MSherbinii/Binder-Jet-3D-Printer/Oasis make package 20181230/Electronics/HP45 standalone controller V3/Driver board V3.02/Driver mistake.PNG

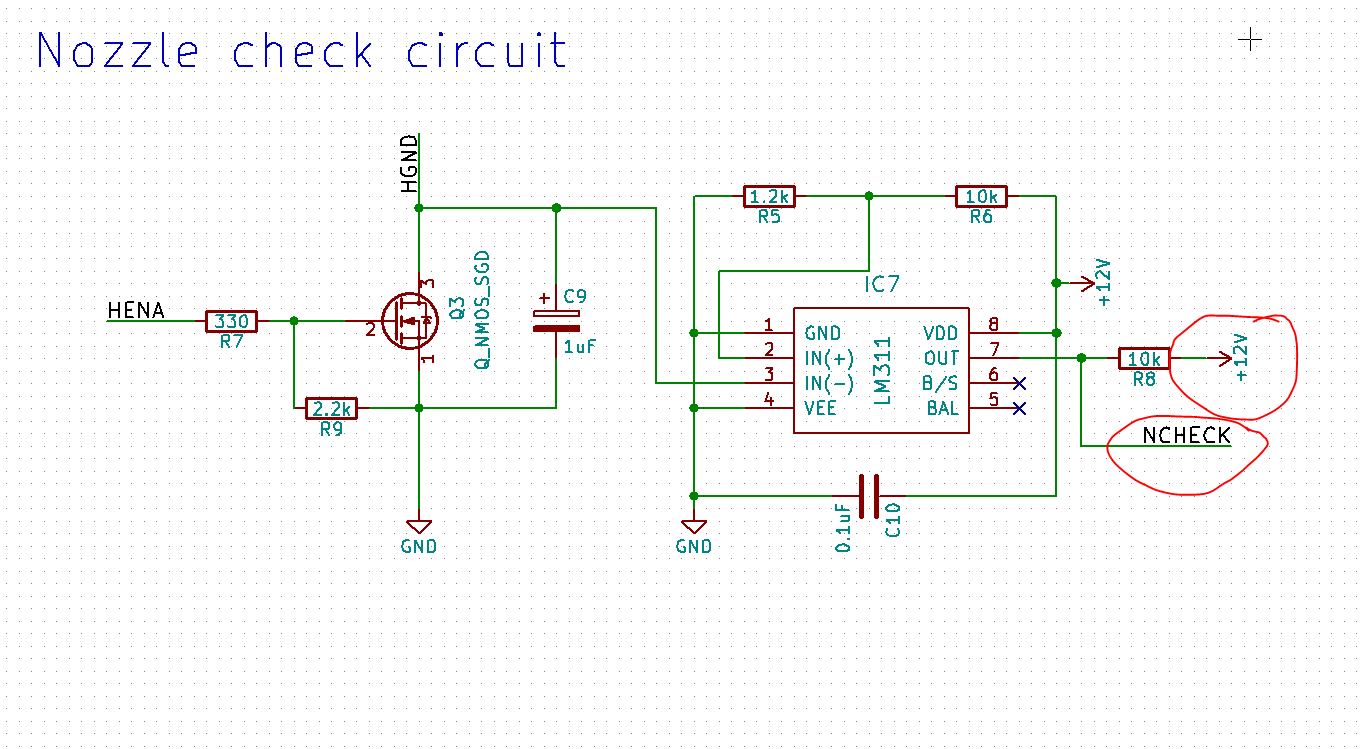
Oasis make package 20181230/Electronics/HP45 standalone controller V3/Driver board V3.02/Driver mistake.PNG
