MSherbinii/Binder-Jet-3D-Printer/Oasis Total BOM 20181018.xlsx

Sheet: Mechanical
ITEM NO. | PART NUMBER | DESCRIPTION | QTY. | suggested supplier | Notes | Suggested Link
1 | 5mm to M8 coupling | Shaft coupler | 2 | Reprapworld.com |  | https://reprapworld.com/products/motors_fans/couplers/z_axis_motor_coupling_m8/
2 | 15mm 150LPI Encoder Strip L=395 | Encoder strip | 1 | Ebay.com |  | https://www.ebay.com/itm/150-LPI-Encoder-Strip-Film-Raster-Film-2-7M-15mm-Format-Inkjet-Printer-2pcs-/271797731785
3 | 230V Input (brandless) | Power supply connector | 1
4 | 608 bearing | Miniature roller bearing | 1 | Misumi / reprapworld.com |  | https://reprapworld.nl/products/mechanisch/kogellagers/afgeschermde_kogellager_608zz/
5 | 624 bearing | Miniature roller bearing | 9 | Misumi / reprapworld.com |  | https://reprapworld.nl/products/mechanisch/kogellagers/afgeschermde_kogellager_624zz/
6 | 625 bearing | Miniature roller bearing | 2 | Misumi / reprapworld.com |  | https://reprapworld.nl/products/mechanisch/kogellagers/afgeschermde_kogellager_625zz/
7 | 685 bearing | Miniature roller bearing | 2 | Misumi / Ebay.com
8 | DIN 0125-1A M3 | Washer | 23
9 | DIN 0125-1A M4 | Washer | 96
10 | DIN 0125-1A M8 | Washer | 4
11 | DIN 0912 M3x6 | Hex socket head cap screw | 2
12 | DIN 0912 M3x10 | Hex socket head cap screw | 50
13 | DIN 0912 M3x20 | Hex socket head cap screw | 6
14 | DIN 0912 M4x12 | Hex socket head cap screw | 74
15 | DIN 0912 M4x20 | Hex socket head cap screw | 28
16 | DIN 0912 M4x30 | Hex socket head cap screw | 13
17 | DIN 0912 M6x12 | Hex socket head cap screw | 60
18 | DIN 0912 M6x16 | Hex socket head cap screw | 3
19 | DIN 0912 M8x30 | Hex socket head cap screw | 5
20 | DIN 0934 M3 | Hex nut | 4
21 | DIN 0934 M8 | Hex nut | 3
22 | DIN 0963 M3x10 | Slotted countersunk head screw | 6
23 | DIN 0963 M3x16 | Slotted countersunk head screw | 14
24 | DIN 0963 M4x12 | Slotted countersunk head screw | 33
25 | DIN 0985 M3 | Prevailing torque hex nut | 20
26 | DIN 0985 M4 | Prevailing torque hex nut | 53
27 | DIN 0985 M6 | Prevailing torque hex nut | 1
28 | DIN 7991 M6x12 | Hex socket countersunk head screw | 8
29 | DIN 9021- M5 | Fender washer | 1
30 | FJSN8-60 | Foot | 4 | Misumi | Any M8 adjustable foot will do
31 | GT2 pulley 20T 6mm | Timing pulley | 6 | Reprapworld.com |  | https://reprapworld.nl/products/mechanisch/riemschijf/gt2_riemschijf_20_tanden_6_mm_riem_5_mm_id/
32 | GT2 x 6mm Timing belt L120 Closed | Timing belt | 1 | Misumi
33 | GT2 x 6mm Timing belt L188 Closed | Timing belt | 1 | Reprapworld.com |  | https://reprapworld.nl/products/mechanisch/timing_belts/gt2x6mm_aandrijfriem_188mm_gesloten/
34 | GT2 x 6mm Timing belt L1000 | Timing belt | 1 | Reprapworld.com |  | https://reprapworld.nl/products/mechanisch/tandriemen/gt2x6mm_tandriem_per_meter/
35 | GT2 x 6mm Timing belt L1300 | Timing belt | 1 | Reprapworld.com |  | https://reprapworld.nl/products/mechanisch/tandriemen/gt2x6mm_tandriem_per_meter/
36 | GT2 x 6mm Timing belt L1500 | Timing belt | 1 | Reprapworld.com |  | https://reprapworld.nl/products/mechanisch/tandriemen/gt2x6mm_tandriem_per_meter/
37 | HBLFSN6 | 30mm single angle | 22 |  | 30x30mm 90 dergee angle
38 | HBLFSSW6 | 30mm double angle | 4 |  | 60x60mm 90 degree angle (double 30)
39 | HEDS-H9720 P | Encoder | 1 | Ebay.com |  | https://www.ebay.com/itm/AVAGO-HEDS-9740-150-Encoder-Optical-Sensor-360-DPI-for-Format-Inkjet-Printer-1-/282562554422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
40 | HFCL6-3030-S | Profile end cap | 10 | misumi | 30x30mm cap
41 | HFS6-3030-228 | 30x30 profile | 2 | misumi | Any 30x30mm, 8mm groove, M8 hole profile will do
42 | HFS6-3030-300 | 30x30 profile | 2 | misumi | Any 30x30mm, 8mm groove, M8 hole profile will do (Tap M8 on one side)
43 | HFS6-3030-315 | 30x30 profile | 3 | misumi | Any 30x30mm, 8mm groove, M8 hole profile will do
44 | HFS6-3030-402 | 30x30 profile | 2 | misumi | Any 30x30mm, 8mm groove, M8 hole profile will do
45 | HFS6-3030-410 | 30x30 profile | 2 | misumi | Any 30x30mm, 8mm groove, M8 hole profile will do
46 | HFS6-3030-480 | 30x30 profile | 2 | misumi | Any 30x30mm, 8mm groove, M8 hole profile will do (Tap M8 on one side)
47 | HFS6-3030-660 | 30x30 profile | 3 | misumi | Any 30x30mm, 8mm groove, M8 hole profile will do
48 | HFS6-3030-719 | 30x30 profile | 2 | misumi | Any 30x30mm, 8mm groove, M8 hole profile will do
49 | HFS6-3060-410 | 30x60 profile | 2 | misumi | Any 30x60mm, 8mm groove, M8 hole profile will do
50 | HFS6-3060-425 | 30x60 profile | 1 | misumi | Any 30x60mm, 8mm groove, M8 hole profile will do (Tap M8 on both sides)
51 | HFS6-3060-630 | 30x60 profile | 2 | misumi | Any 30x60mm, 8mm groove, M8 hole profile will do
52 | HHPSN6 | Hinge | 2 | misumi | Heart of hole to heart of hinge >15mm
53 | HNTAP6-3 | Profile nut M3 | 19 | misumi | M3 nut compatible with profile
54 | HNTAP6-4 | Profile nut M4 | 91 | misumi | M4 nut compatible with profile
55 | HNTAP6-6 | Profile nut M6 | 68 | misumi | M6 nut compatible with profile
56 | HP45 | Inkjet printhead | 1
57 | HP45 Standalone V3.00 PCBs | Inkjet controller | 1 | Ytec3D.com / Tindie
58 | LM8UU | Lineair bearing | 4
59 | MGN12 - L400 | Linear guide rail | 1 | Reprapworld.com |  | https://reprapworld.nl/products/lineaire_geleiding/mgn12_vierkant_slider_40_cm/#productdetail_doc
60 | MGN12 - L600 | Linear guide rail | 1 | Reprapworld.com |  | https://reprapworld.nl/products/lineaire_geleiding/mgn12_vierkante_slider_60_cm/
61 | MGN12H | Linear guide carriage | 2 | Reprapworld.com | 2 should have come with rail, additional 2 optional
62 | OA-Y10-P01-00 | Cover plate | 1
63 | OA-Y10-P02-00 | Guide shaft | 1
64 | OA-Y10-P03-00 | Shaft Mount | 1
65 | OA-Y10-P04-00 | Base Front cover | 1
66 | OA-Y10-P05-00 | Riser block | 1
67 | OA-Y10-P06-00 | Idler block | 1
68 | OA-Y10-P07-00 | Idler block | 1
69 | OA-Y10-P08-00 | Drive shaft | 1
70 | OA-Y10-P09-00 | Motor Block | 1
71 | OA-Y10-P10-00 | Back plate | 1
72 | OA-Y10-P11-00 | Top lid panel | 1
73 | OA-Y10-P12-00 | Side lid panel | 2
74 | OA-Y10-P13-00 | Front lid panel | 1
75 | OA-Y10-P15-00 | Front plate mount | 5
76 | OA-Y10-P16-00 | Bin rail | 1
77 | OA-Y10-P17-00 | Cable feedthrough | 1
78 | OA-Y10-P18-01 | Endstop counter block | 1
79 | OA-Y10-P20-00 | Side panel | 1
80 | OA-Y10-P21-00 | Lid stopper | 2
81 | OA-Y10-P22-00 | Cover end | 2
82 | OA-Y10-P23-00 | Bin rail | 2
83 | OA-Y10-P24-00 | Spacer | 2
84 | OA-Y10-P25-00 | Power inlet | 1 |  | Optional, depends on 230V power input
85 | OA-Y10-P26-00 | Shaft Mount | 1
86 | OA-Y10-P27-00 | Idler block | 1
87 | OA-Y15-P01-00 | Bin bottom | 1
88 | OA-Y15-P02-00 | Bin Side | 1
89 | OA-Y15-P04-00 | Bin Back | 2
90 | OA-Y15-P05-00 | Bin Side | 1
91 | OA-Y20-P01-01 | Gantry Free block | 1
92 | OA-Y20-P03-01 | Gantry fixed block | 1
93 | OA-Y20-P04-00 | Spreader Mount | 1
94 | OA-Y20-P04-00-M | Spreader mount | 1
95 | OA-Y20-P05-00 | Encoder Ribon End Block | 2
96 | OA-Y20-P06-01 | Motor mount | 1
97 | OA-Y20-P07-00 | Spreader pulley | 1
98 | OA-Y20-P08-00 | Endstop mount | 1
99 | OA-Y20-P10-00 | Cable pickup | 1
100 | OA-Y20-P11-00 | Cable support | 5
101 | OA-Y20-P12-00 | Cable mount | 1
102 | OA-Y20-P13-00 | Rotary shaft | 1 |  | DIY version, can be bought at misumi: SSFRHQ20-200-F20-P5-T20-Q5
103 | OA-Y30-P01-02 | Carriage block | 1
104 | OA-Y30-P02-01 | Belt clamp T2.5 | 6
105 | OA-Y30-P03-03 | Head carrier | 1
106 | OA-Y30-P04-00 | Cable pickup | 1
107 | OA-Y30-P05-01 | Head mounting bracket | 2
108 | OA-Y30-P06-00 | Head arm | 2
109 | OA-Y30-P07-00 | Head arm | 1
110 | OA-Y30-P08-00 | Head clamp | 1
111 | OA-Y40-P06-00 | Baseplate | 1
112 | OA-Y40-P07-00 | Overshoot riser | 1
113 | OA-Y40-P08-00 | Overshoot guide | 1
114 | OA-Y40-P09-00 | Hopper cilinder | 2
115 | OA-Y40-P10-00 | Hopper cilinder mount | 8
116 | OA-Y40-P11-00 | Piston bottom | 2
117 | OA-Y40-P12-00 | Bin gasket | 1
118 | OA-Y50-P02-00 | Piston lead screw | 2
119 | OA-Y50-P03-00 | Piston guide rod | 4
120 | OA-Y50-P07-00 | Piston base | 2
121 | OA-Y50-P08-00 | Piston motor bracket | 4
122 | OA-Y50-P09-00 | Piston seal | 4
123 | Omron 5e4t85 | Microswitch | 2 | Reprapworld.com |  | https://reprapworld.nl/products/elektronica/endstops/miniatuur_microswitch/
124 | Stepper NEMA 17 42BYGHW208 | Stepper motor | 2 | Reprapworld.com | max size 42x42x34mm
125 | Stepper NEMA 17 42BYGHW609 | Nema 42 stepper motor | 1 | Reprapworld.com | Max size 42x42x40mm | https://reprapworld.nl/products/motoren_fans/stepper_motors/nema17_stappenmotor_1_8_stap_4_08_kg_cm/
126 | Stepper NEMA 17 42BYGHW811 | NEMA 42 stepper motor | 1 | Reprapworld.com | Can be: Stepper NEMA 17 42BYGHW609 ass well Max size 42x42x40
127 | Universal 25mm gear motor | 25mm motor | 1 | Ebay.com | 300rpm adviced | https://www.ebay.com/itm/300RPM-Steel-25mm-DC-12V-High-Torque-Gear-Box-Powerful-motor-Electric-Motor/122759717586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
128 | UPCDG117 | Handle | 2

Sheet: Electrical
Qty. | Part name | type | Driver pad name | Controller pad name | Value | Package | remark
6 | SMD filter capacitor | Capacitor | C1, C6, C7, C8, C10, C11 |  | 0.1uF | SMD: 0603 | Minimum voltage: 16V
2 | SMD filter capacitor | Capacitor | C2, C4 |  | 1uF | SMD: 0603 | Minimum voltage: 16V
1 | SMD Electrol. Capacitor | Electrolytic capacitor | C9 |  | 1uF | Ø4x5.8 | Minimum voltage: 16V, height can vary
4 | SMD Electrol. Capacitor | Electrolytic capacitor | C3, C5 | C1, C2 | 100uF | Ø8x10 | Minimum voltage: 16V, height can vary
3 | SMD resistor | Resistor | R7, R11, R12 |  | 330Ω | SMD: 0603 | 1% preferred, power unimportant (>0,1W)
1 | SMD resistor | Resistor | R5 |  | 1,2kΩ | SMD: 0603 | 1% preferred, power unimportant (>0,1W)
6 | SMD resistor | Resistor | R1, R2, R3, R4, R9, R10 |  | 2,2kΩ | SMD: 0603 | 1% preferred, power unimportant (>0,1W)
2 | SMD resistor | Resistor | R6, R8 |  | 10kΩ | SMD: 0603 | 1% preferred, power unimportant (>0,1W)
1 | HCF4081 | IC | IC5 |  |  | SOIC-14 3.9x8.7mm | 15V power minimum
3 | HEF4017 | IC | IC1, IC3, IC6 |  |  | SOIC-16 3.9x9.9mm | 15V power minimum
2 | TLC59213 | IC | IC2, IC4 |  |  | TSSOP-20 4.4x6.5mm
1 | LM311 | IC | IC7 |  |  | SOIC-8 3.9x4.9mm
4 | Random smd diode | Diode |  | D1, D2, D3, D4 |  | SMD: 0603 | Optional static protection for encoder
1 | 7805 | Power regulator | U1 |  |  | TO-263-2
2 | PMV20XNER | Mosfet | Q1, Q2 |  |  | SOT-23 | Gate voltage < 3V
1 | SIRA12DP-T1-GE3 | Mosfet | Q3 |  |  | SO-8 (PowerPAK) | Low on resistance, non-power pack allowed
1 | HP45 connector | Connector | Con1 |  |  | 52 pin SMD | https://www.tindie.com/products/Dragonator/hp45-printhead-connector/
2 | Female header 1x16 | Connector | J1, J2 |  |  | 2,54mm pitch
2 | Male header 1x16 | Connector |  | J4, J5 |  | 2,54mm pitch
1 | Female header 1x3 | Connector |  | J6 |  | 2,54mm pitch | Optional
1 | Female header 1x4 | Connector |  | J3 |  | 2,54mm pitch | Optional
1 | Female header 1x5 | Connector |  | J2 |  | 2,54mm pitch | Optional
1 | Female headers for Teensy | Connector |  | (not on PCB) |  | 2,54mm pitch | Optional. 1x14 (2x), 1x5, 1x3 and 2x7 (or 2x 1x7)
1 | Screw terminal 1x3 | Connector |  | J1 |  | 1x3 3,5mm
1 | Teensy 3,2 | Microcontroller |  | uC1 |  | Teensy 3.2 w. header | Teensy may require additional male headers: 1x14 (2x), 1x5, 1x3 and SMD 2x7 @2,54mm
Other electronics
Qty. | Description |  | Part number
1 | HP45 standalone driver board
1 | HP45 standalone controller board
1 | 12V Power supply, 20A
2 | Fuse holder
2 | Fuse 10A
1 | Arduino UNO
1 | Arduino UNO CNC shield V3
1 | USB B cable
1 | USB Micro cable
2 | Microswitch
1 | N channel mosfet (Gate voltage < 5V, current > 2A)
1 | Resistor R330
1 | Resistor R10k
1 | Resistor R1k
1 | LED
1 | Ribbon cable 10 wire
1 | Optical encoder sensor |  | AVAGO HEDS-9740#150
plenty | zip-ties

Sheet: KiCAD Raw
Information on this page is RAW KiCad output and is for reference only!
HP45 Standalone V3,00 Driver
ref | value5 | footprint | lib | part
C1 | 0.1uF | Capacitors_SMD:C_0603 | device | C
C11 | 0.1uF | Capacitors_SMD:C_0603 | device | C
C10 | 0.1uF | Capacitors_SMD:C_0603 | device | C
C6 | 0.1uF | Capacitors_SMD:C_0603 | device | C
C8 | 0.1uF | Capacitors_SMD:C_0603 | device | C
C7 | 0.1uF | Capacitors_SMD:C_0603 | device | C
R5 | 1.2k | Resistors_SMD:R_0603 | device | R
C3 | 100uF | Capacitors_SMD:CP_Elec_8x10 | device | CP
C5 | 100uF | Capacitors_SMD:CP_Elec_8x10 | device | CP
R6 | 10k | Resistors_SMD:R_0603 | device | R
R8 | 10k | Resistors_SMD:R_0603 | device | R
C4 | 1uF | Capacitors_SMD:C_0603 | device | C
C9 | 1uF | Capacitors_SMD:CP_Elec_4x5.8 | device | CP
C2 | 1uF | Capacitors_SMD:C_0603 | device | C
R1 | 2.2k | Resistors_SMD:R_0603 | device | R
R2 | 2.2k | Resistors_SMD:R_0603 | device | R
R3 | 2.2k | Resistors_SMD:R_0603 | device | R
R4 | 2.2k | Resistors_SMD:R_0603 | device | R
R10 | 2.2k | Resistors_SMD:R_0603 | device | R
R9 | 2.2k | Resistors_SMD:R_0603 | device | R
R7 | 330 | Resistors_SMD:R_0603 | device | R
R11 | 330 | Resistors_SMD:R_0603 | device | R
R12 | 330 | Resistors_SMD:R_0603 | device | R
J1 | CONN_01X16 | Socket_Strips:Socket_Strip_Straight_1x16_Pitch2.54mm | conn | CONN_01X16
J2 | CONN_01X16 | Socket_Strips:Socket_Strip_Straight_1x16_Pitch2.54mm | conn | CONN_01X16
IC5 | HCF4081 | Housings_SOIC:SOIC-14_3.9x8.7mm_Pitch1.27mm | HP45 controller parts | HCF4081
IC1 | HEF4017 | Housings_SOIC:SOIC-16_3.9x9.9mm_Pitch1.27mm | HP45 controller parts | HEF4017
IC3 | HEF4017 | Housings_SOIC:SOIC-16_3.9x9.9mm_Pitch1.27mm | HP45 controller parts | HEF4017
IC6 | HEF4017 | Housings_SOIC:SOIC-16_3.9x9.9mm_Pitch1.27mm | HP45 controller parts | HEF4017
Con1 | HP45_connector | Electronics:HP45_SMD_connector | HP45 controller parts | HP45_connector
IC7 | LM311 | Housings_SOIC:SOIC-8_3.9x4.9mm_Pitch1.27mm | HP45 controller parts | LM311
Q2 | Q_NMOS_GSD | TO_SOT_Packages_SMD:SOT-23 | device | Q_NMOS_GSD
Q1 | Q_NMOS_GSD | TO_SOT_Packages_SMD:SOT-23 | device | Q_NMOS_GSD
Q3 | Q_NMOS_SGD | Electronics:SO-8_PowerPAK | device | Q_NMOS_SGD
IC2 | TLC59213 | Housings_SSOP:TSSOP-20_4.4x6.5mm_Pitch0.65mm | HP45 controller parts | TLC59213
IC4 | TLC59213 | Housings_SSOP:TSSOP-20_4.4x6.5mm_Pitch0.65mm | HP45 controller parts | TLC59213
PCB | HP45 standalone driver board
HP45 Standalone V3,00 controller
ref | value5 | footprint | lib | part
C2 | 100uF | Capacitors_SMD:CP_Elec_8x10 | device | CP
C1 | 100uF | Capacitors_SMD:CP_Elec_8x10 | device | CP
U1 | 7805 | TO_SOT_Packages_SMD:TO-263-2 | HP45 Standalone V3.00 Controller-cache | 7805-RESCUE-OA-HP45C3_Controller
J6 | CONN_01X03 | Socket_Strips:Socket_Strip_Straight_1x03_Pitch2.54mm | conn | CONN_01X03
J3 | CONN_01X04 | Socket_Strips:Socket_Strip_Straight_1x04_Pitch2.54mm | conn | CONN_01X04
J2 | CONN_01X05 | Socket_Strips:Socket_Strip_Straight_1x05_Pitch2.54mm | conn | CONN_01X05
J4 | CONN_01X16 | Socket_Strips:Socket_Strip_Straight_1x16_Pitch2.54mm | conn | CONN_01X16
J5 | CONN_01X16 | Socket_Strips:Socket_Strip_Straight_1x16_Pitch2.54mm | conn | CONN_01X16
D2 | D | Diodes_SMD:D_0603 | device | D
D1 | D | Diodes_SMD:D_0603 | device | D
D3 | D | Diodes_SMD:D_0603 | device | D
D4 | D | Diodes_SMD:D_0603 | device | D
JP1 | Jumper | Connectors:GS2 | device | Jumper
J1 | Screw_Terminal_1x03 | Electronics:3.5mm_screw_terminal | conn | Screw_Terminal_1x03
uC1 | Teensy_3.2_custom | Electronics:Teensy_3.2_custom | HP45 controller parts | Teensy_3.2_custom
PCB | HP45 standalone driver board
