MSherbinii/Binder-Jet-3D-Printer/Oasis lifting spreader A21 20181208/OA-Y21-A01-00 PnG20181208/OA-Y21-A01-00.SLDASM

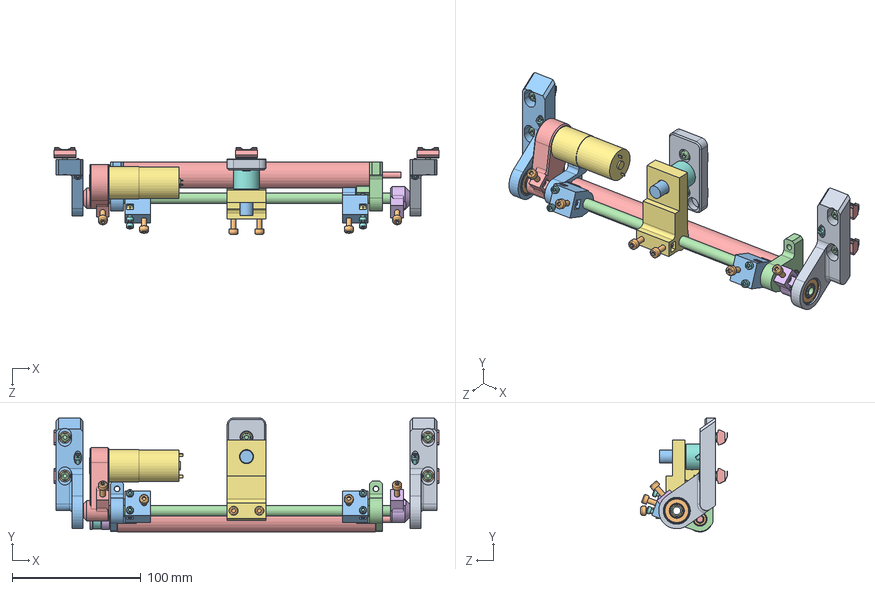
[picture p3: CAD file, 2022-12-10]
Oasis lifting spreader A21 20181208/OA-Y21-A01-00 PnG20181208/OA-Y21-A01-00.SLDASM
299.0 x 88.5 x 67.2 mm
OA-Y21-P01-00
608 bearing x 2
OA-Y21-P01-00-M
OA-Y21-P02-00
SSFRHQ20-200-F20-P5-T20-Q5
GT2 pulley 20T 6mm
Universal 25mm gear motor
GT2 x 6mm Timing belt L120 Closed
OA-Y20-P07-00
685 bearing x 2
OA-Y21-P03-00
OA-Y21-P03-00-M
OA-Y21-P04-00
OA-Y21-P05-00
OA-Y21-P06-00
Solenoid nmm
OA-Y21-P08-00
DIN 0125-1A M4 x 6
OA-Y21-P09-00 x 2
DIN 0912 M4x12 x 6
HNTAP6-4 x 6
DIN 0912 M3x6 x 3
DIN 0985 M3 x 6
DIN 0912 M3x20 x 6
DIN 0985 M4 x 8
DIN 0912 M4x20 x 6
DIN 7991 M10x20
