MSherbinii/Binder-Jet-3D-Printer/Oasis lifting spreader A21 20181208/OA-Y21-A01-00 PnG20181208/OA-Y21-P01-00-M.SLDPRT

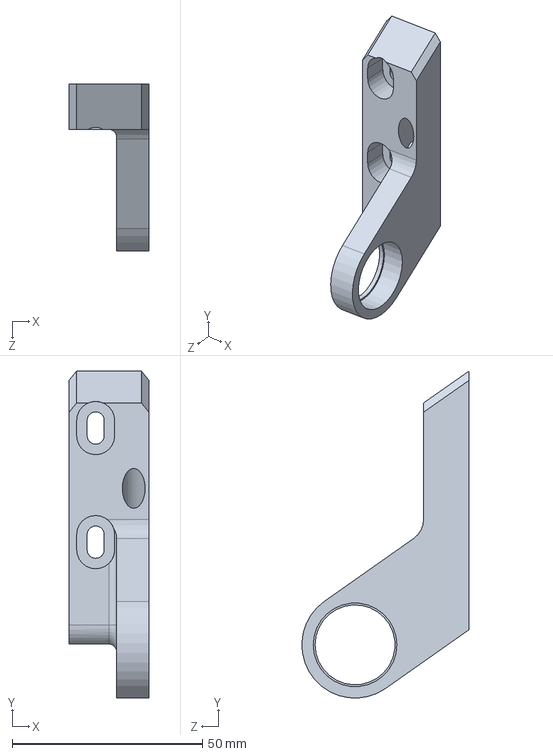
[picture p4: CAD file, 2022-12-10]
Oasis lifting spreader A21 20181208/OA-Y21-A01-00 PnG20181208/OA-Y21-P01-00-M.SLDPRT
21.0 x 86.0 x 44.0 mm
