MSherbinii/Binder-Jet-3D-Printer/Oasis lifting spreader A21 20181208/STL/OA-Y21-P03-00.STL

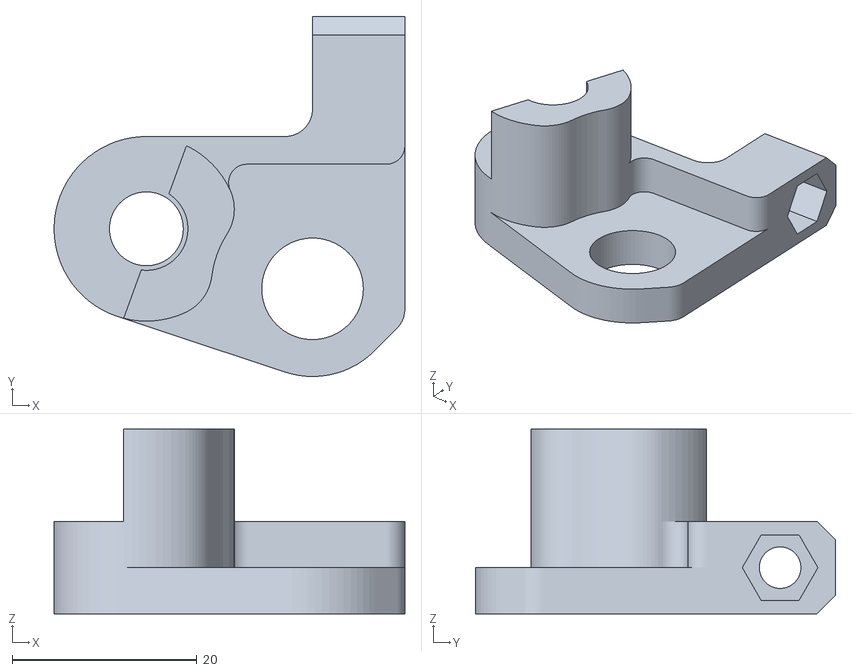
[picture p5: CAD file, 2022-12-10]
Oasis lifting spreader A21 20181208/STL/OA-Y21-P03-00.STL
38.0 x 39.0 x 20.0
