MSherbinii/Binder-Jet-3D-Printer/Oasis make package 20181230/Electronics/3D files/HP45 Standalone V3.00 PCBs.SLDPRT

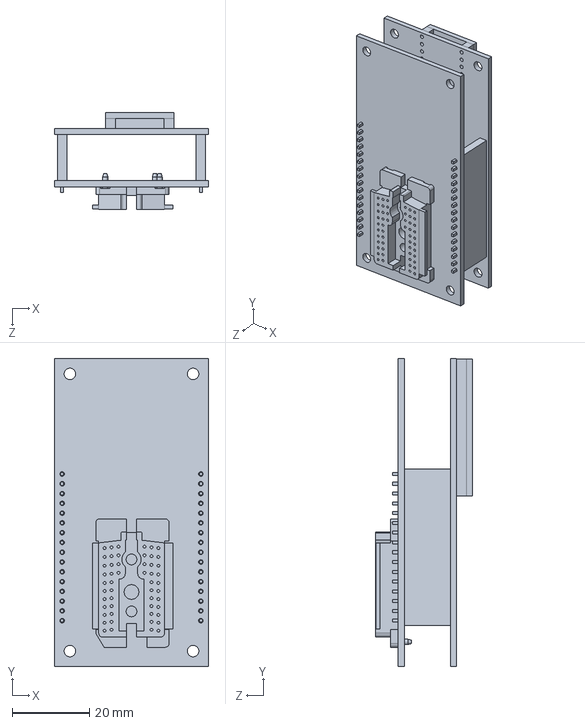
[picture p6: CAD file, 2022-12-10]
Oasis make package 20181230/Electronics/3D files/HP45 Standalone V3.00 PCBs.SLDPRT
40.0 x 80.0 x 25.2 mm
