MSherbinii/Binder-Jet-3D-Printer/Oasis make package 20181230/Mechanical/OA-Y10 Baseframe/OA-Y10-P23-00.STEP

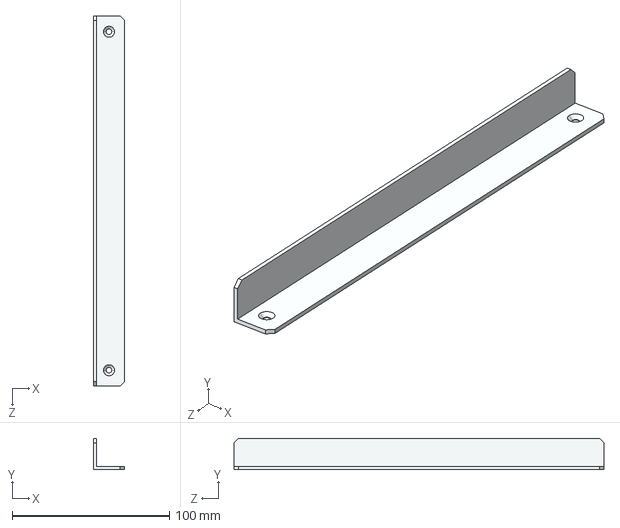
[picture p7: CAD file, 2022-12-10]
Oasis make package 20181230/Mechanical/OA-Y10 Baseframe/OA-Y10-P23-00.STEP
20.0 x 20.0 x 235.0 mm
