MSherbinii/Binder-Jet-3D-Printer/Oasis make package 20181230/Mechanical/OA-Y15 Overshoot bin/OA-Y15-P05-00.STEP

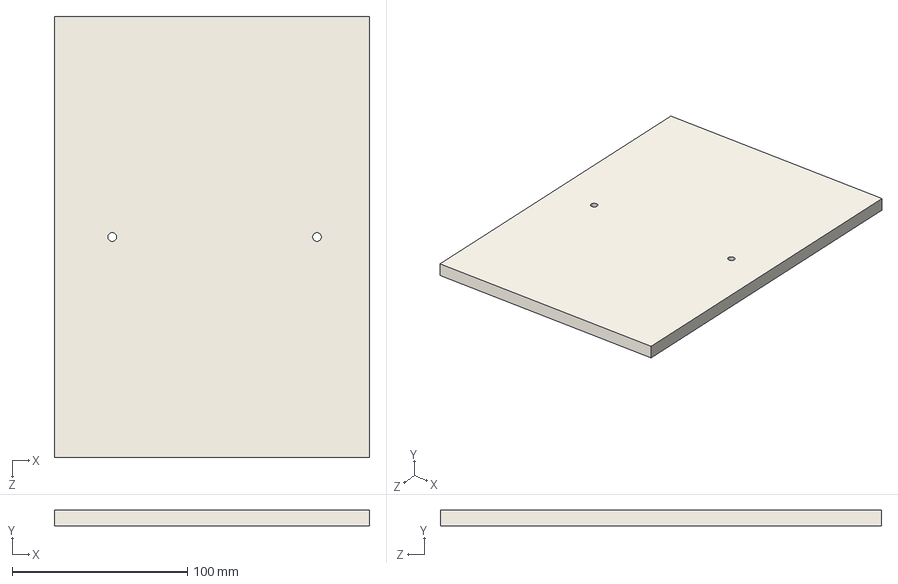
[picture p8: CAD file, 2022-12-10]
Oasis make package 20181230/Mechanical/OA-Y15 Overshoot bin/OA-Y15-P05-00.STEP
180.0 x 9.00 x 252.0 mm
