MSherbinii/Binder-Jet-3D-Printer/Oasis make package 20181230/Mechanical/OA-Y20 Gantry/OA-Y20-P03-01.STEP

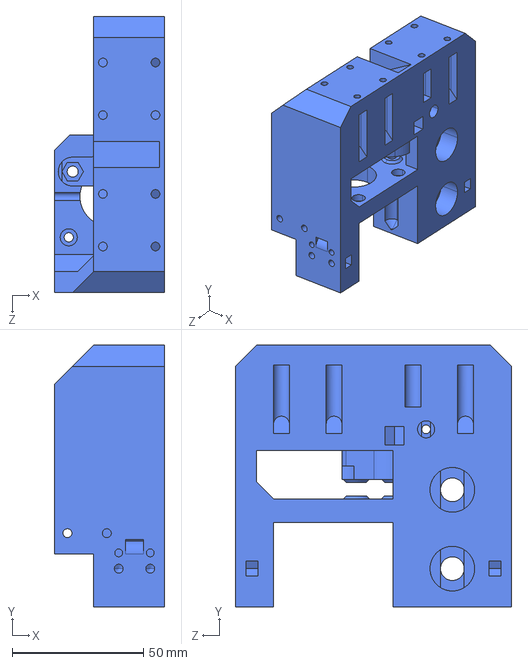
[picture p9: CAD file, 2022-12-10]
Oasis make package 20181230/Mechanical/OA-Y20 Gantry/OA-Y20-P03-01.STEP
42.0 x 99.5 x 105.0 mm
