MSherbinii/Binder-Jet-3D-Printer/Oasis make package 20181230/Mechanical/OA-Y30 Carriage/OA-Y30-P06-00.STEP

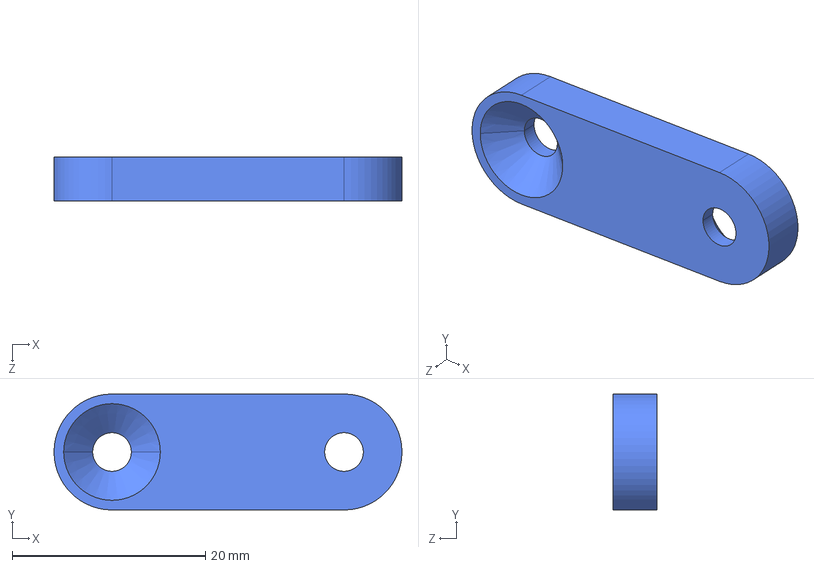
[picture p10: CAD file, 2022-12-10]
Oasis make package 20181230/Mechanical/OA-Y30 Carriage/OA-Y30-P06-00.STEP
36.0 x 12.0 x 4.50 mm
