MSherbinii/Binder-Jet-3D-Printer/Oasis make package 20181230/Mechanical/OA-Y40 Build surface/OA-Y40-P08-00.STEP

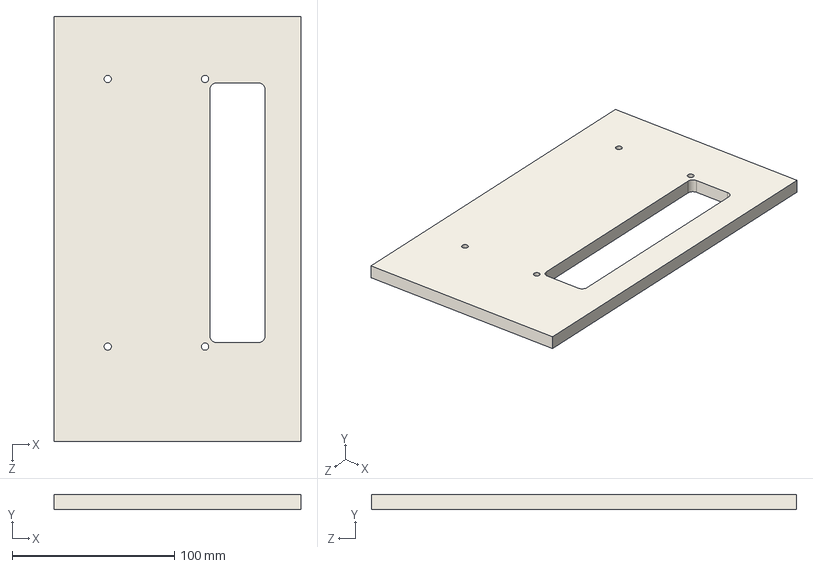
[picture p11: CAD file, 2022-12-10]
Oasis make package 20181230/Mechanical/OA-Y40 Build surface/OA-Y40-P08-00.STEP
152.0 x 9.00 x 262.0 mm
