MSherbinii/Binder-Jet-3D-Printer/Oasis make package 20181230/Mechanical/OA-Y60 Additional tools/OA-Y60-P01-00.STEP

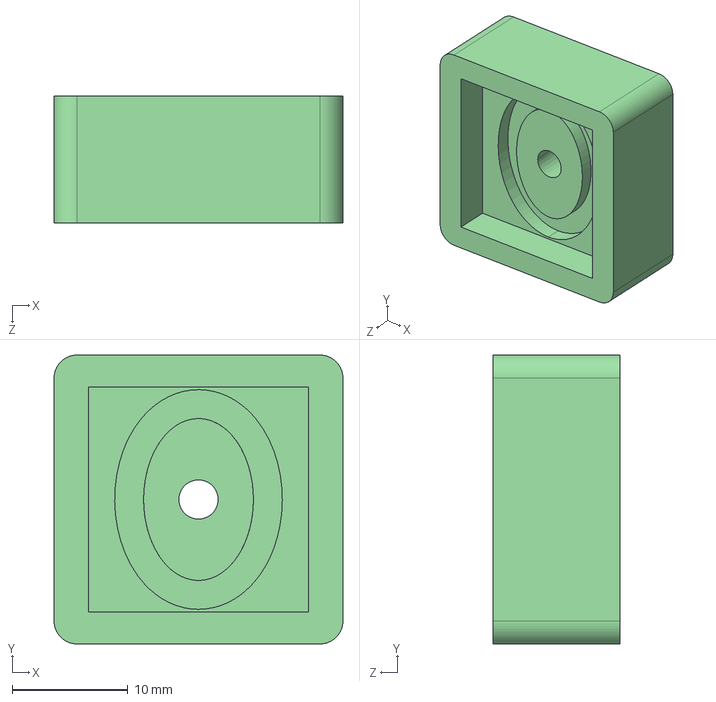
[picture p12: CAD file, 2022-12-10]
Oasis make package 20181230/Mechanical/OA-Y60 Additional tools/OA-Y60-P01-00.STEP
25.0 x 25.0 x 11.0 mm
