MSherbinii/Binder-Jet-3D-Printer/Oasis lifting spreader A21 20181208/OA-Y21-A01-00 PnG20181208/HNTAP6-4.SLDPRT

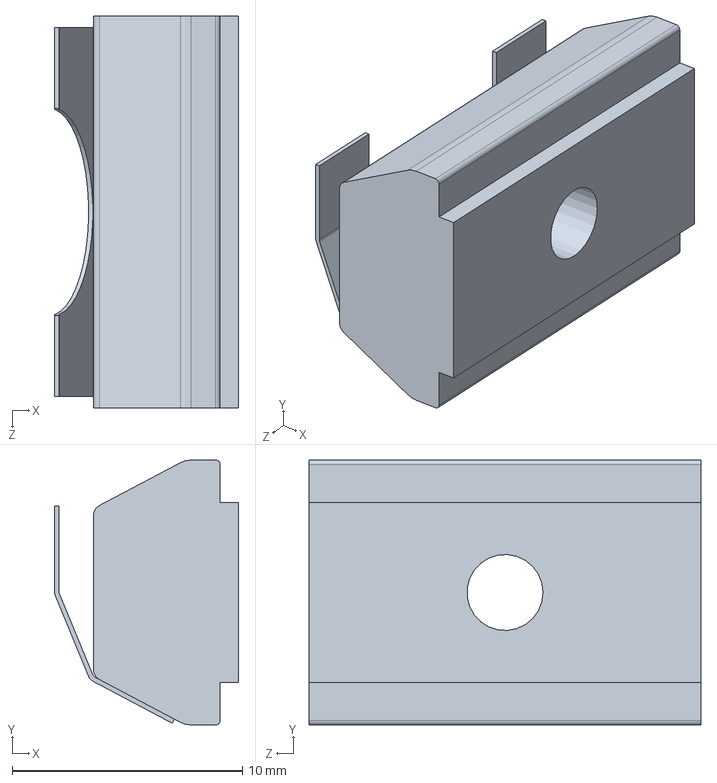
[picture p13: CAD file, 2022-12-10]
Oasis lifting spreader A21 20181208/OA-Y21-A01-00 PnG20181208/HNTAP6-4.SLDPRT
8.00 x 11.5 x 17.0 mm
