MSherbinii/Binder-Jet-3D-Printer/Oasis lifting spreader A21 20181208/STL/OA-Y21-P08-00.STL

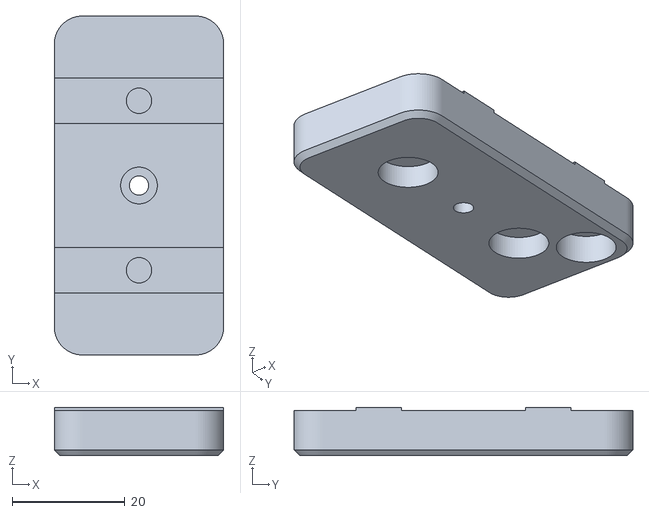
[picture p14: CAD file, 2022-12-10]
Oasis lifting spreader A21 20181208/STL/OA-Y21-P08-00.STL
30.0 x 60.0 x 8.50
