MSherbinii/Binder-Jet-3D-Printer/Oasis make package 20181230/Electronics/3D files/HP45 Breakout CS3.SLDPRT

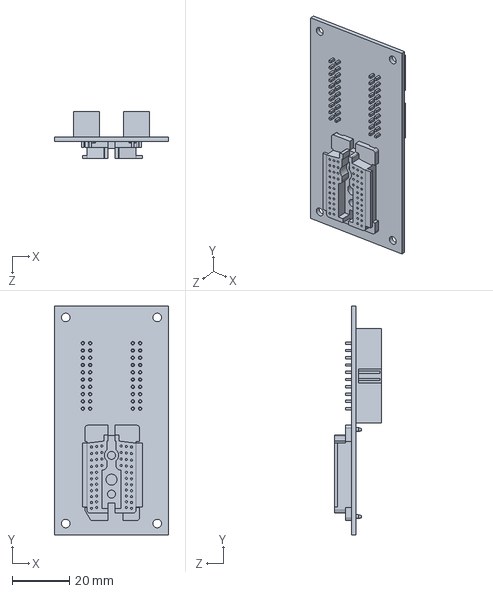
[picture p15: CAD file, 2022-12-10]
Oasis make package 20181230/Electronics/3D files/HP45 Breakout CS3.SLDPRT
40.0 x 80.0 x 16.5 mm
