MSherbinii/Binder-Jet-3D-Printer/Oasis make package 20181230/Mechanical/OA-Y10 Baseframe/OA-Y10-P20-00.STEP

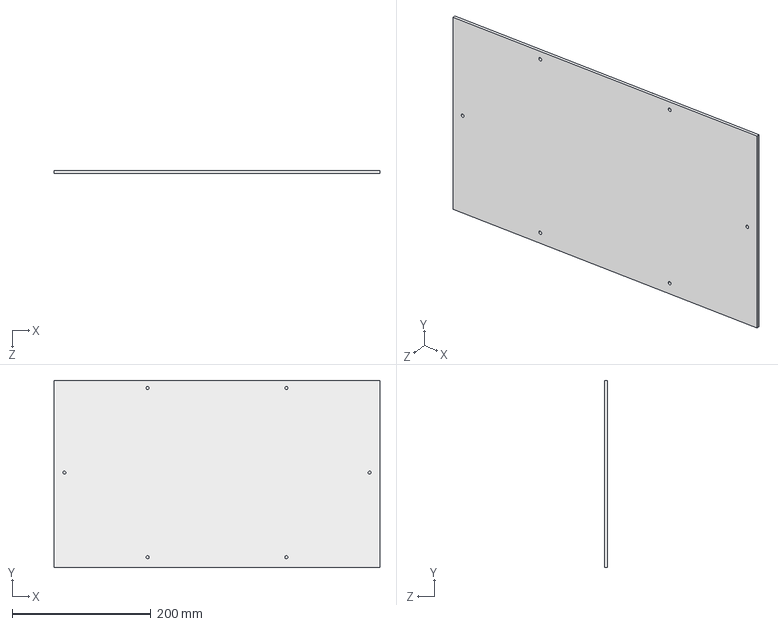
[picture p16: CAD file, 2022-12-10]
Oasis make package 20181230/Mechanical/OA-Y10 Baseframe/OA-Y10-P20-00.STEP
470.0 x 270.0 x 4.00 mm
