MSherbinii/Binder-Jet-3D-Printer/Oasis make package 20181230/Mechanical/OA-Y20 Gantry/OA-Y20-P13-00.STEP

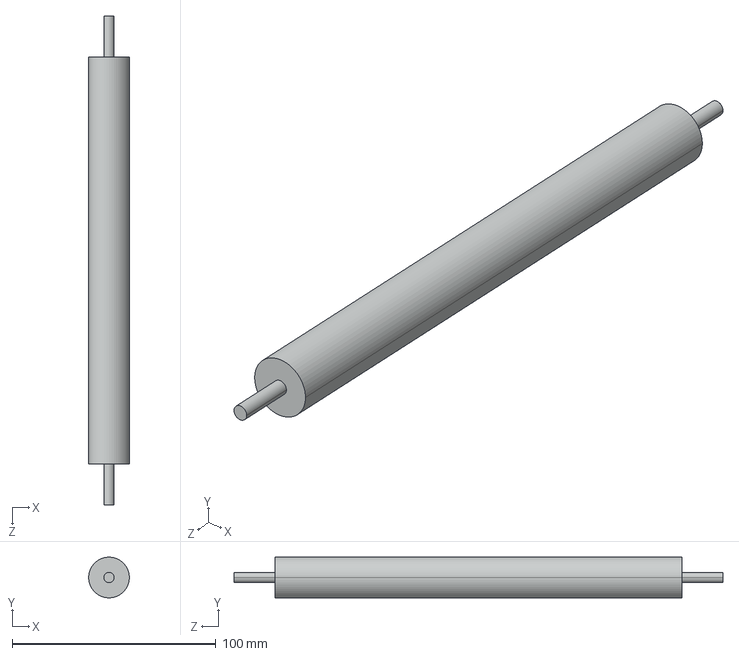
[picture p18: CAD file, 2022-12-10]
Oasis make package 20181230/Mechanical/OA-Y20 Gantry/OA-Y20-P13-00.STEP
20.0 x 20.0 x 240.0 mm
