MSherbinii/Binder-Jet-3D-Printer/Oasis make package 20181230/Mechanical/OA-Y30 Carriage/OA-Y30-P01-02.STEP

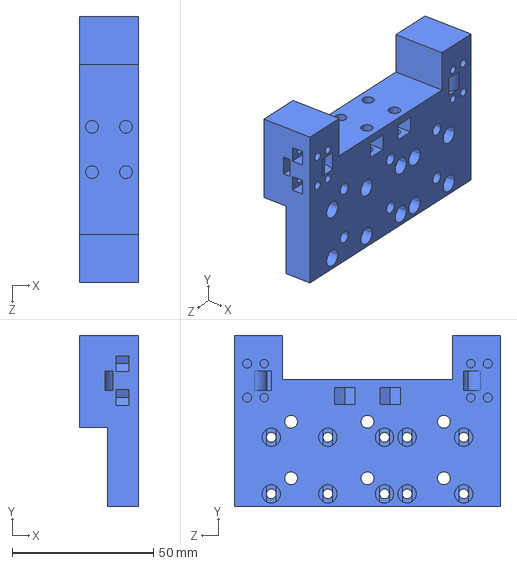
[picture p19: CAD file, 2022-12-10]
Oasis make package 20181230/Mechanical/OA-Y30 Carriage/OA-Y30-P01-02.STEP
21.0 x 60.5 x 94.0 mm
