MSherbinii/Binder-Jet-3D-Printer/Oasis make package 20181230/Mechanical/OA-Y40 Build surface/OA-Y40-P07-00.STEP

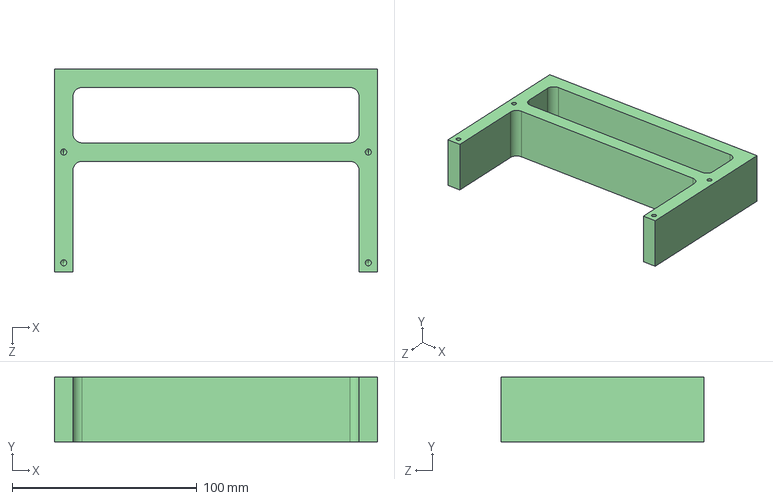
[picture p20: CAD file, 2022-12-10]
Oasis make package 20181230/Mechanical/OA-Y40 Build surface/OA-Y40-P07-00.STEP
175.0 x 35.0 x 110.0 mm
