MSherbinii/Binder-Jet-3D-Printer/Oasis make package 20181230/Mechanical/OA-Y50 Piston/OA-Y50-P07-00.STEP

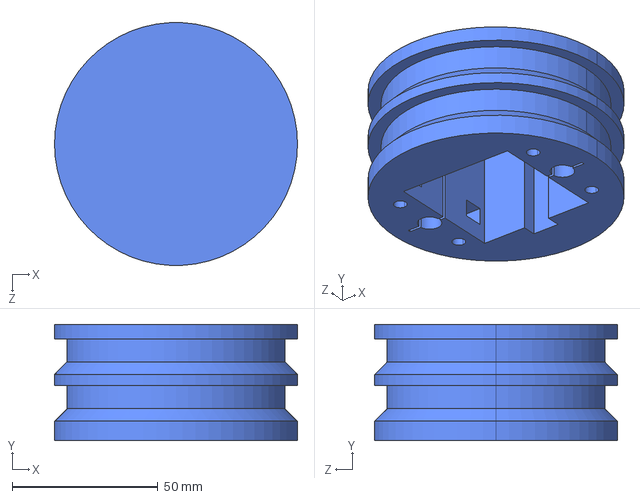
[picture p21: CAD file, 2022-12-10]
Oasis make package 20181230/Mechanical/OA-Y50 Piston/OA-Y50-P07-00.STEP
83.5 x 40.0 x 83.4 mm
