MSherbinii/Binder-Jet-3D-Printer/Oasis source files 20181014/Electrical/HP45 Standalone V3.00/3D files/HP45 Breakout CS3.STEP

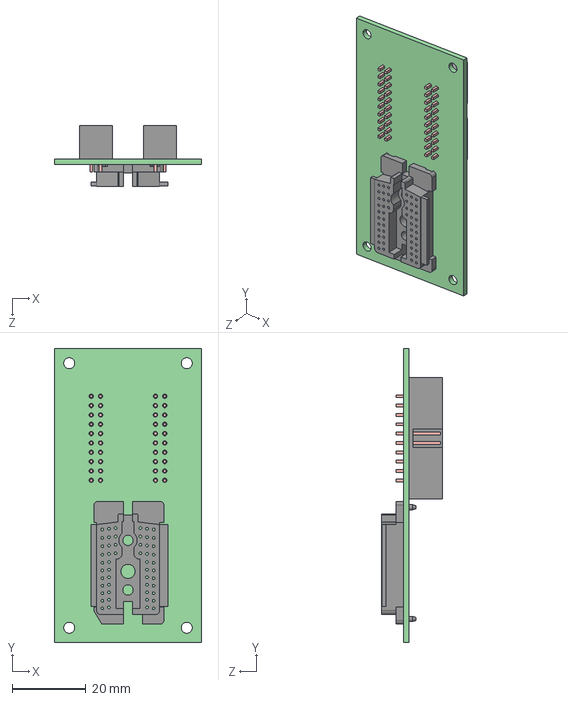
[picture p22: CAD file, 2022-12-10]
Oasis source files 20181014/Electrical/HP45 Standalone V3.00/3D files/HP45 Breakout CS3.STEP
40.0 x 80.0 x 16.5 mm
