MSherbinii/Binder-Jet-3D-Printer/Oasis lifting spreader A21 20181208/OA-Y21-A01-00 PnG20181208/Universal 25mm gear motor.SLDPRT

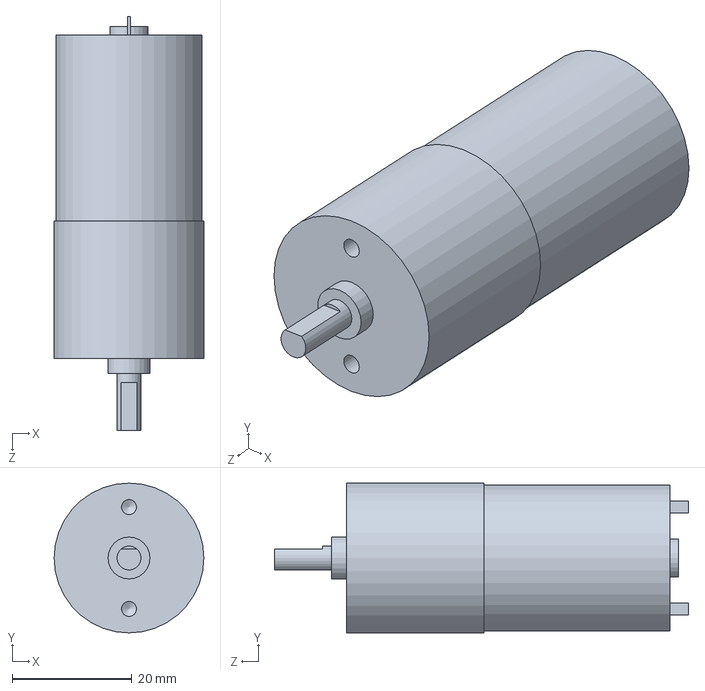
[picture p23: CAD file, 2022-12-10]
Oasis lifting spreader A21 20181208/OA-Y21-A01-00 PnG20181208/Universal 25mm gear motor.SLDPRT
25.0 x 25.0 x 69.1 mm
