MSherbinii/Binder-Jet-3D-Printer/Oasis lifting spreader A21 20181208/STL/OA-Y21-P06-00.STL

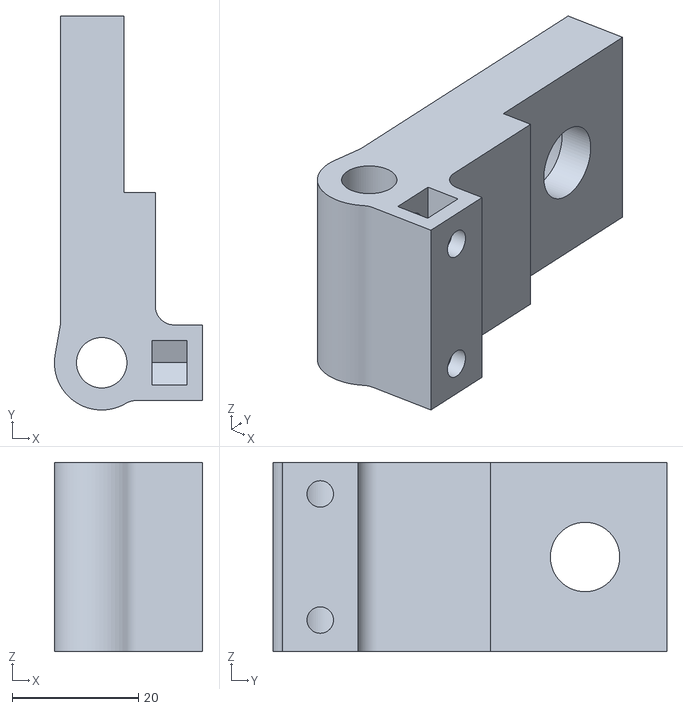
[picture p24: CAD file, 2022-12-10]
Oasis lifting spreader A21 20181208/STL/OA-Y21-P06-00.STL
23.5 x 62.5 x 30.0
