MSherbinii/Binder-Jet-3D-Printer/Oasis make package 20181230/Mechanical/OA-Y10 Baseframe/OA-Y10-P15-00.STEP

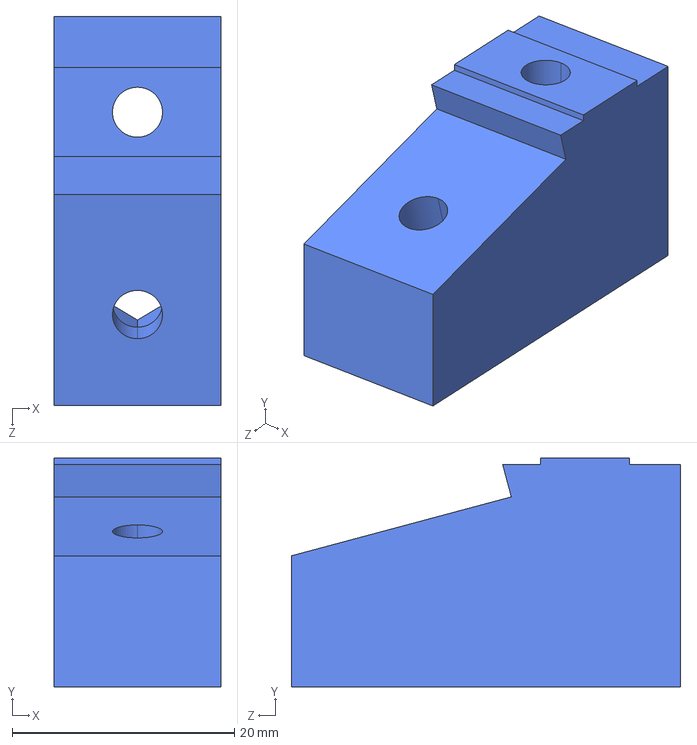
[picture p25: CAD file, 2022-12-10]
Oasis make package 20181230/Mechanical/OA-Y10 Baseframe/OA-Y10-P15-00.STEP
15.0 x 20.6 x 35.0 mm
