MSherbinii/Binder-Jet-3D-Printer/Oasis make package 20181230/Mechanical/OA-Y20 Gantry/OA-Y20-P04-00-M.STEP

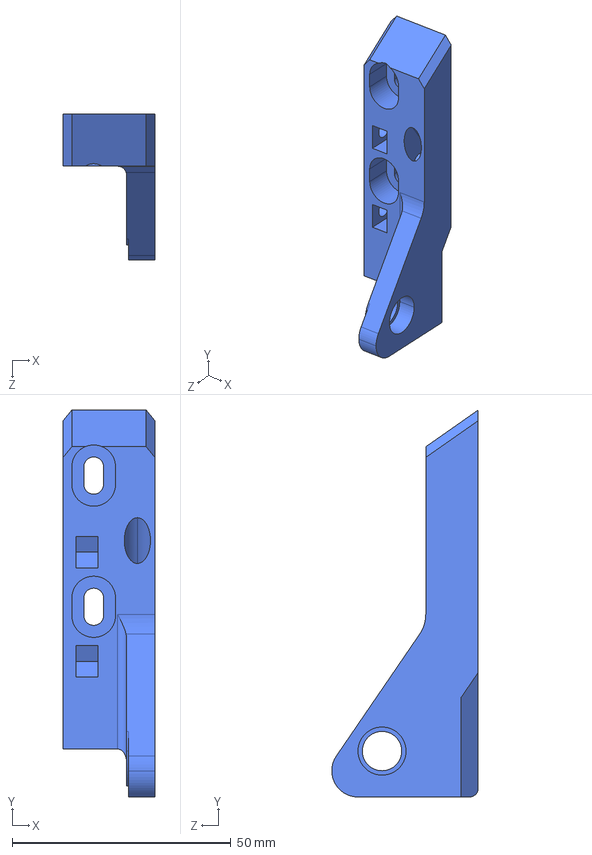
[picture p27: CAD file, 2022-12-10]
Oasis make package 20181230/Mechanical/OA-Y20 Gantry/OA-Y20-P04-00-M.STEP
21.0 x 88.5 x 33.5 mm
