MSherbinii/Binder-Jet-3D-Printer/Oasis make package 20181230/Mechanical/OA-Y30 Carriage/OA-Y30-P04-00.STEP

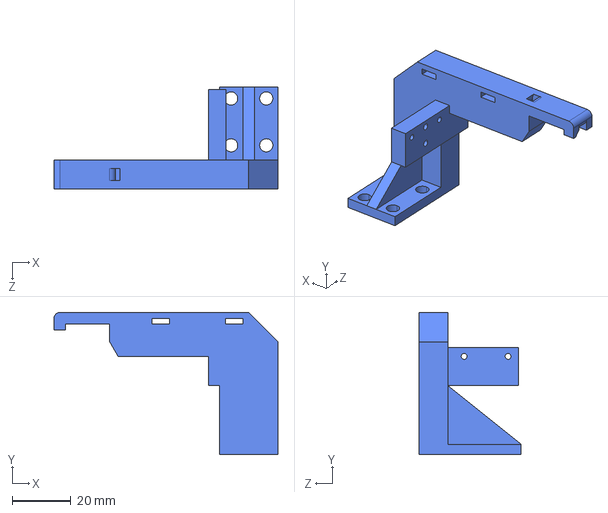
[picture p28: CAD file, 2022-12-10]
Oasis make package 20181230/Mechanical/OA-Y30 Carriage/OA-Y30-P04-00.STEP
76.5 x 48.5 x 35.0 mm
