MSherbinii/Binder-Jet-3D-Printer/Oasis make package 20181230/Mechanical/OA-Y40 Build surface/OA-Y40-P10-00.STEP

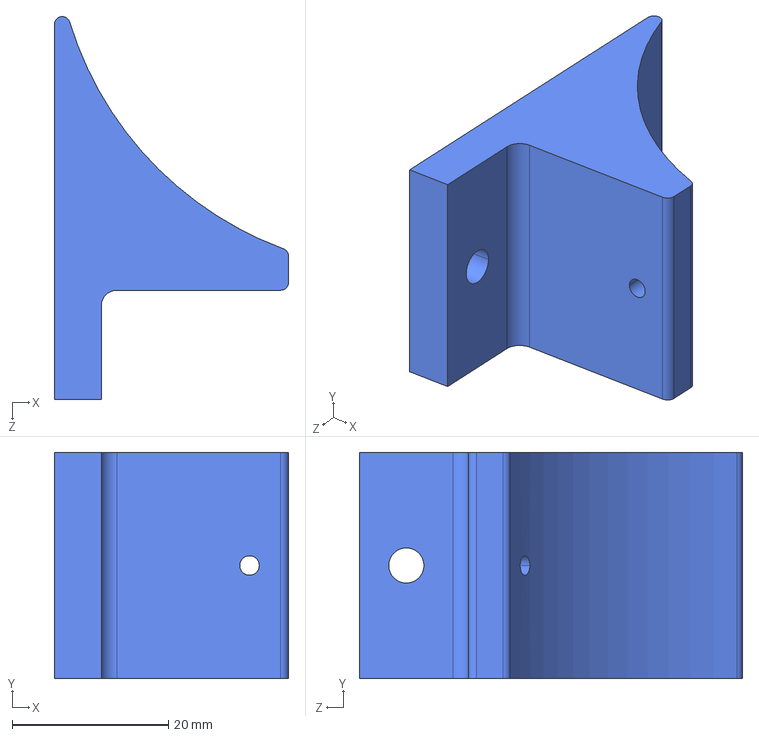
[picture p29: CAD file, 2022-12-10]
Oasis make package 20181230/Mechanical/OA-Y40 Build surface/OA-Y40-P10-00.STEP
30.0 x 29.0 x 49.1 mm
