MSherbinii/Binder-Jet-3D-Printer/Oasis make package 20181230/Mechanical/OA-Y50 Piston/OA-Y50-P08-00.STEP

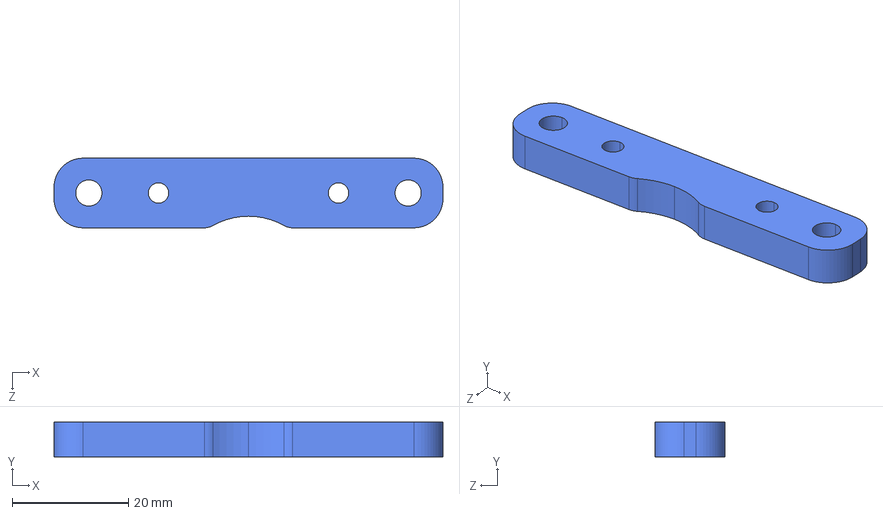
[picture p30: CAD file, 2022-12-10]
Oasis make package 20181230/Mechanical/OA-Y50 Piston/OA-Y50-P08-00.STEP
67.0 x 6.00 x 12.0 mm
