MSherbinii/Binder-Jet-3D-Printer/Oasis lifting spreader A21 20181208/OA-Y21-A01-00 PnG20181208/OA-Y20-P07-00.SLDPRT

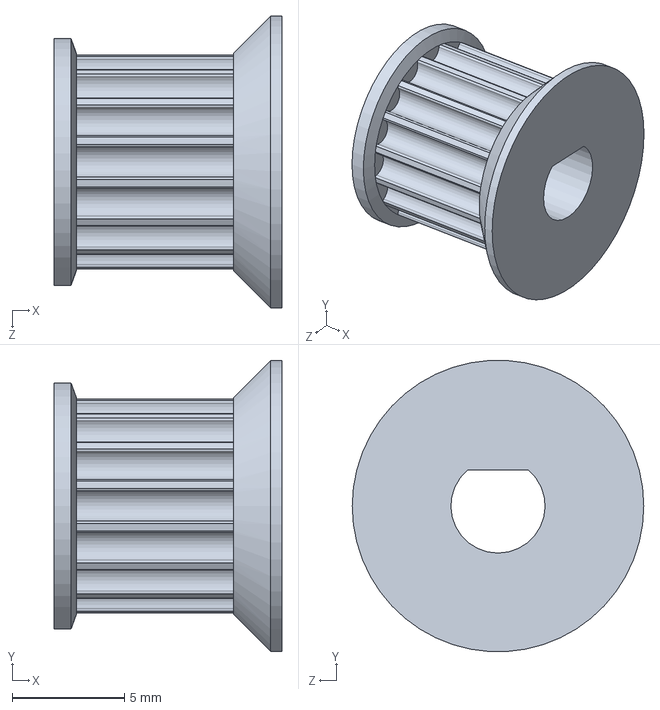
[picture p31: CAD file, 2022-12-10]
Oasis lifting spreader A21 20181208/OA-Y21-A01-00 PnG20181208/OA-Y20-P07-00.SLDPRT
10.2 x 13.0 x 13.0 mm
