MSherbinii/Binder-Jet-3D-Printer/Oasis make package 20181230/Mechanical/OA-Y10 Baseframe/OA-Y10-P06-00.STEP

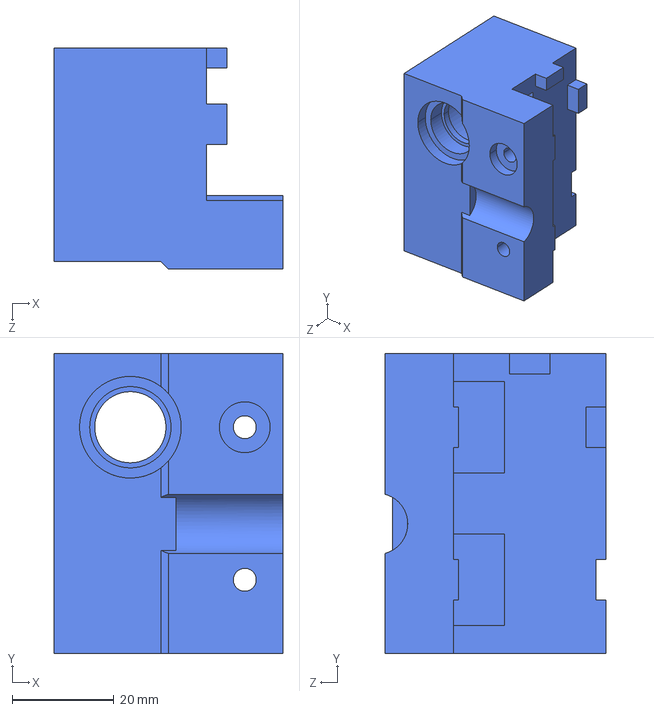
[picture p32: CAD file, 2022-12-10]
Oasis make package 20181230/Mechanical/OA-Y10 Baseframe/OA-Y10-P06-00.STEP
45.0 x 59.0 x 43.5 mm
