MSherbinii/Binder-Jet-3D-Printer/Oasis make package 20181230/Mechanical/OA-Y15 Overshoot bin/OA-Y15-P01-00.STEP

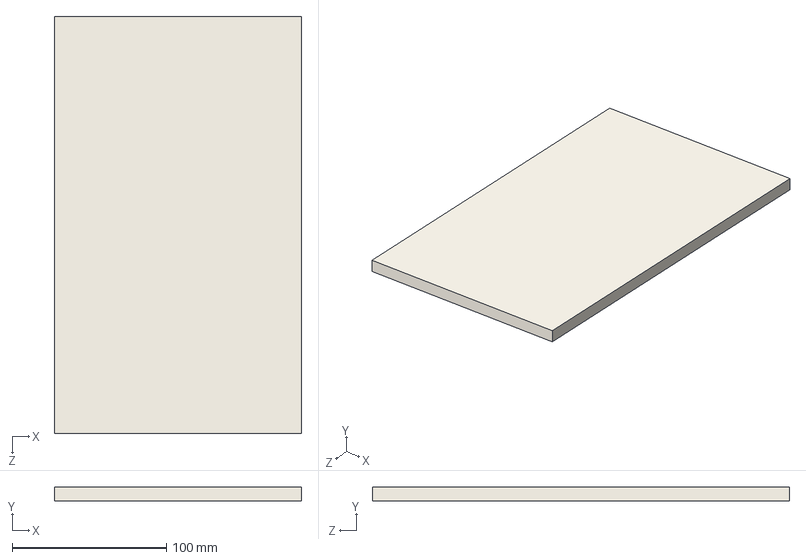
[picture p33: CAD file, 2022-12-10]
Oasis make package 20181230/Mechanical/OA-Y15 Overshoot bin/OA-Y15-P01-00.STEP
160.0 x 9.00 x 270.0 mm
