MSherbinii/Binder-Jet-3D-Printer/Oasis make package 20181230/Mechanical/OA-Y20 Gantry/OA-Y20-P05-00.STEP

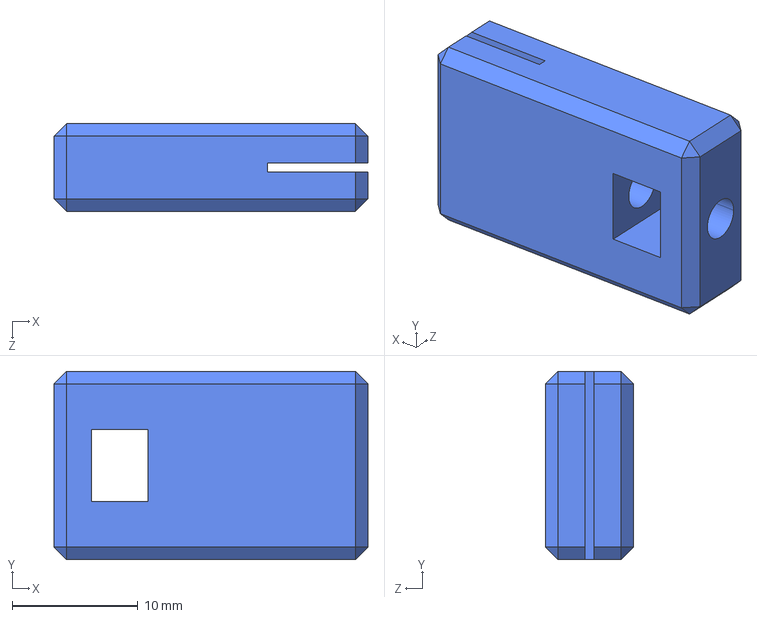
[picture p34: CAD file, 2022-12-10]
Oasis make package 20181230/Mechanical/OA-Y20 Gantry/OA-Y20-P05-00.STEP
25.0 x 15.0 x 7.00 mm
