MSherbinii/Binder-Jet-3D-Printer/Oasis make package 20181230/Mechanical/OA-Y30 Carriage/OA-Y30-P03-03.STEP

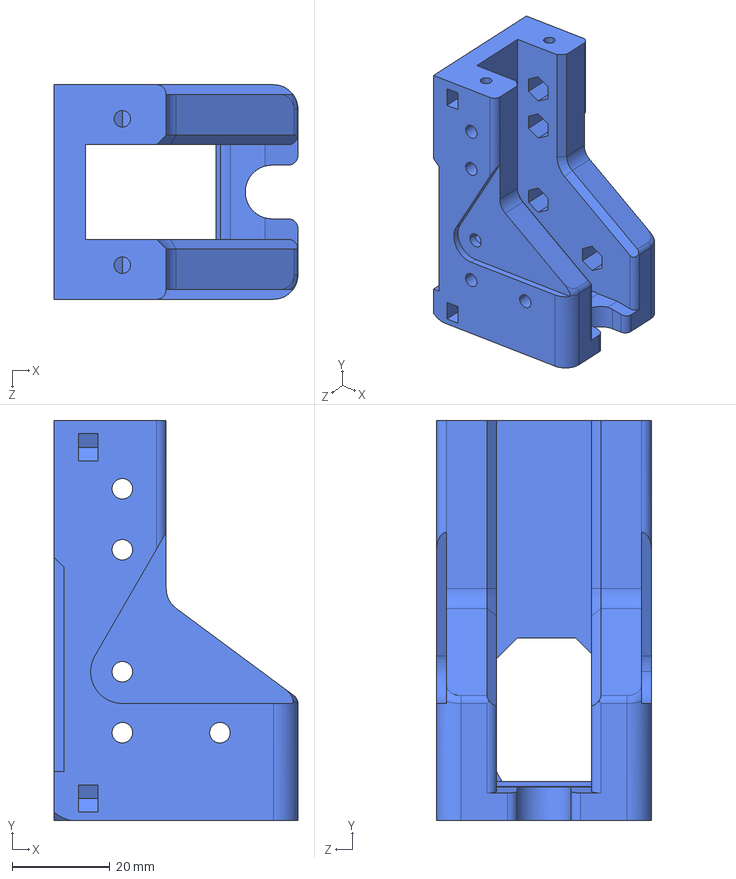
[picture p35: CAD file, 2022-12-10]
Oasis make package 20181230/Mechanical/OA-Y30 Carriage/OA-Y30-P03-03.STEP
50.0 x 82.0 x 44.0 mm
