MSherbinii/Binder-Jet-3D-Printer/Oasis make package 20181230/Mechanical/OA-Y40 Build surface/OA-Y40-P11-00.STEP

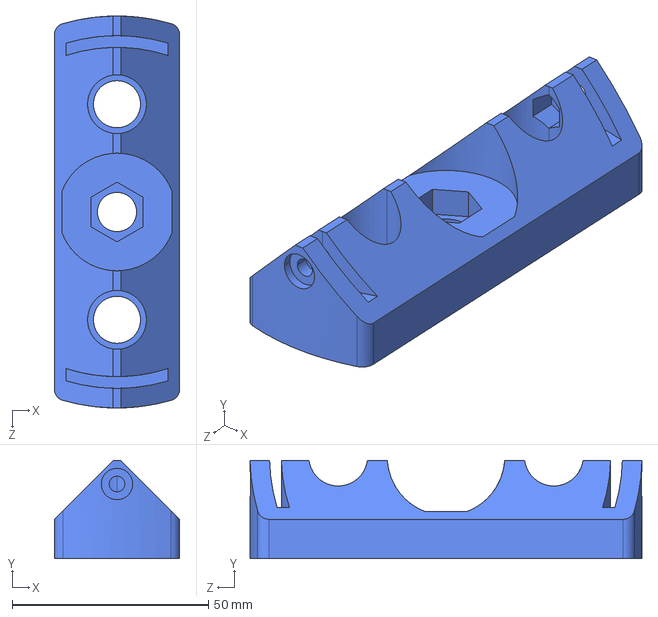
[picture p36: CAD file, 2022-12-10]
Oasis make package 20181230/Mechanical/OA-Y40 Build surface/OA-Y40-P11-00.STEP
32.0 x 25.0 x 100.0 mm
