MSherbinii/Binder-Jet-3D-Printer/Oasis make package 20181230/Mechanical/OA-Y50 Piston/OA-Y50-A02-00.STEP

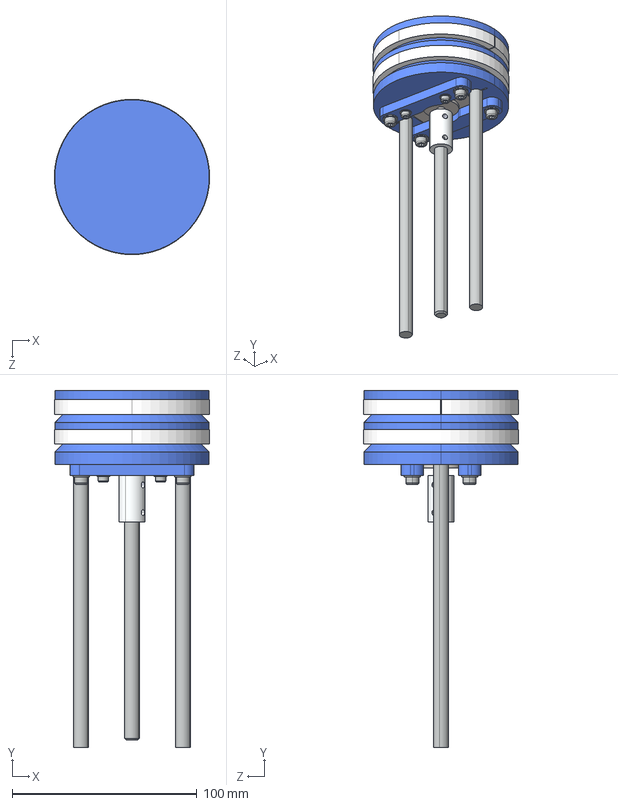
[picture p37: CAD file, 2022-12-10]
Oasis make package 20181230/Mechanical/OA-Y50 Piston/OA-Y50-A02-00.STEP
84.0 x 193.0 x 84.0 mm
OA-Y50-P07-00
Stepper NEMA 17 42BYGHW208
OA-Y50-P02-00
OA-Y50-P03-00 x 2
5mm to M8 coupling
DIN 0985 M4 x 4
OA-Y50-P08-00 x 2
DIN 0125-1A M4 x 4
DIN 0125-1A M3 x 4
DIN 0912 M4x20 x 4
DIN 0912 M3x10 x 4
OA-Y50-P09-00 x 2
