MSherbinii/Binder-Jet-3D-Printer/Oasis lifting spreader A21 20181208/STL/OA-Y21-P09-00.STL

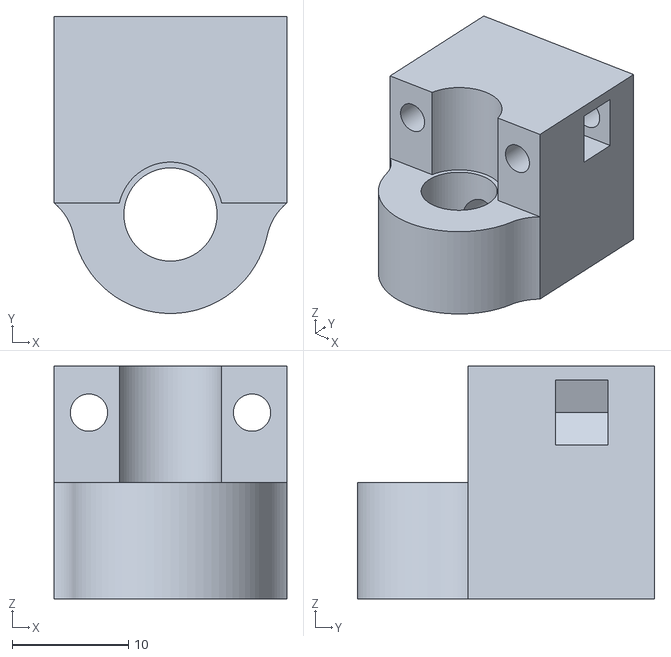
[picture p38: CAD file, 2022-12-10]
Oasis lifting spreader A21 20181208/STL/OA-Y21-P09-00.STL
20.0 x 25.5 x 20.0
