MSherbinii/Binder-Jet-3D-Printer/Oasis make package 20181230/Mechanical/OA-Y10 Baseframe/OA-Y10-P10-00.STEP

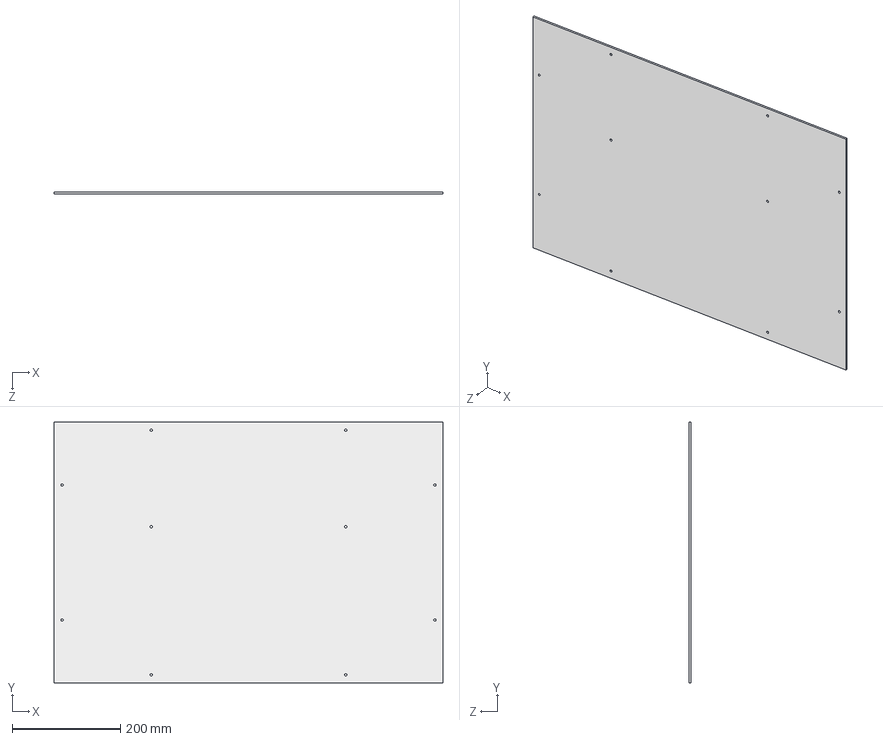
[picture p39: CAD file, 2022-12-10]
Oasis make package 20181230/Mechanical/OA-Y10 Baseframe/OA-Y10-P10-00.STEP
720.0 x 483.0 x 4.00 mm
