MSherbinii/Binder-Jet-3D-Printer/Oasis make package 20181230/Mechanical/OA-Y15 Overshoot bin/OA-Y15-A01-00.STEP

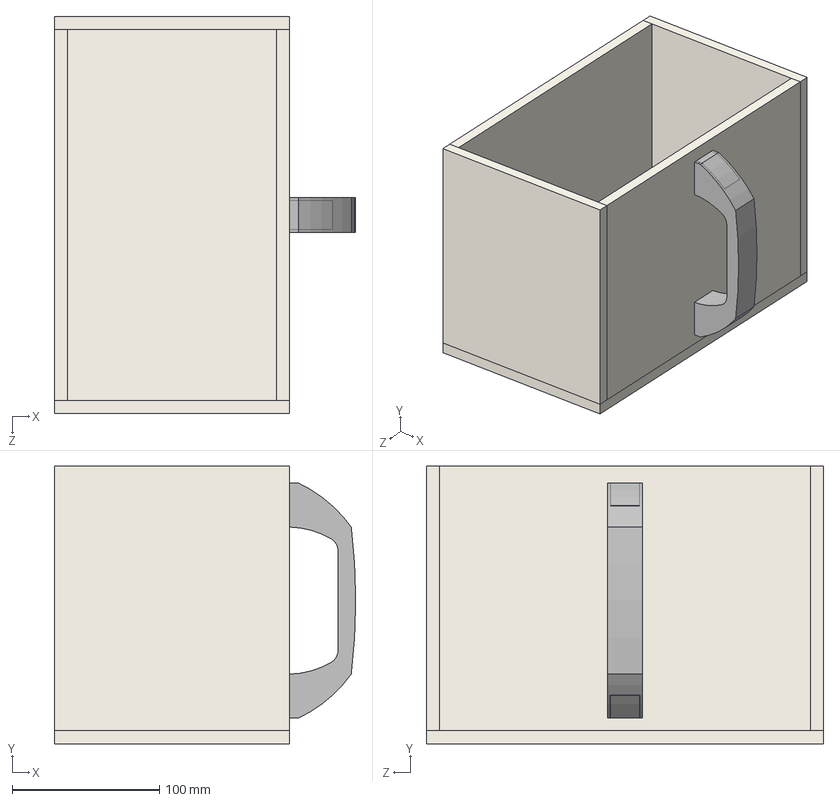
[picture p40: CAD file, 2022-12-10]
Oasis make package 20181230/Mechanical/OA-Y15 Overshoot bin/OA-Y15-A01-00.STEP
205.0 x 189.0 x 270.0 mm
OA-Y15-P01-00
OA-Y15-P02-00
OA-Y15-P05-00
OA-Y15-P04-00 x 2
UPCDG117
DIN 0912 M6x12 x 2
