MSherbinii/Binder-Jet-3D-Printer/Oasis make package 20181230/Mechanical/OA-Y20 Gantry/OA-Y20-P08-00.STEP

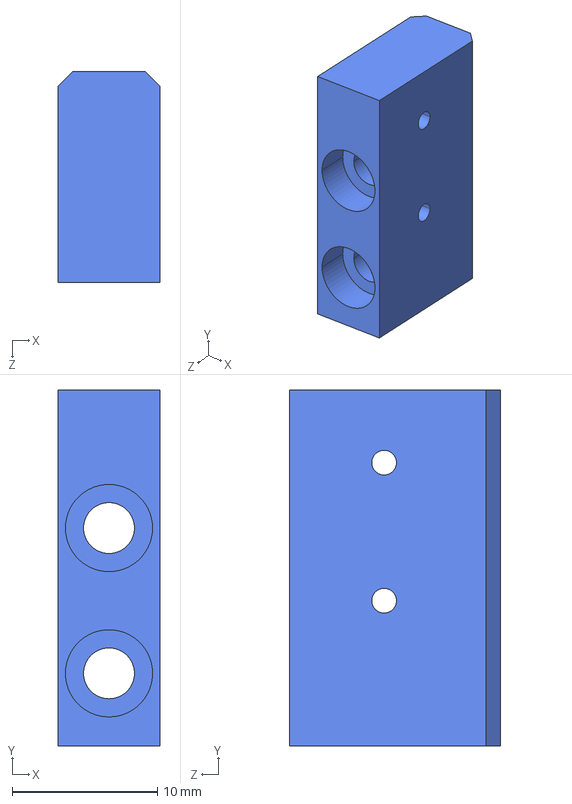
[picture p41: CAD file, 2022-12-10]
Oasis make package 20181230/Mechanical/OA-Y20 Gantry/OA-Y20-P08-00.STEP
7.00 x 24.5 x 14.5 mm
