MSherbinii/Binder-Jet-3D-Printer/Oasis make package 20181230/Mechanical/OA-Y30 Carriage/OA-Y30-P02-01.STEP

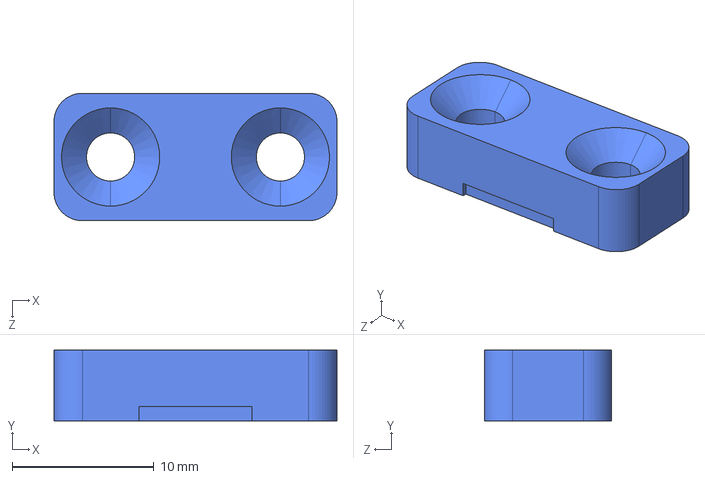
[picture p42: CAD file, 2022-12-10]
Oasis make package 20181230/Mechanical/OA-Y30 Carriage/OA-Y30-P02-01.STEP
20.0 x 5.00 x 9.00 mm
