MSherbinii/Binder-Jet-3D-Printer/Oasis make package 20181230/Mechanical/OA-Y40 Build surface/OA-Y40-A01-01.STEP

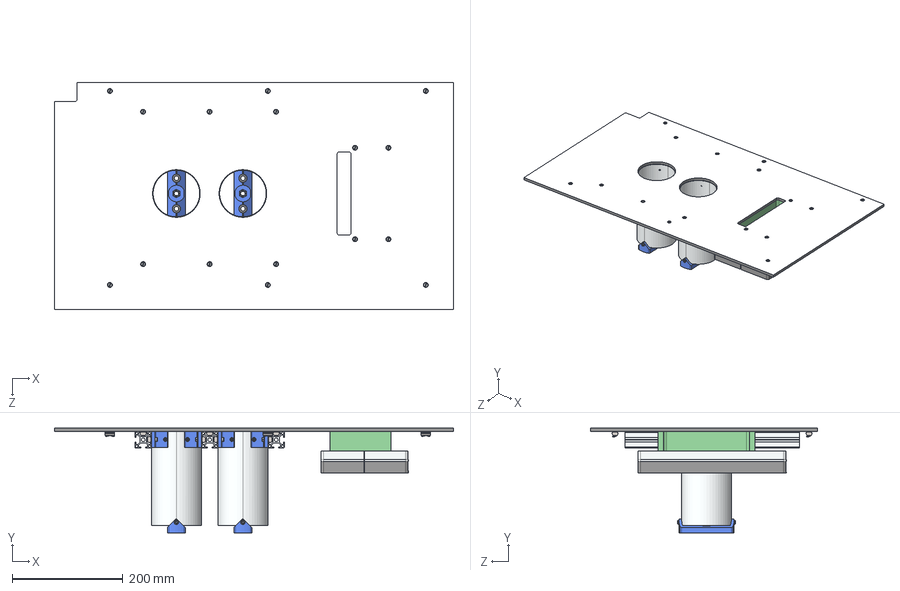
[picture p43: CAD file, 2022-12-10]
Oasis make package 20181230/Mechanical/OA-Y40 Build surface/OA-Y40-A01-01.STEP
720.0 x 189.0 x 409.0 mm
OA-Y40-P06-00
OA-Y40-P07-00
OA-Y40-P08-00
HFS6-3030-315 x 3
DIN 0963 M4x12 x 20
HNTAP6-4 x 20
OA-Y40-P09-00 x 2
OA-Y40-P10-00 x 8
OA-Y40-P11-00 x 2
DIN 0934 M8 x 2
LM8UU x 4
DIN 0985 M4 x 4
DIN 0912 M4x12 x 12
DIN 0125-1A M4 x 8
DIN 0125-1A M3 x 8
DIN 0912 M3x10 x 8
OA-Y40-P12-00
