MSherbinii/Binder-Jet-3D-Printer/Oasis make package 20181230/Mechanical/OA-Y50 Piston/OA-Y50-P02-00.STEP

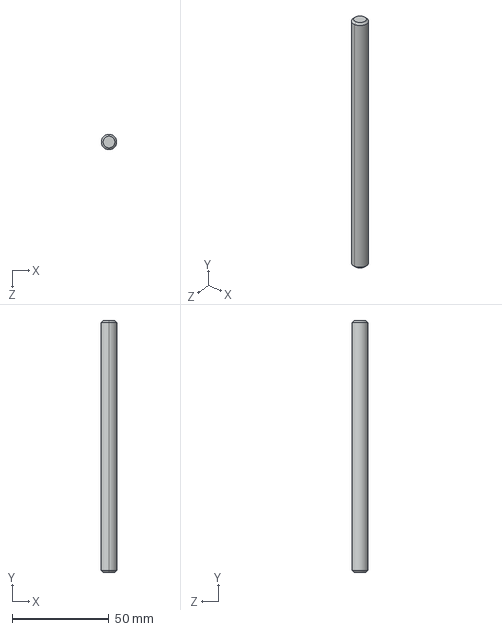
[picture p44: CAD file, 2022-12-10]
Oasis make package 20181230/Mechanical/OA-Y50 Piston/OA-Y50-P02-00.STEP
8.00 x 130.0 x 8.00 mm
