MSherbinii/Binder-Jet-3D-Printer/Oasis lifting spreader A21 20181208/OA-Y21-A01-00 PnG20181208/OA-Y21-P09-00.SLDPRT

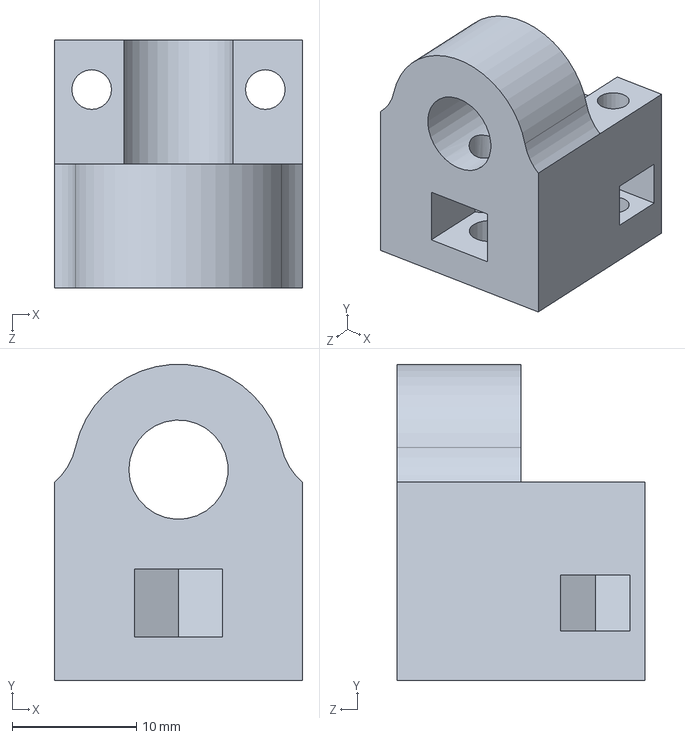
[picture p45: CAD file, 2022-12-10]
Oasis lifting spreader A21 20181208/OA-Y21-A01-00 PnG20181208/OA-Y21-P09-00.SLDPRT
20.0 x 25.5 x 20.0 mm
