MSherbinii/Binder-Jet-3D-Printer/Oasis lifting spreader A21 20181208/STL/OA-Y21-P05-00.STL

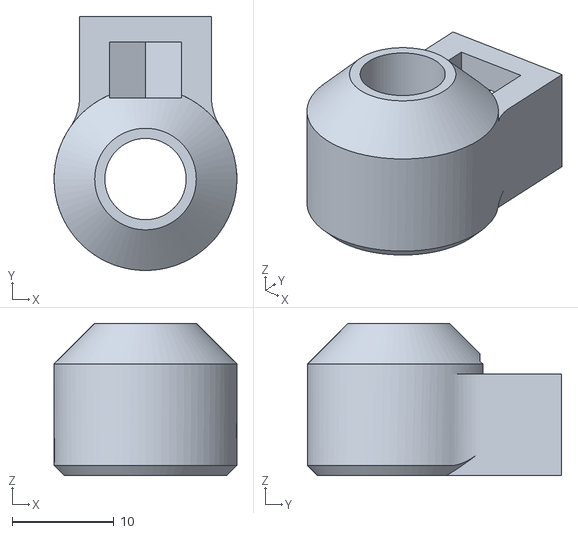
[picture p46: CAD file, 2022-12-10]
Oasis lifting spreader A21 20181208/STL/OA-Y21-P05-00.STL
18.0 x 25.0 x 15.0
