MSherbinii/Binder-Jet-3D-Printer/Oasis make package 20181230/Mechanical/OA-Y10 Baseframe/OA-Y10-A03-00.STEP

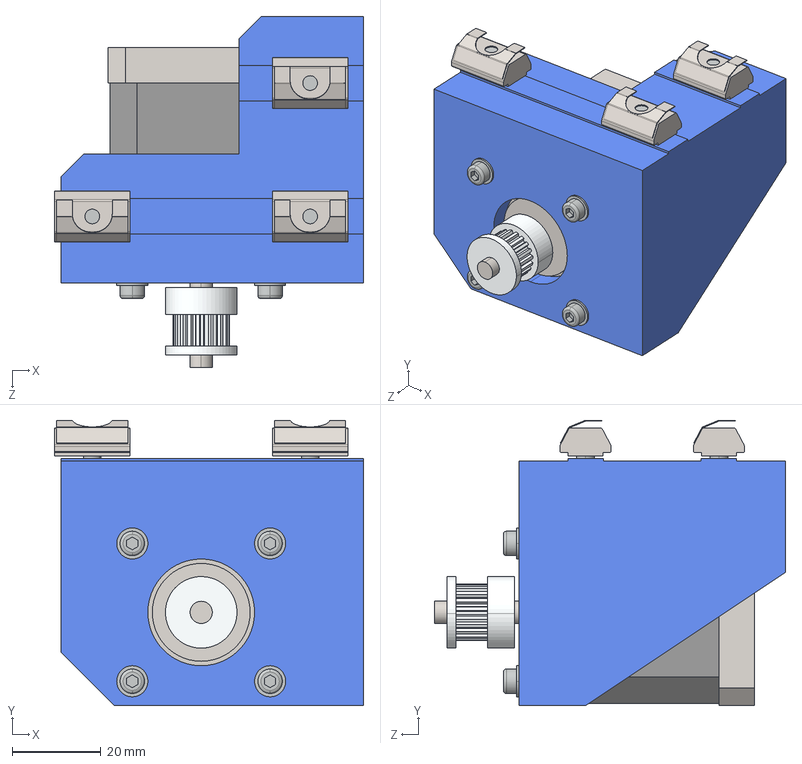
[picture p47: CAD file, 2022-12-10]
Oasis make package 20181230/Mechanical/OA-Y10 Baseframe/OA-Y10-A03-00.STEP
69.5 x 64.2 x 79.0 mm
OA-Y10-P09-00
Stepper NEMA 17 42BYGHW811
GT2 pulley 20T 6mm
DIN 0125-1A M3 x 4
DIN 0912 M3x10 x 4
DIN 0125-1A M4 x 3
DIN 0912 M4x12 x 3
HNTAP6-4 x 3
