MSherbinii/Binder-Jet-3D-Printer/Oasis lifting spreader A21 20181208/STL/OA-Y21-P04-00.STL

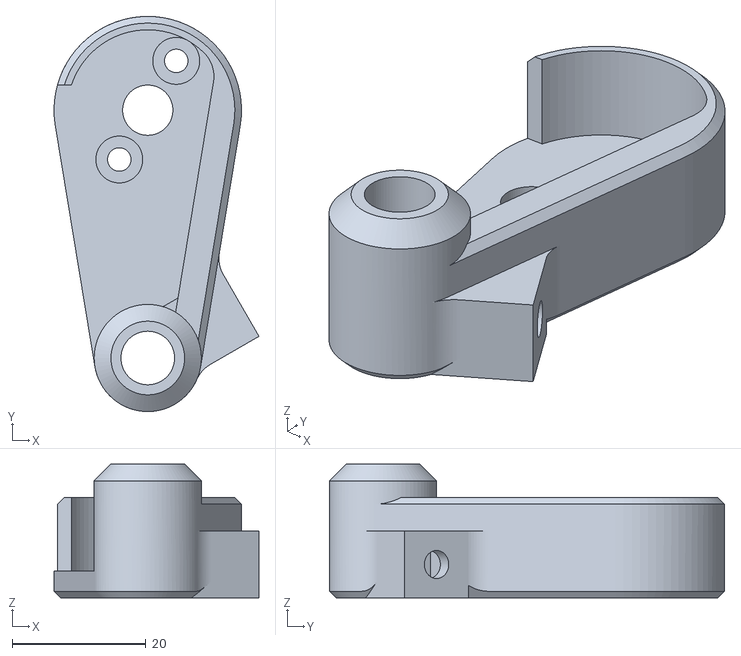
[picture p55: CAD file, 2022-12-10]
Oasis lifting spreader A21 20181208/STL/OA-Y21-P04-00.STL
30.6 x 59.0 x 20.0
