MSherbinii/Binder-Jet-3D-Printer/Oasis lifting spreader A21 20181208/OA-Y21-A01-00 PnG20181208/608 bearing.SLDPRT

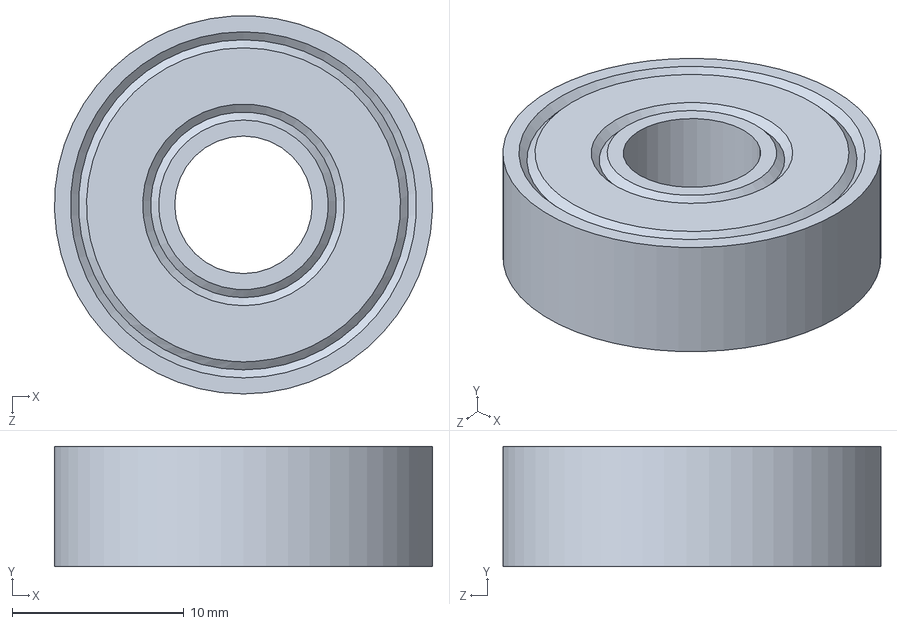
[picture p59: CAD file, 2022-12-10]
Oasis lifting spreader A21 20181208/OA-Y21-A01-00 PnG20181208/608 bearing.SLDPRT
22.0 x 7.00 x 22.0 mm
