MSherbinii/Binder-Jet-3D-Printer/Oasis lifting spreader A21 20181208/OA-Y21-A01-00 PnG20181208/685 bearing.SLDPRT

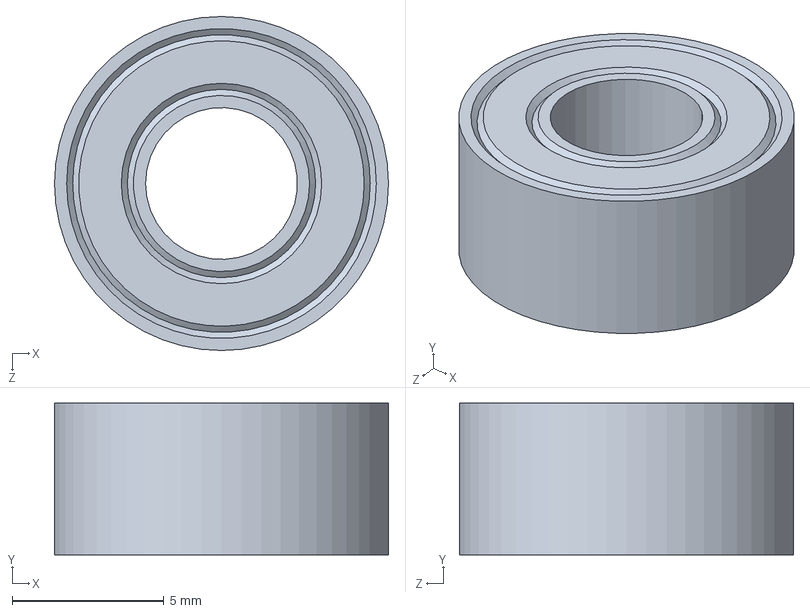
[picture p61: CAD file, 2022-12-10]
Oasis lifting spreader A21 20181208/OA-Y21-A01-00 PnG20181208/685 bearing.SLDPRT
11.0 x 5.00 x 11.0 mm
