MSherbinii/Binder-Jet-3D-Printer/Oasis make package 20181230/Mechanical/OA-Y10 Baseframe/OA-Y10-A04-00.STEP

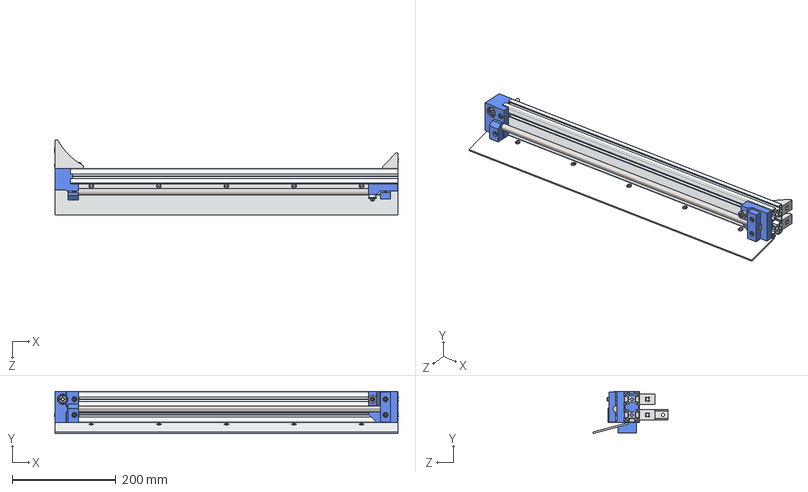
[picture p65: CAD file, 2022-12-10]
Oasis make package 20181230/Mechanical/OA-Y10 Baseframe/OA-Y10-A04-00.STEP
661.8 x 81.0 x 145.0 mm
HNTAP6-6 x 3
HNTAP6-4 x 9
HFS6-3060-630
HBLFSN6 x 2
HBLFSSW6
625 bearing
624 bearing
DIN 9021- M5
DIN 0963 M4x12 x 5
DIN 0912 M6x12 x 3
DIN 0912 M4x20 x 6
DIN 0912 M6x16
DIN 0912 M4x30 x 4
DIN 0125-1A M4 x 11
DIN 0985 M4 x 6
DIN 0985 M6
OA-Y10-P06-00
OA-Y10-P03-00
OA-Y10-P04-00
OA-Y10-P15-00 x 5
OA-Y10-P02-00
OA-Y10-P26-00
OA-Y10-P27-00
