MSherbinii/Binder-Jet-3D-Printer/Oasis lifting spreader A21 20181208/OA-Y21-A01-00 PnG20181208/GT2 pulley 20T 6mm.SLDPRT

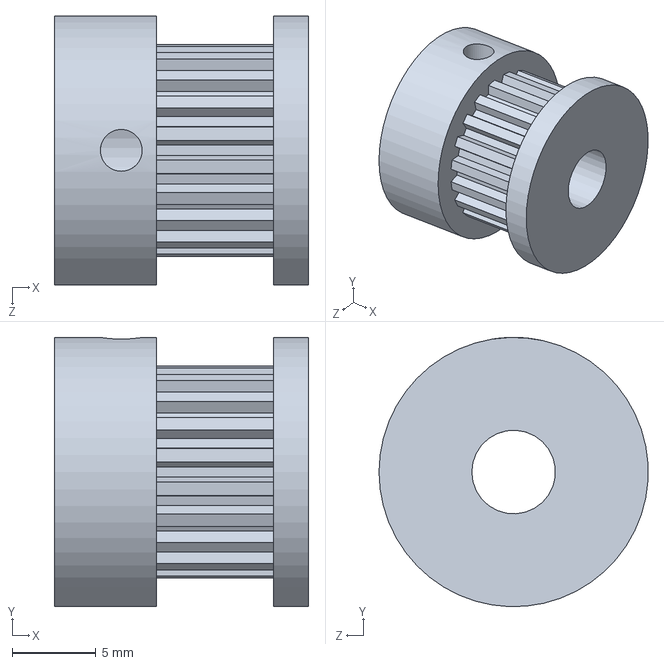
[picture p67: CAD file, 2022-12-10]
Oasis lifting spreader A21 20181208/OA-Y21-A01-00 PnG20181208/GT2 pulley 20T 6mm.SLDPRT
15.2 x 16.1 x 16.1 mm
