MSherbinii/Binder-Jet-3D-Printer/Oasis lifting spreader A21 20181208/OA-Y21-A01-00 PnG20181208/OA-Y21-P02-00.SLDPRT

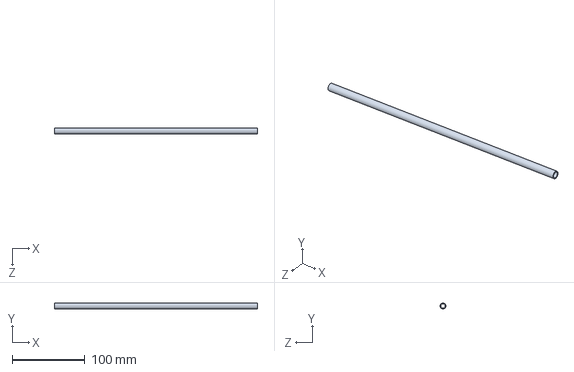
[picture p71: CAD file, 2022-12-10]
Oasis lifting spreader A21 20181208/OA-Y21-A01-00 PnG20181208/OA-Y21-P02-00.SLDPRT
280.0 x 8.00 x 8.00 mm
