MSherbinii/Binder-Jet-3D-Printer/Oasis lifting spreader A21 20181208/OA-Y21-A01-00 PnG20181208/GT2 x 6mm Timing belt L120 Closed.SLDPRT

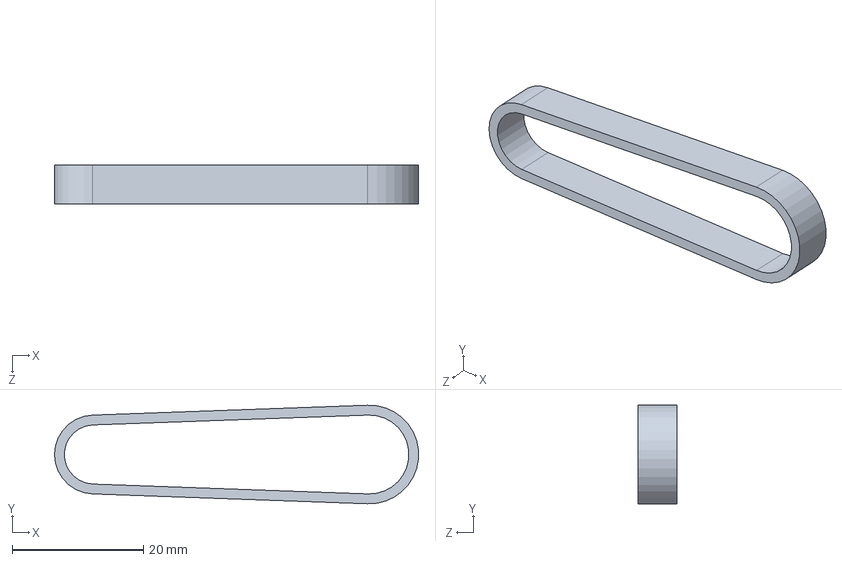
[picture p74: CAD file, 2022-12-10]
Oasis lifting spreader A21 20181208/OA-Y21-A01-00 PnG20181208/GT2 x 6mm Timing belt L120 Closed.SLDPRT
55.4 x 15.0 x 6.00 mm
