MSherbinii/Binder-Jet-3D-Printer/Oasis lifting spreader A21 20181208/OA-Y21-A01-00 PnG20181208/Solenoid nmm.SLDPRT

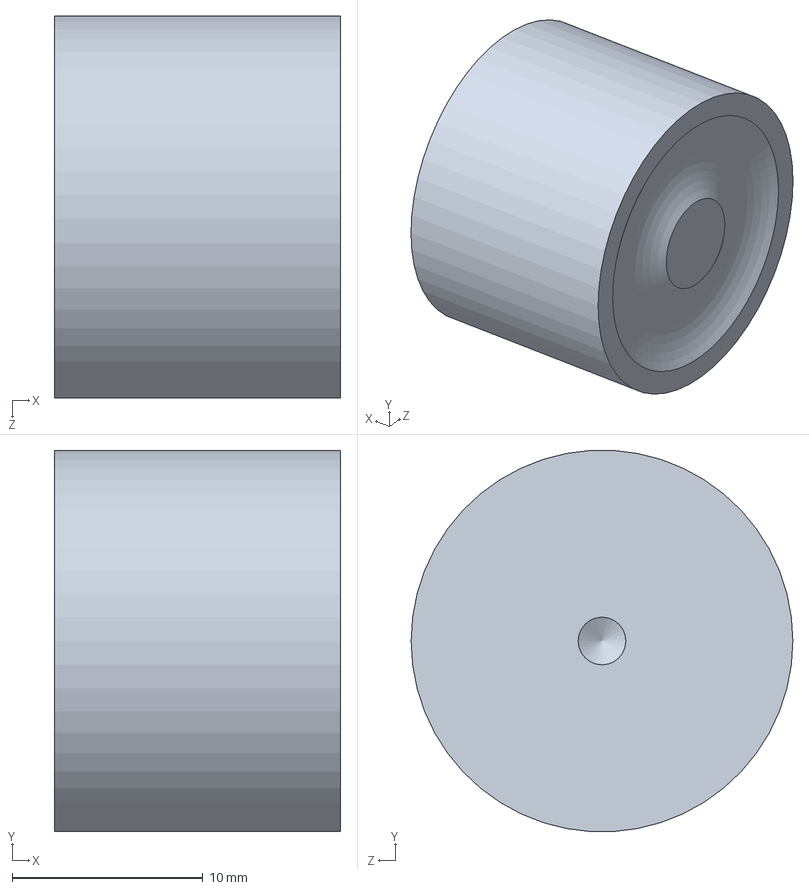
[picture p79: CAD file, 2022-12-10]
Oasis lifting spreader A21 20181208/OA-Y21-A01-00 PnG20181208/Solenoid nmm.SLDPRT
15.0 x 20.0 x 20.0 mm
