MSherbinii/Binder-Jet-3D-Printer/Oasis make package 20181230/Mechanical/OA-Y10 Baseframe/OA-Y10-A02-00.STEP

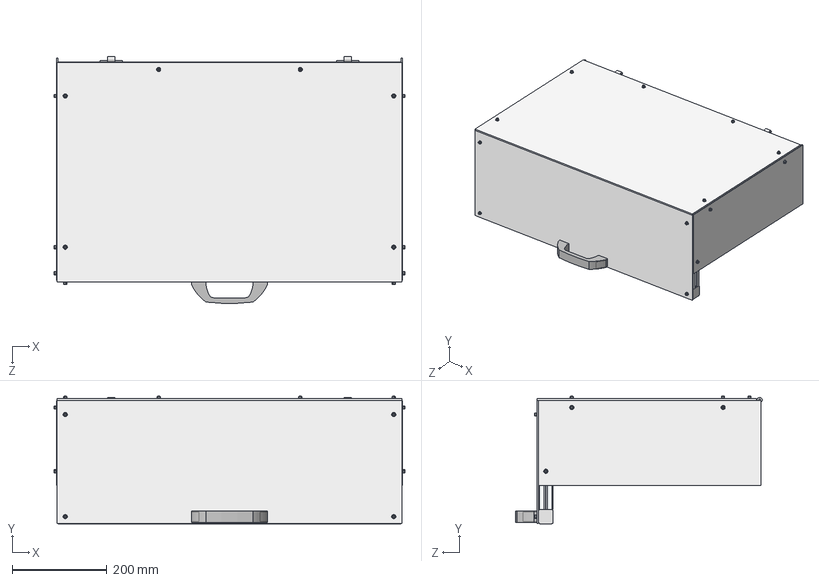
[picture p84: CAD file, 2022-12-10]
Oasis make package 20181230/Mechanical/OA-Y10 Baseframe/OA-Y10-A02-00.STEP
742.6 x 269.8 x 521.7 mm
HFS6-3030-719 x 2
HFS6-3030-402 x 2
HFS6-3030-228 x 2
HFCL6-3030-S x 6
HBLFSSW6 x 2
HBLFSN6 x 4
HHPSN6_1. Hinge part 1 x 2
UPCDG117
HNTAP6-4 x 16
HNTAP6-6 x 22
DIN 0125-1A M4 x 16
DIN 0912 M4x12 x 16
DIN 0912 M6x12 x 16
DIN 0912 M6x16 x 2
DIN 7991 M6x12 x 4
OA-Y10-P13-00
OA-Y10-P11-00
OA-Y10-P12-00 x 2
