MSherbinii/Binder-Jet-3D-Printer/(list of files, cad)

Other CAD files:
Oasis lifting spreader A21 20181208/OA-Y21-A01-00.STEP
Oasis source files 20181014/Electrical/HP45 Standalone V3.00/3D files/HP45 Standalone V3.00 PCBs.STEP
Oasis lifting spreader A21 20181208/STL/OA-Y21-P01-00-M.STL
Oasis lifting spreader A21 20181208/OA-Y21-A01-00 PnG20181208/OA-Y21-P01-00.SLDPRT
Oasis lifting spreader A21 20181208/OA-Y21-A01-00 PnG20181208/OA-Y21-P08-00.SLDPRT
Oasis lifting spreader A21 20181208/STL/OA-Y21-P03-00-M.STL
Oasis lifting spreader A21 20181208/STL/OA-Y21-P01-00.STL
Oasis make package 20181230/Mechanical/OA-Y20 Gantry/OA-Y20-P07-00.STEP
Oasis make package 20181230/Mechanical/OA-Y20 Gantry/OA-Y20-P04-00.STEP
Oasis lifting spreader A21 20181208/OA-Y21-A01-00 PnG20181208/SSFRHQ20-200-F20-P5-T20-Q5.SLDPRT
Oasis lifting spreader A21 20181208/OA-Y21-A01-00 PnG20181208/OA-Y21-P03-00.SLDPRT
Oasis lifting spreader A21 20181208/OA-Y21-A01-00 PnG20181208/OA-Y21-P06-00.SLDPRT
Oasis lifting spreader A21 20181208/OA-Y21-A01-00 PnG20181208/OA-Y21-P03-00-M.SLDPRT
Oasis lifting spreader A21 20181208/OA-Y21-A01-00 PnG20181208/OA-Y21-P04-00.SLDPRT
Oasis lifting spreader A21 20181208/OA-Y21-A01-00 PnG20181208/OA-Y21-P05-00.SLDPRT
Oasis lifting spreader A21 20181208/OA-Y21-A01-00 PnG20181208/DIN 0125-1A M4.SLDPRT
Oasis lifting spreader A21 20181208/OA-Y21-A01-00 PnG20181208/DIN 0912 M3x20.SLDPRT
Oasis lifting spreader A21 20181208/OA-Y21-A01-00 PnG20181208/DIN 0912 M3x6.SLDPRT
Oasis lifting spreader A21 20181208/OA-Y21-A01-00 PnG20181208/DIN 0912 M4x12.SLDPRT
Oasis lifting spreader A21 20181208/OA-Y21-A01-00 PnG20181208/DIN 0912 M4x20.SLDPRT
Oasis lifting spreader A21 20181208/OA-Y21-A01-00 PnG20181208/DIN 0985 M3.SLDPRT
Oasis lifting spreader A21 20181208/OA-Y21-A01-00 PnG20181208/DIN 0985 M4.SLDPRT
Oasis lifting spreader A21 20181208/OA-Y21-A01-00 PnG20181208/DIN 7991 M10x20.SLDPRT
Oasis make package 20181230/Mechanical/OA-Y10 Baseframe/OA-Y10-P03-00.STL
Oasis make package 20181230/Mechanical/OA-Y10 Baseframe/OA-Y10-P05-00.STL
Oasis make package 20181230/Mechanical/OA-Y10 Baseframe/OA-Y10-P06-00.STL
Oasis make package 20181230/Mechanical/OA-Y10 Baseframe/OA-Y10-P07-00.STL
Oasis make package 20181230/Mechanical/OA-Y10 Baseframe/OA-Y10-P09-00.STL
Oasis make package 20181230/Mechanical/OA-Y10 Baseframe/OA-Y10-P15-00.STL
Oasis make package 20181230/Mechanical/OA-Y10 Baseframe/OA-Y10-P17-00.STL
Oasis make package 20181230/Mechanical/OA-Y10 Baseframe/OA-Y10-P18-01.STL
Oasis make package 20181230/Mechanical/OA-Y10 Baseframe/OA-Y10-P21-00.STL
Oasis make package 20181230/Mechanical/OA-Y10 Baseframe/OA-Y10-P22-00.STL
Oasis make package 20181230/Mechanical/OA-Y10 Baseframe/OA-Y10-P25-00.STL
Oasis make package 20181230/Mechanical/OA-Y10 Baseframe/OA-Y10-P26-00.STL
Oasis make package 20181230/Mechanical/OA-Y10 Baseframe/OA-Y10-P27-00.STL
Oasis make package 20181230/Mechanical/OA-Y20 Gantry/OA-Y20-P01-01.STL
Oasis make package 20181230/Mechanical/OA-Y20 Gantry/OA-Y20-P03-01.STL
Oasis make package 20181230/Mechanical/OA-Y20 Gantry/OA-Y20-P04-00-M.STL
Oasis make package 20181230/Mechanical/OA-Y20 Gantry/OA-Y20-P04-00.STL
Oasis make package 20181230/Mechanical/OA-Y20 Gantry/OA-Y20-P05-00.STL
Oasis make package 20181230/Mechanical/OA-Y20 Gantry/OA-Y20-P06-01.STL
Oasis make package 20181230/Mechanical/OA-Y20 Gantry/OA-Y20-P07-00.STL
Oasis make package 20181230/Mechanical/OA-Y20 Gantry/OA-Y20-P08-00.STL
Oasis make package 20181230/Mechanical/OA-Y20 Gantry/OA-Y20-P10-00.STL
Oasis make package 20181230/Mechanical/OA-Y20 Gantry/OA-Y20-P11-00.STL
Oasis make package 20181230/Mechanical/OA-Y20 Gantry/OA-Y20-P12-00.STL
Oasis make package 20181230/Mechanical/OA-Y30 Carriage/OA-Y30-P01-02.STL
Oasis make package 20181230/Mechanical/OA-Y30 Carriage/OA-Y30-P02-01.STL
Oasis make package 20181230/Mechanical/OA-Y30 Carriage/OA-Y30-P03-03.STL
Oasis make package 20181230/Mechanical/OA-Y30 Carriage/OA-Y30-P04-00.STL
Oasis make package 20181230/Mechanical/OA-Y30 Carriage/OA-Y30-P05-01.STL
Oasis make package 20181230/Mechanical/OA-Y30 Carriage/OA-Y30-P06-00.STL
Oasis make package 20181230/Mechanical/OA-Y30 Carriage/OA-Y30-P07-00.STL
Oasis make package 20181230/Mechanical/OA-Y30 Carriage/OA-Y30-P08-00.STL
Oasis make package 20181230/Mechanical/OA-Y40 Build surface/OA-Y40-P07-00.STL
Oasis make package 20181230/Mechanical/OA-Y40 Build surface/OA-Y40-P10-00.STL
Oasis make package 20181230/Mechanical/OA-Y40 Build surface/OA-Y40-P11-00.STL
Oasis make package 20181230/Mechanical/OA-Y50 Piston/OA-Y50-P07-00.STL
Oasis make package 20181230/Mechanical/OA-Y50 Piston/OA-Y50-P08-00.STL
Oasis make package 20181230/Mechanical/OA-Y60 Additional tools/OA-Y60-P01-00.STL
