MSherbinii/Binder-Jet-3D-Printer/Oasis make package 20181230/Firmware/GRBL/Readme.txt

This GRBL package is a GRBL 0.9 library that supports 4 axes, configured for Oasis.

The original can be found here: https://github.com/mlambm/grbl

To flash it to the Arduino, follow the instruction here: https://github.com/grbl/grbl/wiki/Compiling-Grbl
