MSherbinii/Binder-Jet-3D-Printer/Oasis make package 20181230/Firmware/GRBL/Default settings.txt

These are the default settings for GRBL that you get when you querry '$$' over serial
You can set any of these values by typing over serial for example: '$27=5'
While some values are not critical, others are. Tyr to match as many as possible.
Standard serial speed is 115200.

$0=10 (step pulse, usec)
$1=255 (step idle delay, msec)
$2=0 (step port invert mask:00000000)
$3=2 (dir port invert mask:00000010)
$4=0 (step enable invert, bool)
$5=0 (limit pins invert, bool)
$6=0 (probe pin invert, bool)
$10=2 (status report mask:00000010)
$11=0.010 (junction deviation, mm)
$12=0.002 (arc tolerance, mm)
$13=0 (report inches, bool)
$20=0 (soft limits, bool)
$21=0 (hard limits, bool)
$22=1 (homing cycle, bool)
$23=1 (homing dir invert mask:00000001)
$24=300.000 (homing feed, mm/min)
$25=3000.000 (homing seek, mm/min)
$26=250 (homing debounce, msec)
$27=5.000 (homing pull-off, mm)
$100=80.000 (x, step/mm)
$101=80.000 (y, step/mm)
$102=2560.000 (z, step/mm)
$103=2560.000 (A, step/mm)
$110=18000.000 (x max rate, mm/min)
$111=18000.000 (y max rate, mm/min)
$112=200.000 (z max rate, mm/min)
$113=200.000 (A max rate, mm/min)
$120=500.000 (x accel, mm/sec^2)
$121=500.000 (y accel, mm/sec^2)
$122=100.000 (z accel, mm/sec^2)
$123=100.000 (A accel, mm/sec^2)
$130=500.000 (x max travel, mm)
$131=350.000 (y max travel, mm)
$132=100.000 (z max travel, mm)
$133=100.000 (A max travel, mm)
