MSherbinii/Binder-Jet-3D-Printer/Oasis make package 20181230/Mechanical/OA-Y40 Build surface/OA-Y40-A02-00.PDF

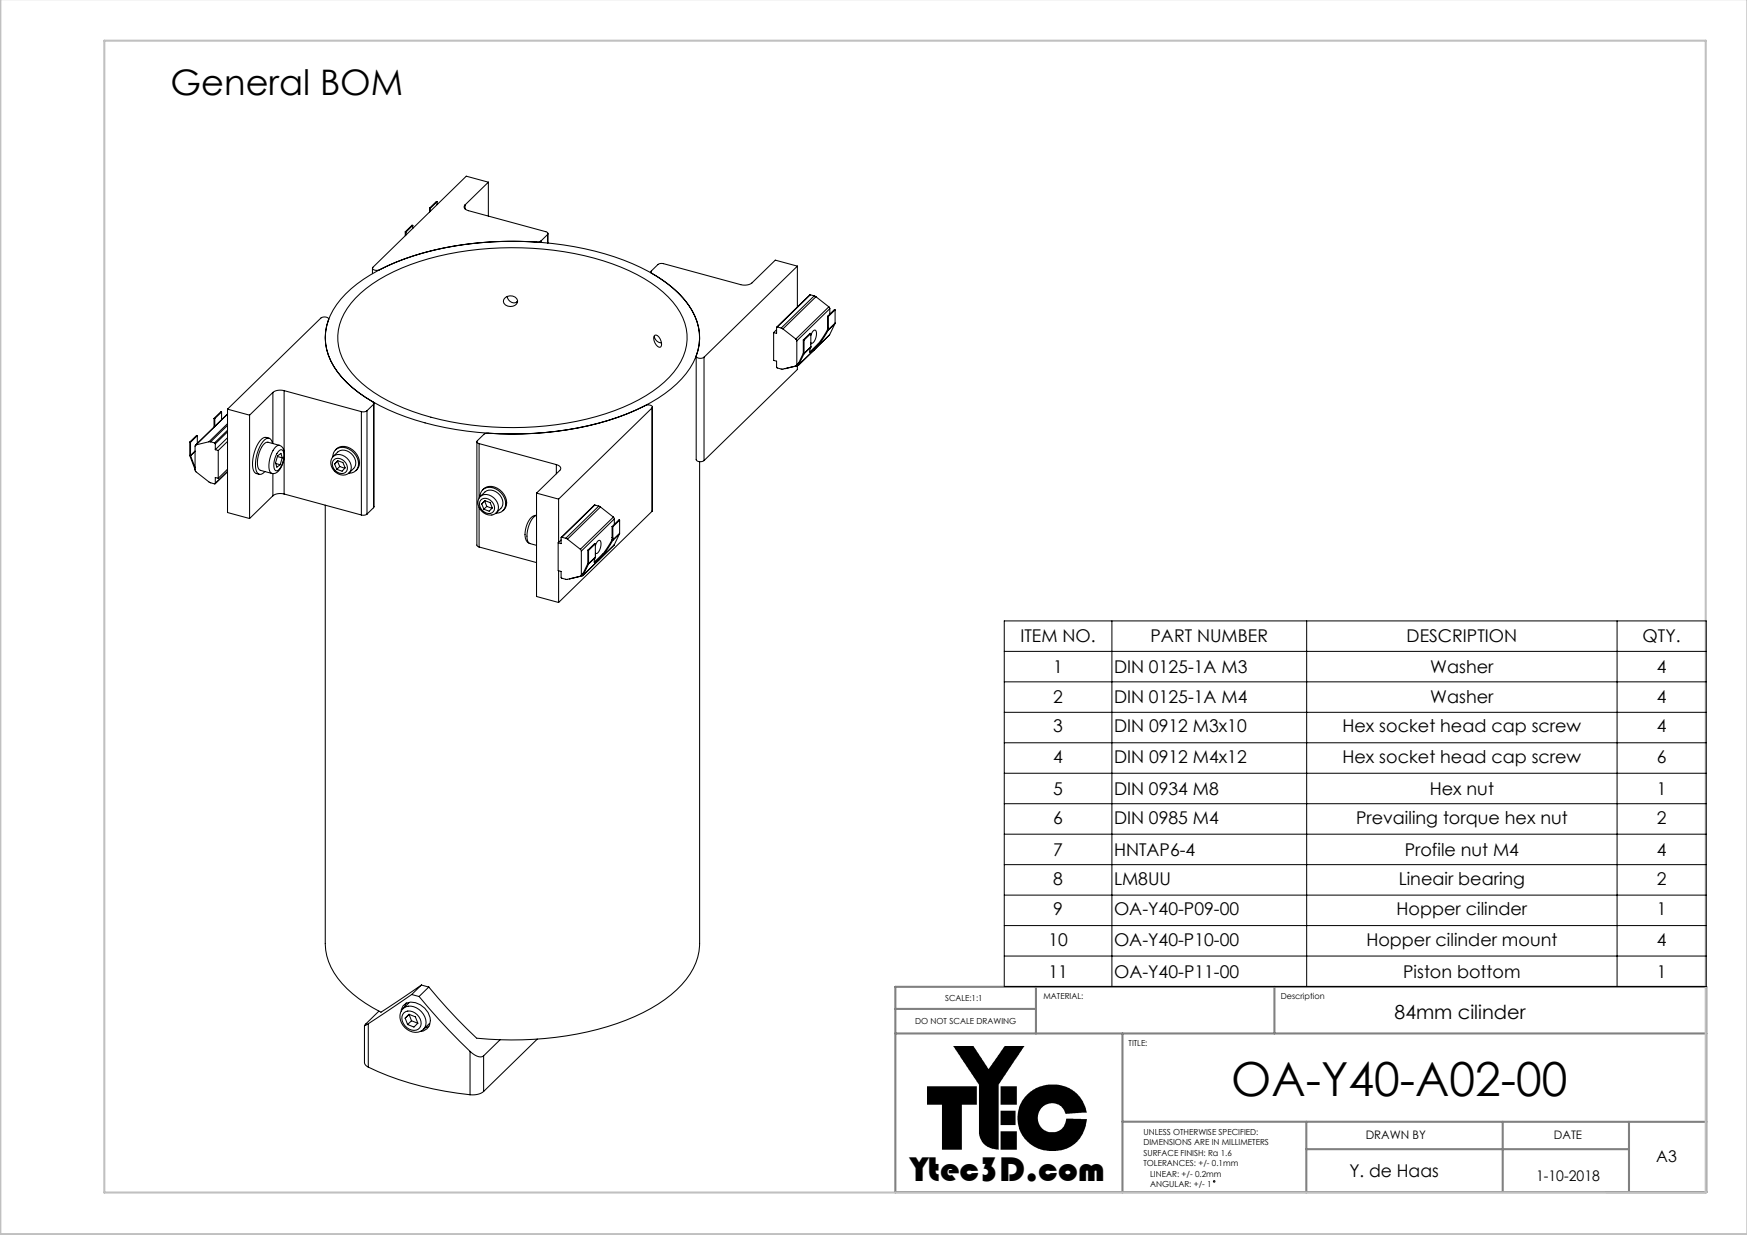
[picture p87: page 1]
General BOM

ITEM NO. | PART NUMBER | DESCRIPTION | QTY.
1 | DIN 0125-1A M3 | Washer | 4
2 | DIN 0125-1A M4 | Washer | 4
3 | DIN 0912 M3x10 | Hex socket head cap screw | 4
4 | DIN 0912 M4x12 | Hex socket head cap screw | 6
5 | DIN 0934 M8 | Hex nut | 1
6 | DIN 0985 M4 | Prevailing torque hex nut | 2
7 | HNTAP6-4 | Profile nut M4 | 4
8 | LM8UU | Lineair bearing | 2
9 | OA-Y40-P09-00 | Hopper cilinder | 1
10 | OA-Y40-P10-00 | Hopper cilinder mount | 4
11 | OA-Y40-P11-00 | Piston bottom | 1

SCALE:1:1 | MATERIAL: | Description 84mm cilinder
Ytec3D.com | TITLE: OA-Y40-A02-00

DO NOT SCALE DRAWING

DIMENSIONS ARE IN MILLIMETERS SURFACE FINISH: Ra 1.6 TOLERANCES: +/- 0.1mm LINEAR: +/- 0.2mm ANGULAR: +/- 1 | DRAWN BY UNLESS OTHERWISE SPECIFIED: | DATE | A3

Y. de Haas | 1-10-2018

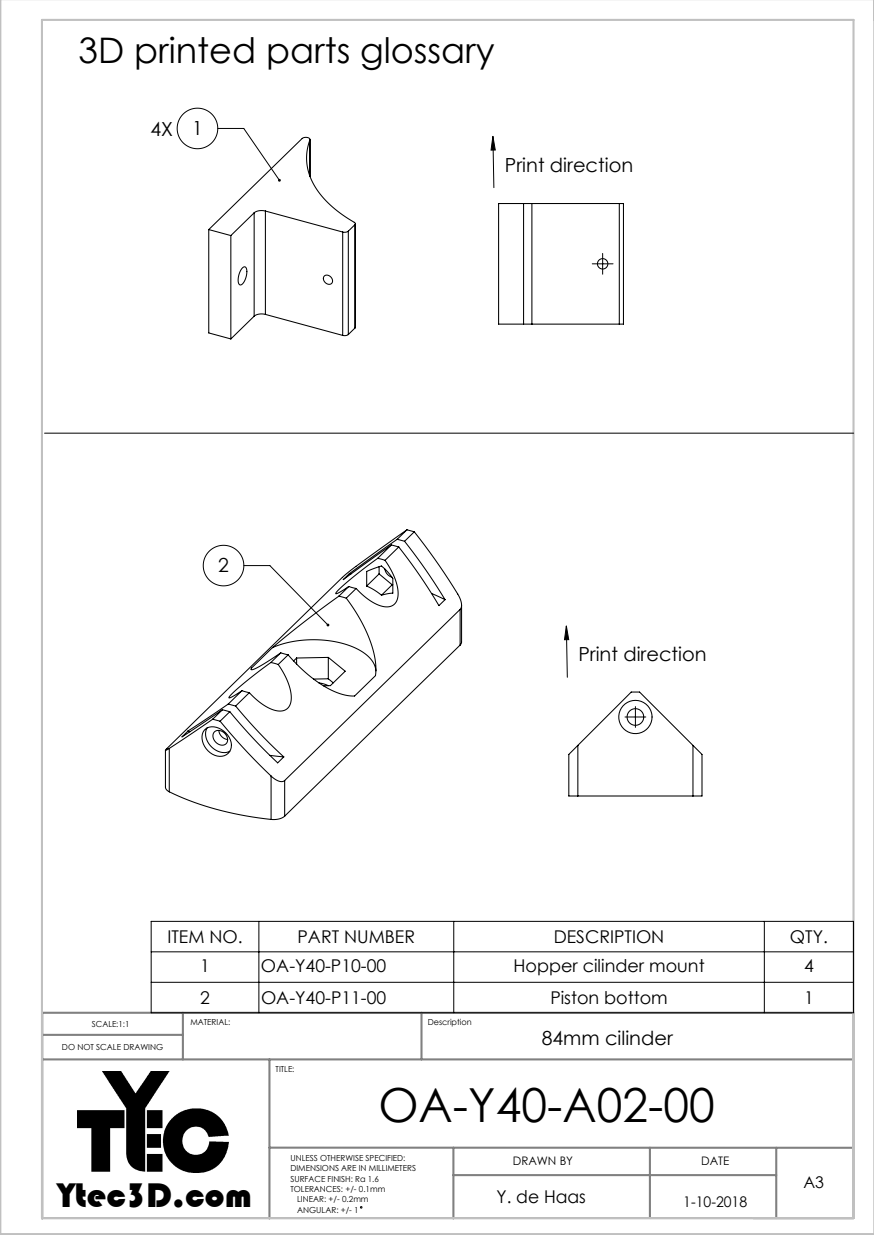
[picture p88: page 2]
Print direction

3D printed parts glossary

ITEM NO. | PART NUMBER | DESCRIPTION | QTY.
1 | OA-Y40-P10-00 | Hopper cilinder mount | 4
2 | OA-Y40-P11-00 | Piston bottom | 1

SCALE:1:1 | MATERIAL: | Description 84mm cilinder

DO NOT SCALE DRAWING

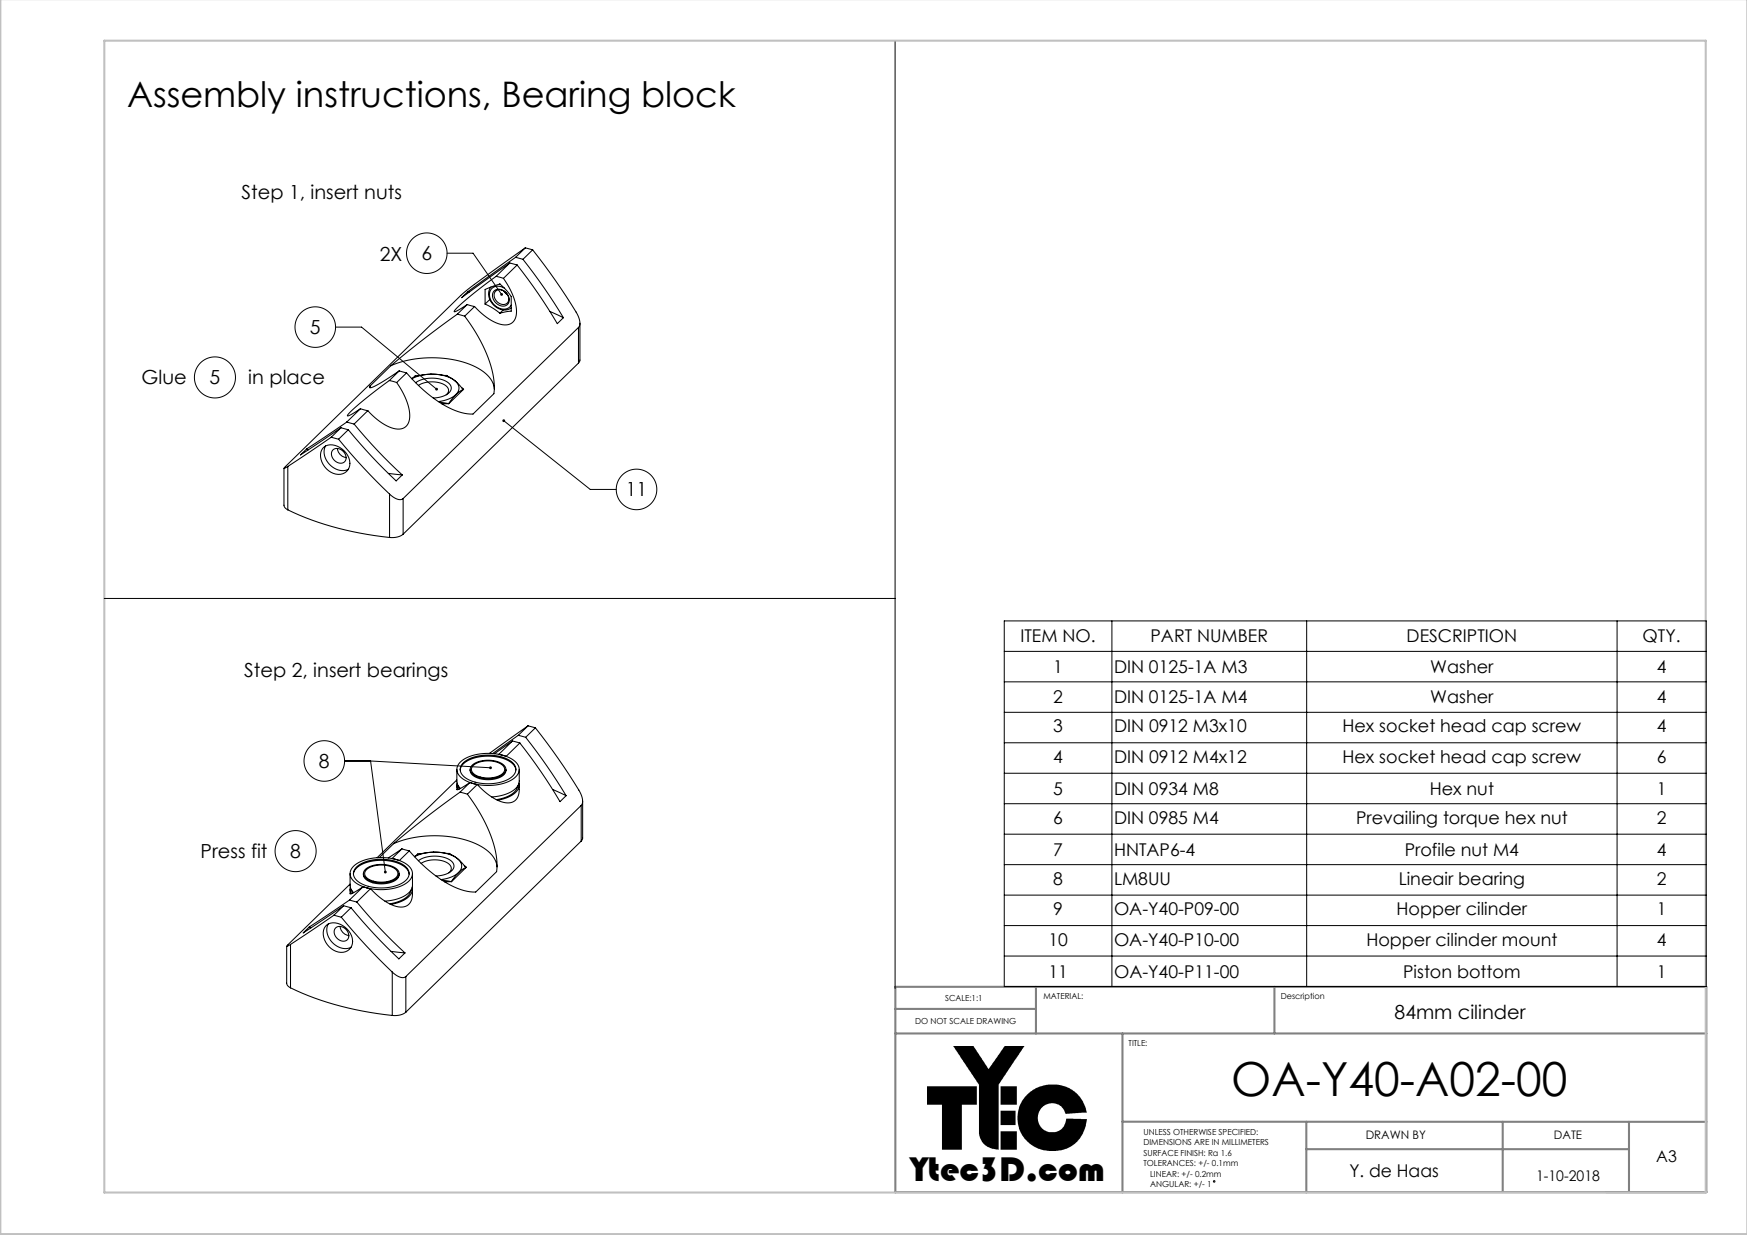
[picture p89: page 3]
Press fit 8

Assembly instructions, Bearing block

Step 1, insert nuts

Glue 5 in place

ITEM NO. | PART NUMBER | DESCRIPTION | QTY.
1 | DIN 0125-1A M3 | Washer | 4
2 | DIN 0125-1A M4 | Washer | 4
3 | DIN 0912 M3x10 | Hex socket head cap screw | 4
4 | DIN 0912 M4x12 | Hex socket head cap screw | 6
5 | DIN 0934 M8 | Hex nut | 1
6 | DIN 0985 M4 | Prevailing torque hex nut | 2
7 | HNTAP6-4 | Profile nut M4 | 4
8 | LM8UU | Lineair bearing | 2
9 | OA-Y40-P09-00 | Hopper cilinder | 1
10 | OA-Y40-P10-00 | Hopper cilinder mount | 4
11 | OA-Y40-P11-00 | Piston bottom | 1

Step 2, insert bearings

SCALE:1:1 | MATERIAL: | Description 84mm cilinder

DO NOT SCALE DRAWING

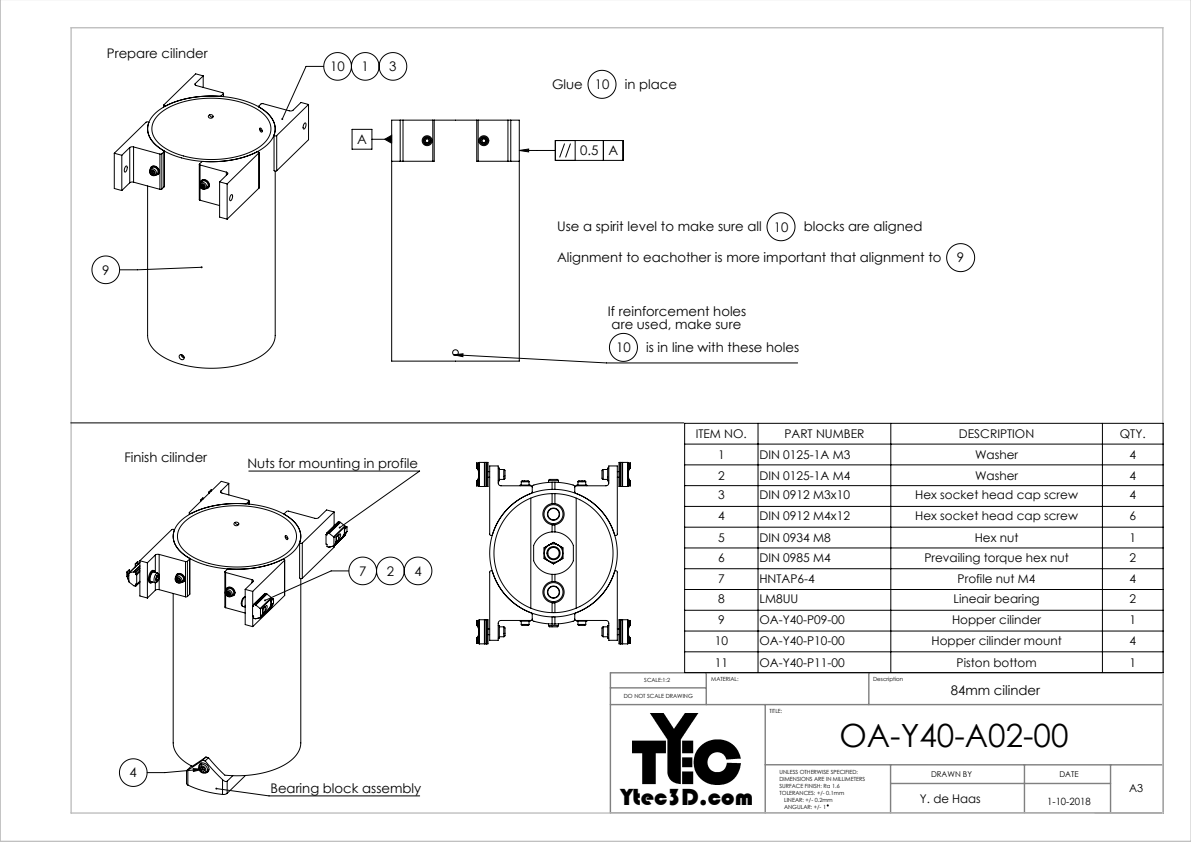
[picture p90: page 4]
Prepare cilinder; Finish cilinder

Glue 10 in place

Use a spirit level to make sure all 10 blocks are aligned
Alignment to eachother is more important that alignment to 9

If reinforcement holes
are used, make sure
10 is in line with these holes

ITEM NO. | PART NUMBER | DESCRIPTION | QTY.
1 | DIN 0125-1A M3 | Washer | 4
2 | DIN 0125-1A M4 | Washer | 4
3 | DIN 0912 M3x10 | Hex socket head cap screw | 4
4 | DIN 0912 M4x12 | Hex socket head cap screw | 6
5 | DIN 0934 M8 | Hex nut | 1
6 | DIN 0985 M4 | Prevailing torque hex nut | 2
7 | HNTAP6-4 | Profile nut M4 | 4
8 | LM8UU | Lineair bearing | 2
9 | OA-Y40-P09-00 | Hopper cilinder | 1
10 | OA-Y40-P10-00 | Hopper cilinder mount | 4
11 | OA-Y40-P11-00 | Piston bottom | 1

Nuts for mounting in profile

SCALE:1:2 | MATERIAL: | Description 84mm cilinder

DO NOT SCALE DRAWING

Bearing block assembly
