MSherbinii/Binder-Jet-3D-Printer/Oasis source files 20181014/Electrical/HP45 Standalone V3.00/Controller board V3.01/HP45 Standalone Revisions 00-01.txt

Last updated: 20180429
-Pin A11 and 23 swapped because A11 does not do digital (Hena and TSR)
-Pin names added to header
