MSherbinii/Binder-Jet-3D-Printer/Oasis make package 20181230/Mechanical/OA-Y40 Build surface/OA-Y40-A01-01.PDF

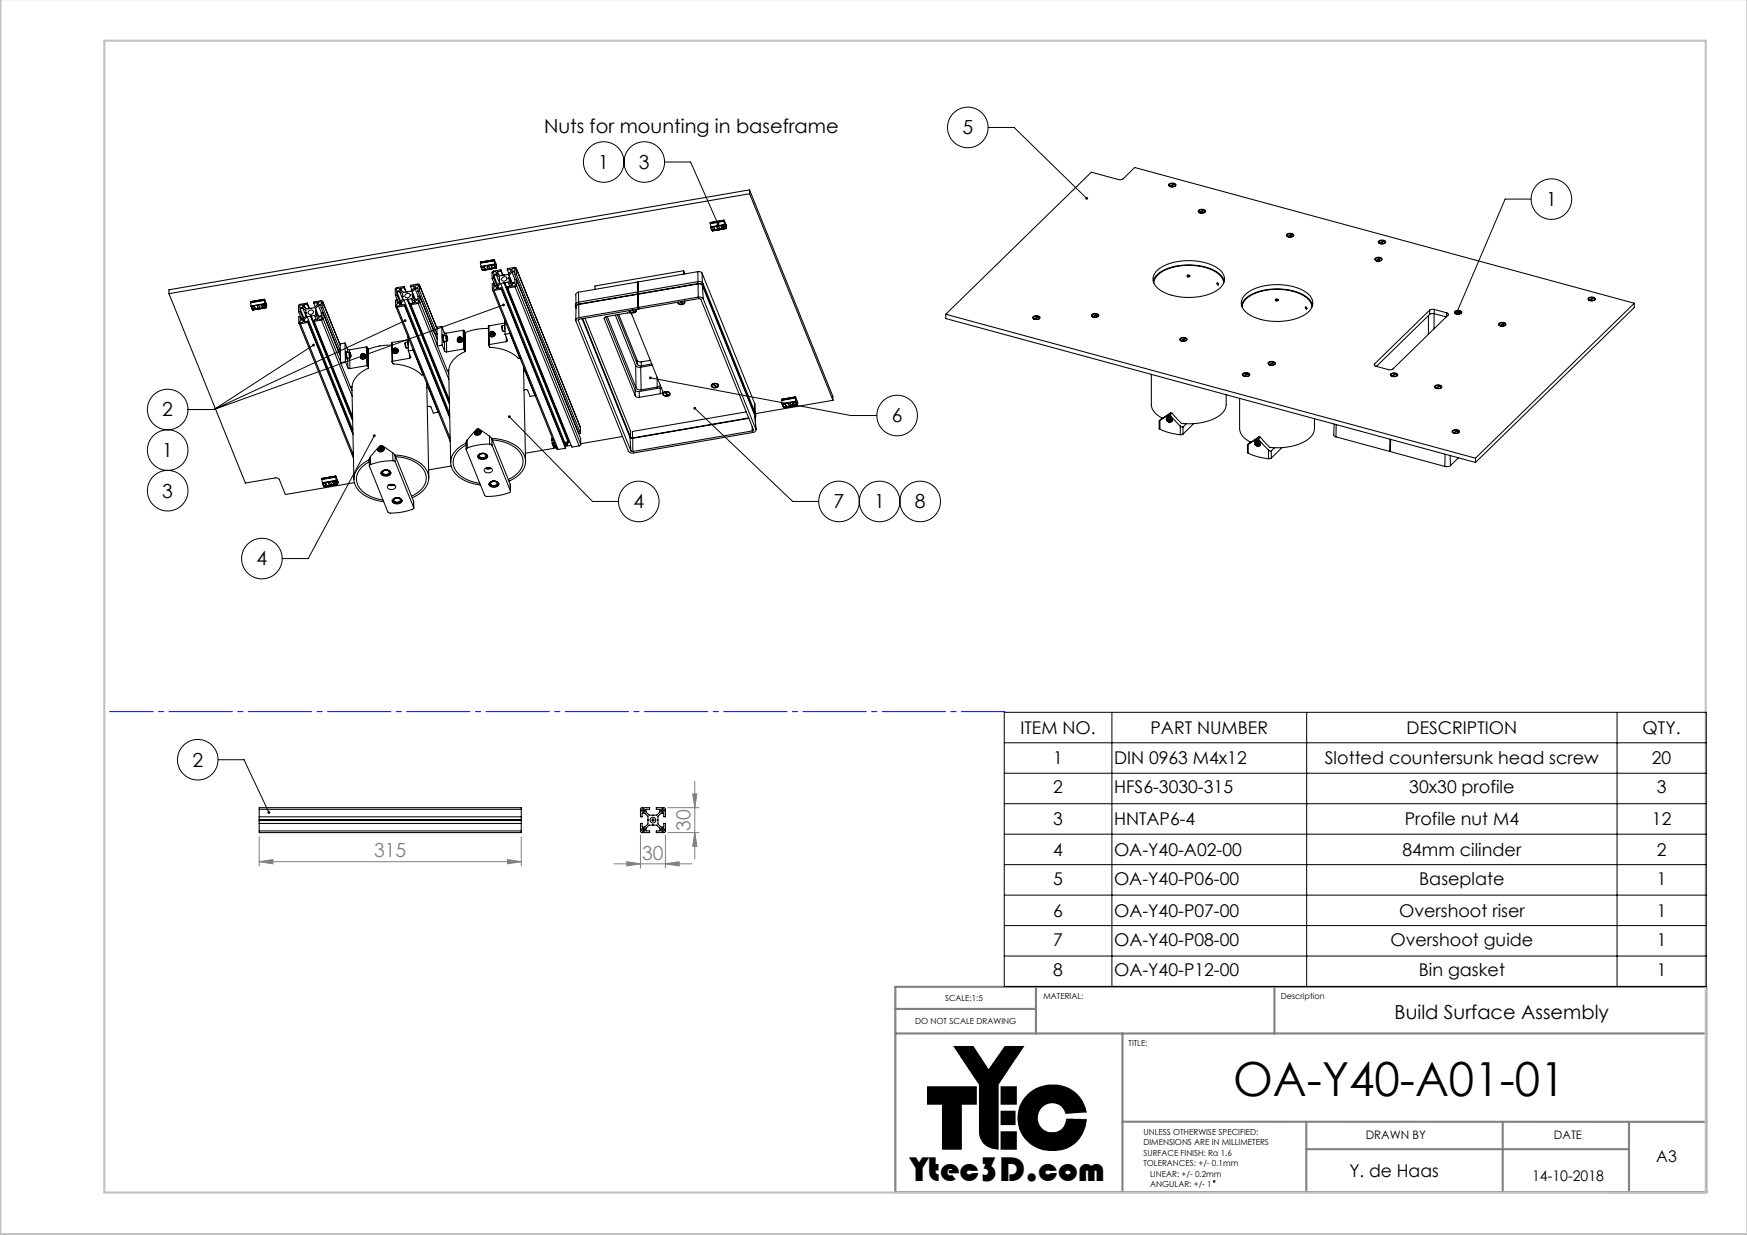
[picture p98: page 1]
84mm cilinder

Nuts for mounting in baseframe

ITEM NO. | PART NUMBER | DESCRIPTION | QTY.
1 | DIN 0963 M4x12 | Slotted countersunk head screw | 20
2 | HFS6-3030-315 | 30x30 profile | 3
3 | HNTAP6-4 | Profile nut M4 | 12

5 | OA-Y40-P06-00 | Baseplate | 1
6 | OA-Y40-P07-00 | Overshoot riser | 1
7 | OA-Y40-P08-00 | Overshoot guide | 1
8 | OA-Y40-P12-00 | Bin gasket | 1

SCALE:1:5 | MATERIAL: | Description Build Surface Assembly
Ytec3D.com | TITLE: OA-Y40-A01-01

DO NOT SCALE DRAWING

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

Y. de Haas | 14-10-2018
