MSherbinii/Binder-Jet-3D-Printer/Oasis make package 20181230/Mechanical/OA-Y40 Build surface/OA-Y40-P08-00.PDF

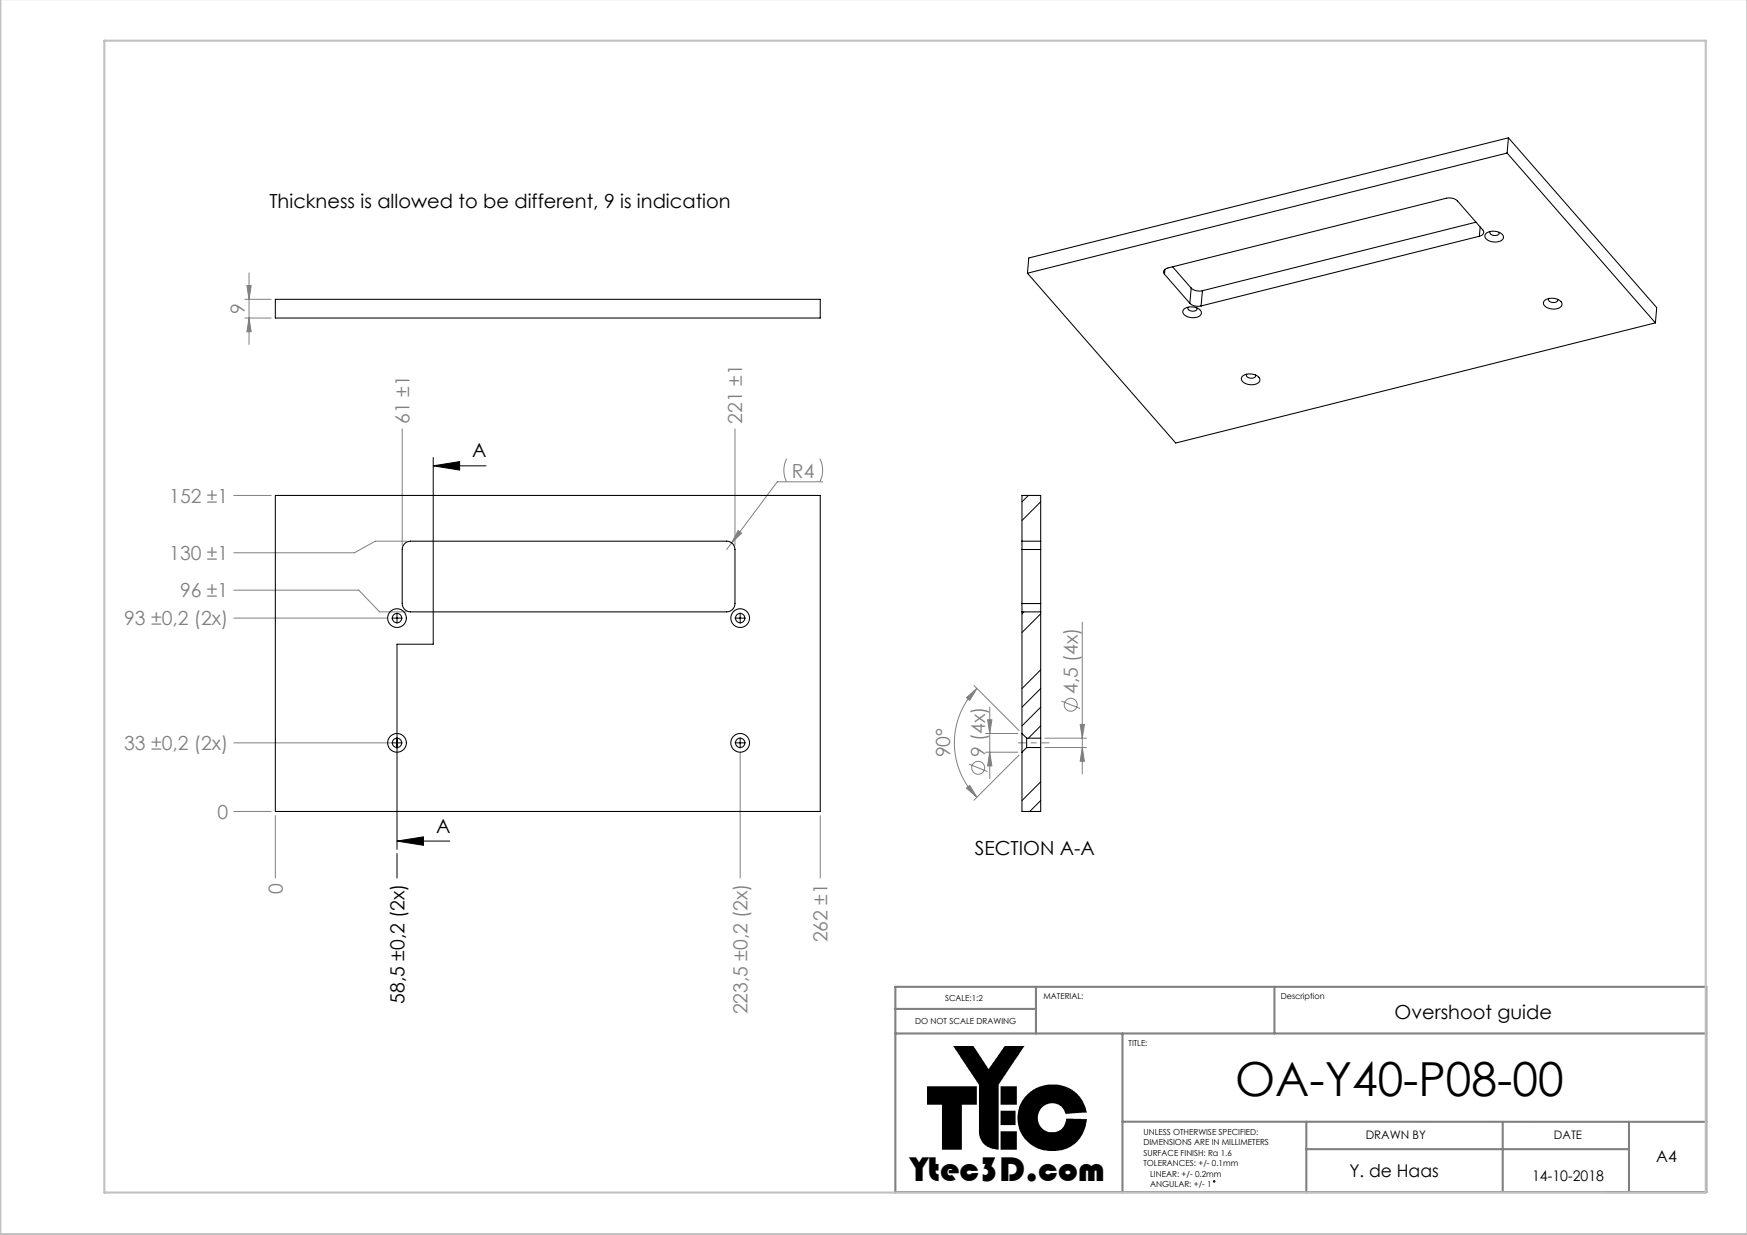
[picture p99: page 1]
Overshoot guide; SECTION A-A

Thickness is allowed to be different, 9 is indication

DO NOT SCALE DRAWING

Ytec3D.com | TITLE: OA-Y40-P08-00

DIMENSIONS ARE IN MILLIMETERS SURFACE FINISH: Ra 1.6 TOLERANCES: +/- 0.1mm LINEAR: +/- 0.2mm ANGULAR: +/- 1 | DRAWN BY UNLESS OTHERWISE SPECIFIED: | DATE | A4

Y. de Haas | 14-10-2018
