MSherbinii/Binder-Jet-3D-Printer/Oasis make package 20181230/Mechanical/OA-Y40 Build surface/OA-Y40-P09-00.PDF

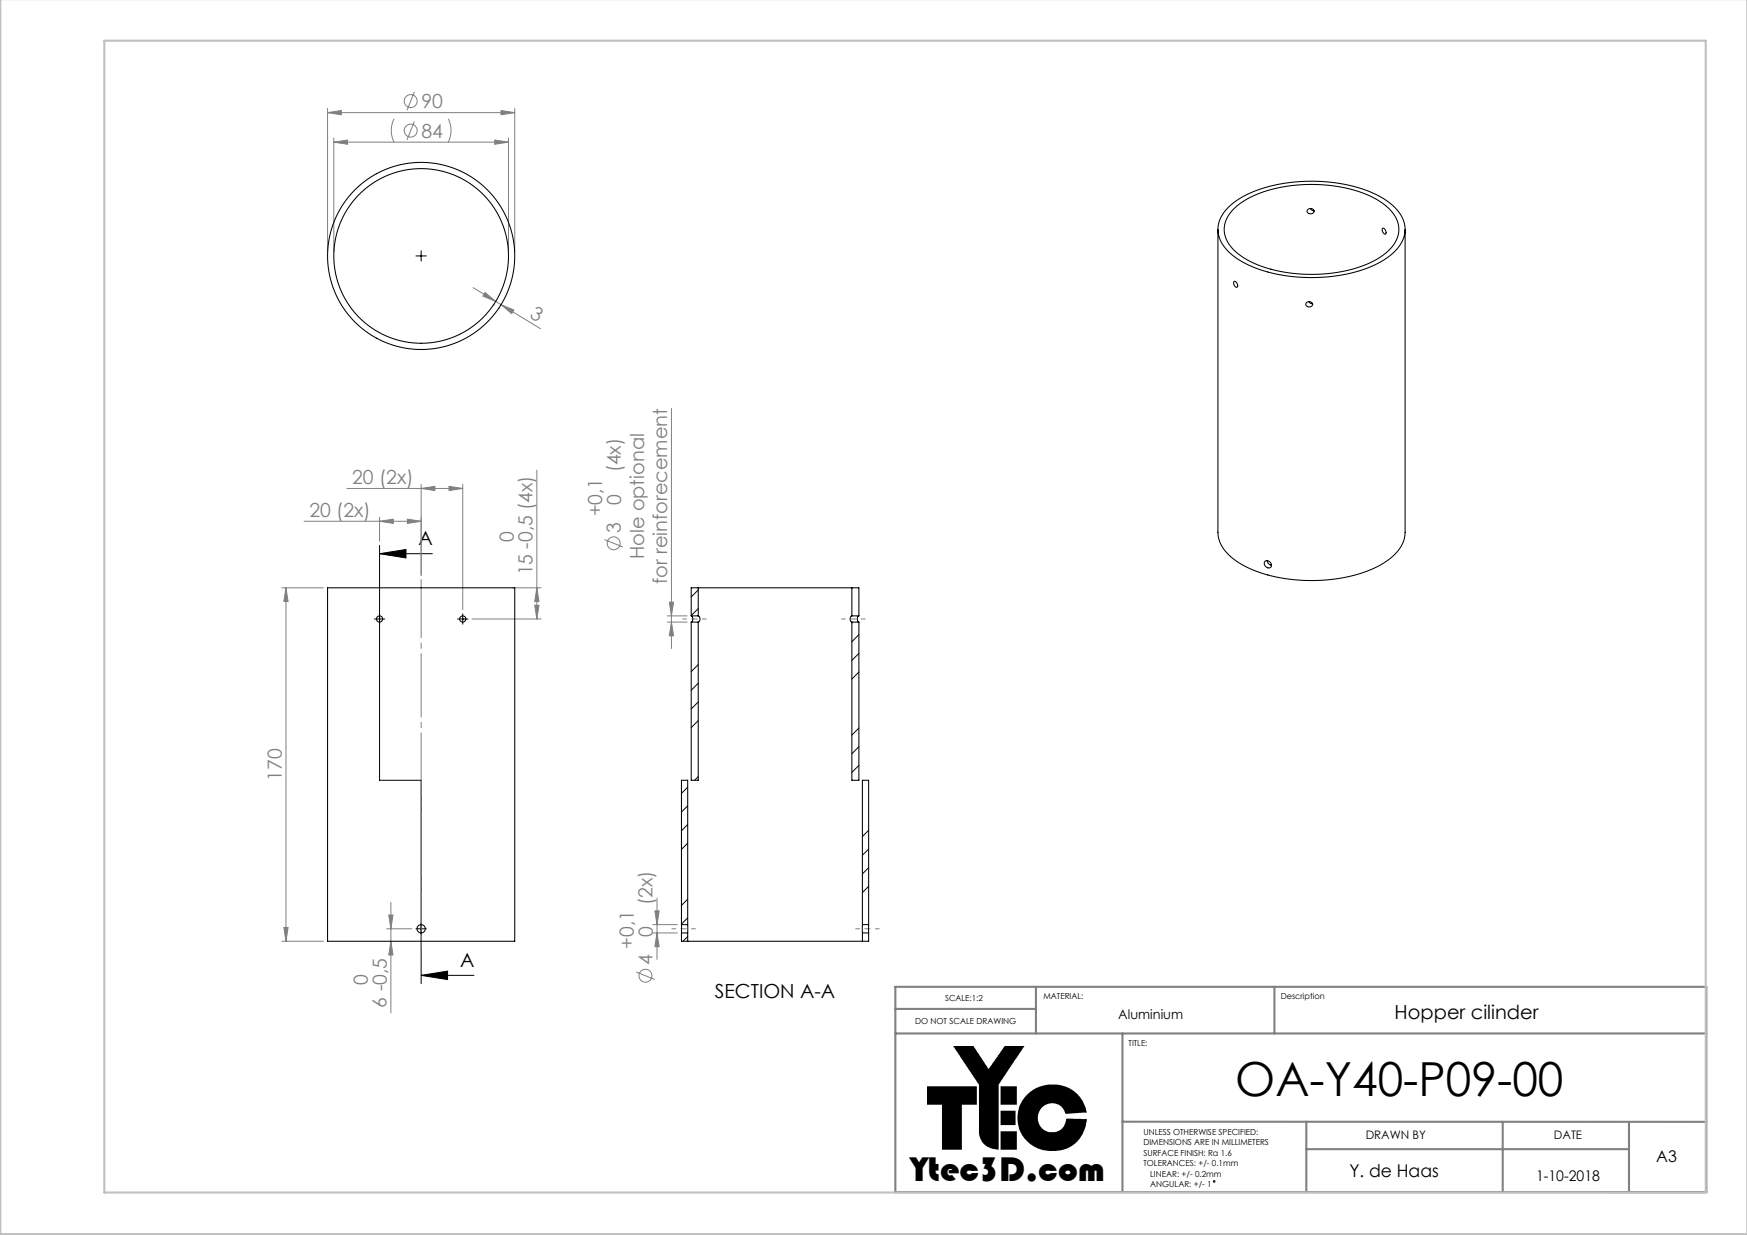
[picture p100: page 1]
Hopper cilinder; Hole optional; for reinforecement; SECTION A-A

DO NOT SCALE DRAWING

Ytec3D.com | TITLE: OA-Y40-P09-00

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

Y. de Haas | 1-10-2018
