MSherbinii/Binder-Jet-3D-Printer/Oasis make package 20181230/Mechanical/OA-Y50 Piston/OA-Y50-P02-00.PDF

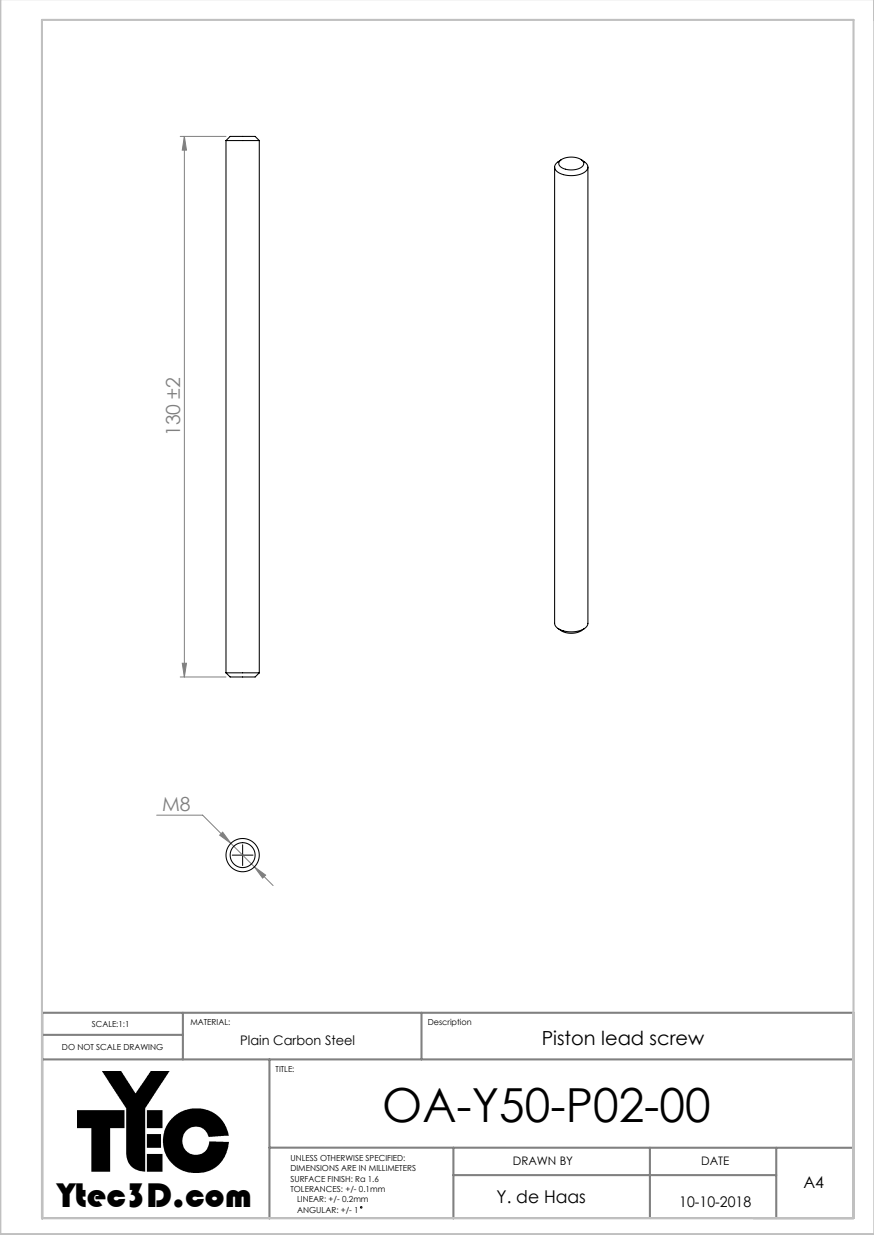
[picture p102: page 1]

MATERIAL:
Plain Carbon Steel

Piston lead screw

DO NOT SCALE DRAWING

Ytec3D.com | TITLE: OA-Y50-P02-00

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

Y. de Haas | 10-10-2018
