MSherbinii/Binder-Jet-3D-Printer/Oasis make package 20181230/Mechanical/OA-Y10 Baseframe/OA-Y10-A02-00.PDF

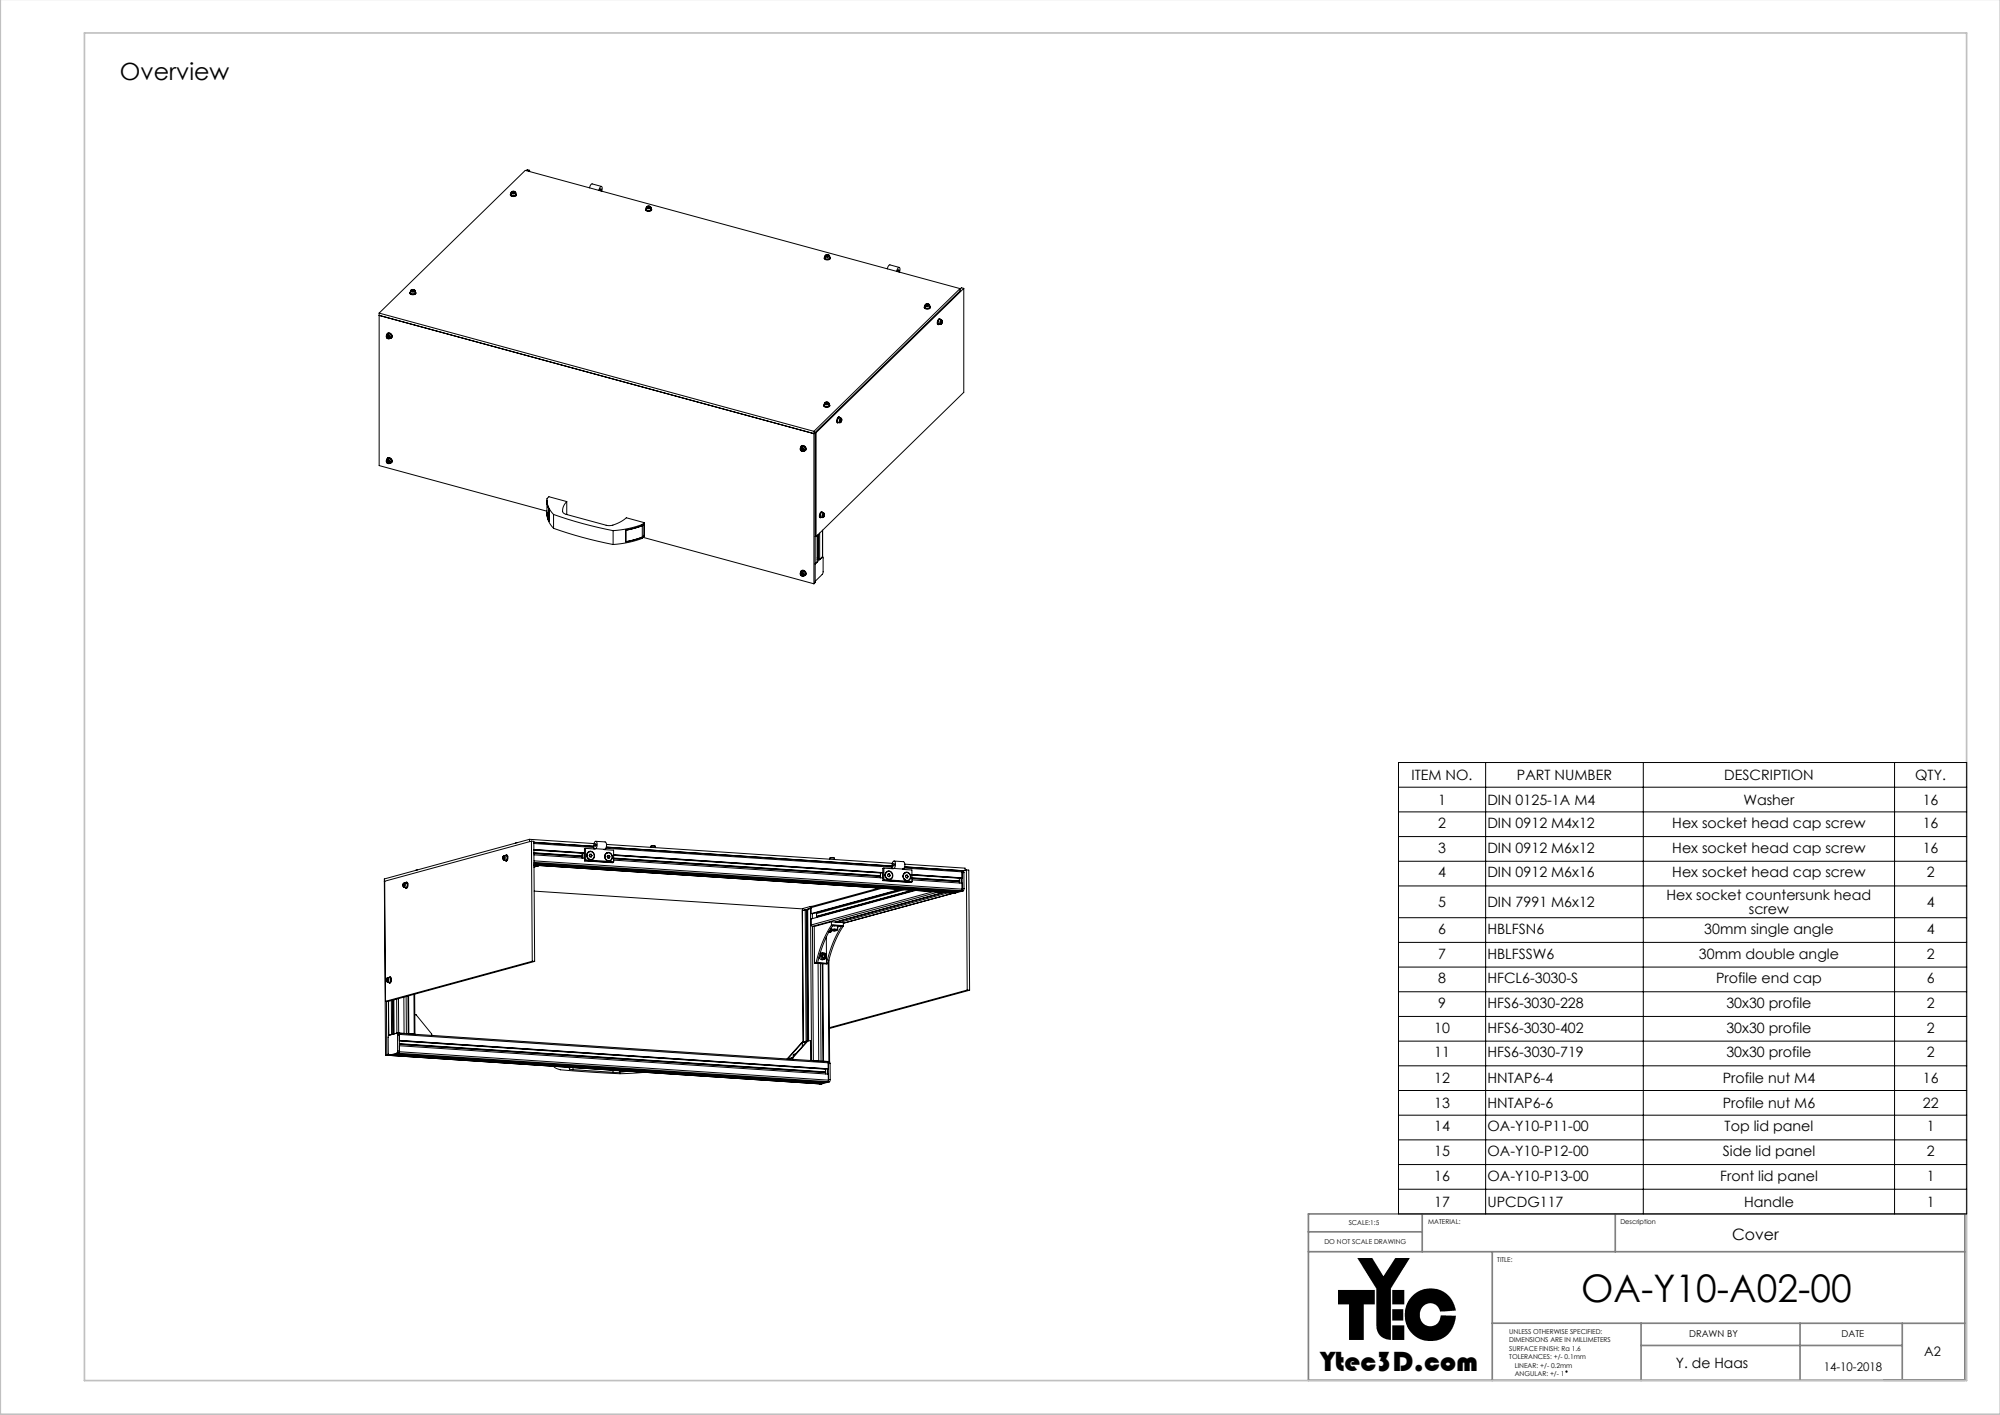
[picture p114: page 1]

ITEM NO. | PART NUMBER | DESCRIPTION | QTY.
1 | DIN 0125-1A M4 | Washer | 16
2 | DIN 0912 M4x12 | Hex socket head cap screw | 16
3 | DIN 0912 M6x12 | Hex socket head cap screw | 16
4 | DIN 0912 M6x16 | Hex socket head cap screw | 2
5 | DIN 7991 M6x12 | Hex socket countersunk head screw | 4
6 | HBLFSN6 | 30mm single angle | 4
7 | HBLFSSW6 | 30mm double angle | 2
8 | HFCL6-3030-S | Profile end cap | 6
9 | HFS6-3030-228 | 30x30 profile | 2
10 | HFS6-3030-402 | 30x30 profile | 2
11 | HFS6-3030-719 | 30x30 profile | 2
12 | HNTAP6-4 | Profile nut M4 | 16
13 | HNTAP6-6 | Profile nut M6 | 22
14 | OA-Y10-P11-00 | Top lid panel | 1
15 | OA-Y10-P12-00 | Side lid panel | 2
16 | OA-Y10-P13-00 | Front lid panel | 1
17 | UPCDG117 | Handle | 1

SCALE:1:5 | MATERIAL: | Description Cover
Ytec3D.com | TITLE: OA-Y10-A02-00

DO NOT SCALE DRAWING

DIMENSIONS ARE IN MILLIMETERS SURFACE FINISH: Ra 1.6 TOLERANCES: +/- 0.1mm LINEAR: +/- 0.2mm ANGULAR: +/- 1 | DRAWN BY UNLESS OTHERWISE SPECIFIED: | DATE | A2

Y. de Haas | 14-10-2018

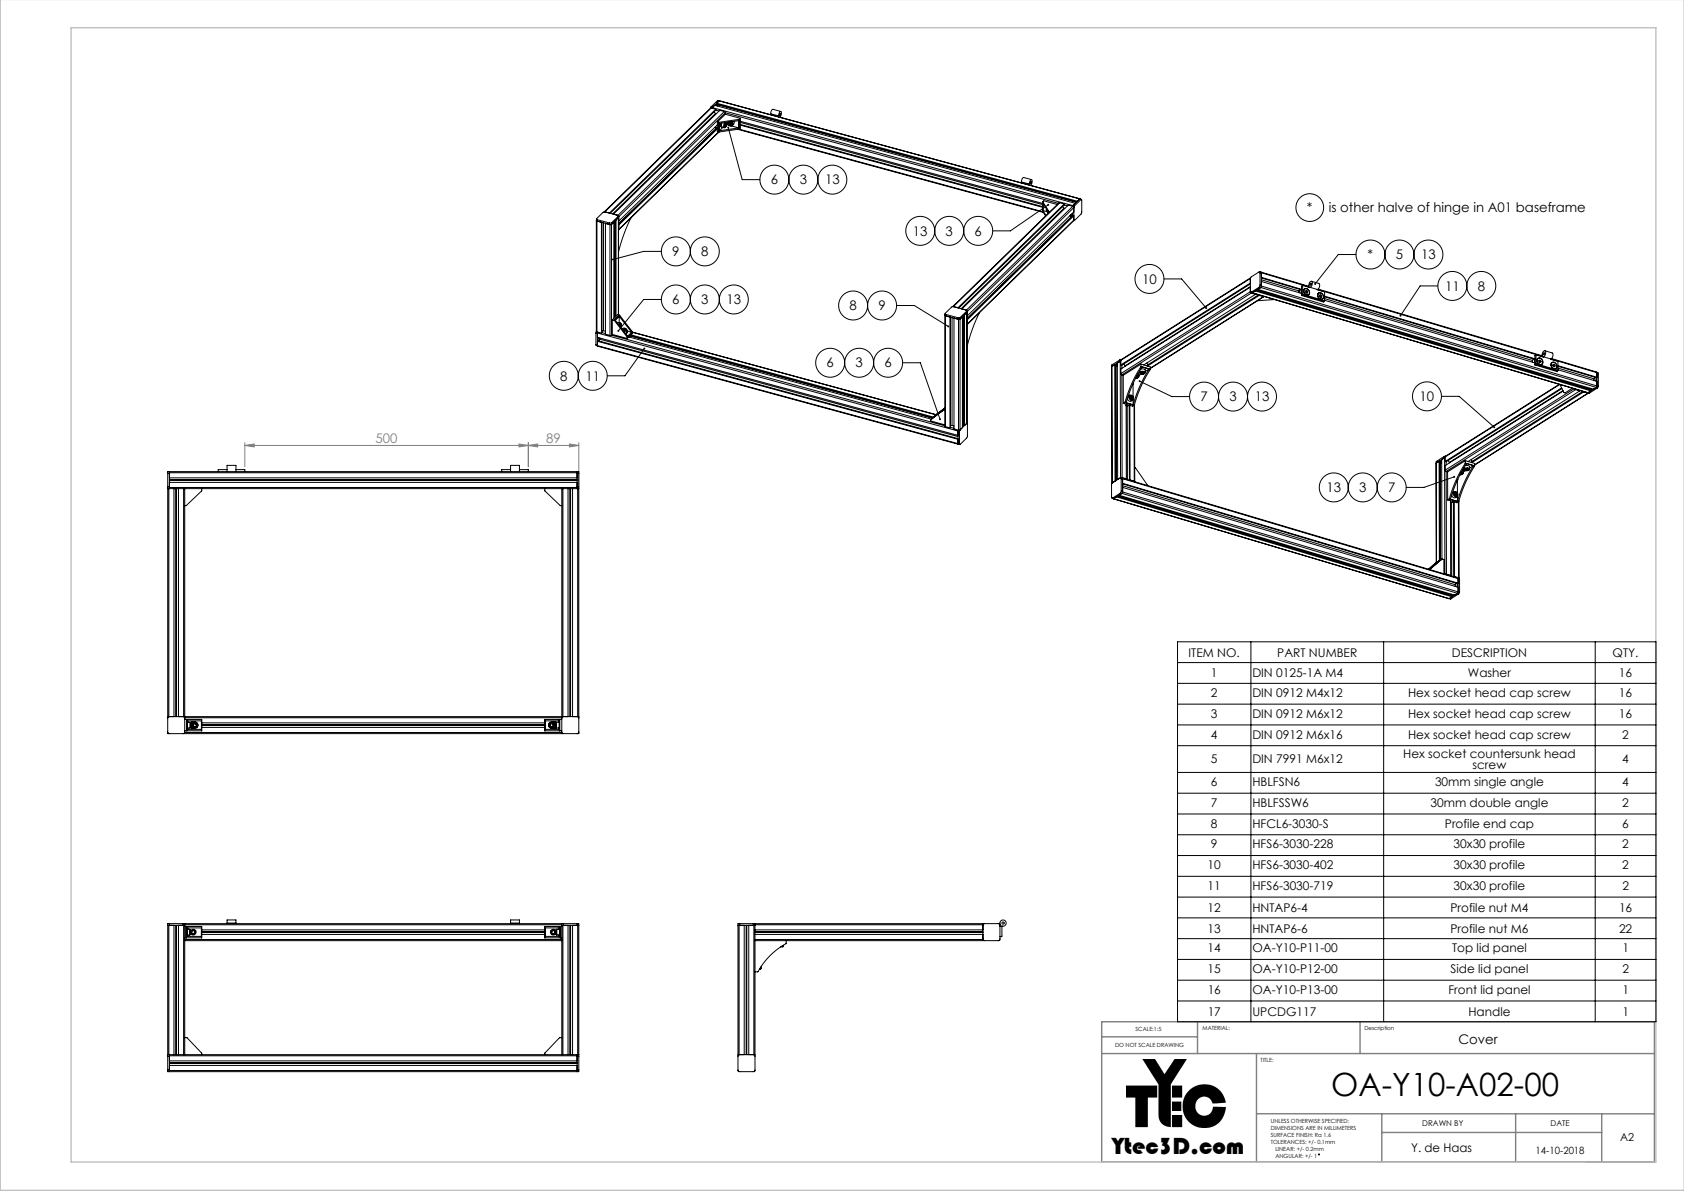
[picture p115: page 2]

* is other halve of hinge in A01 baseframe

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

SCALE:1:5 | MATERIAL: | Description Cover

DO NOT SCALE DRAWING

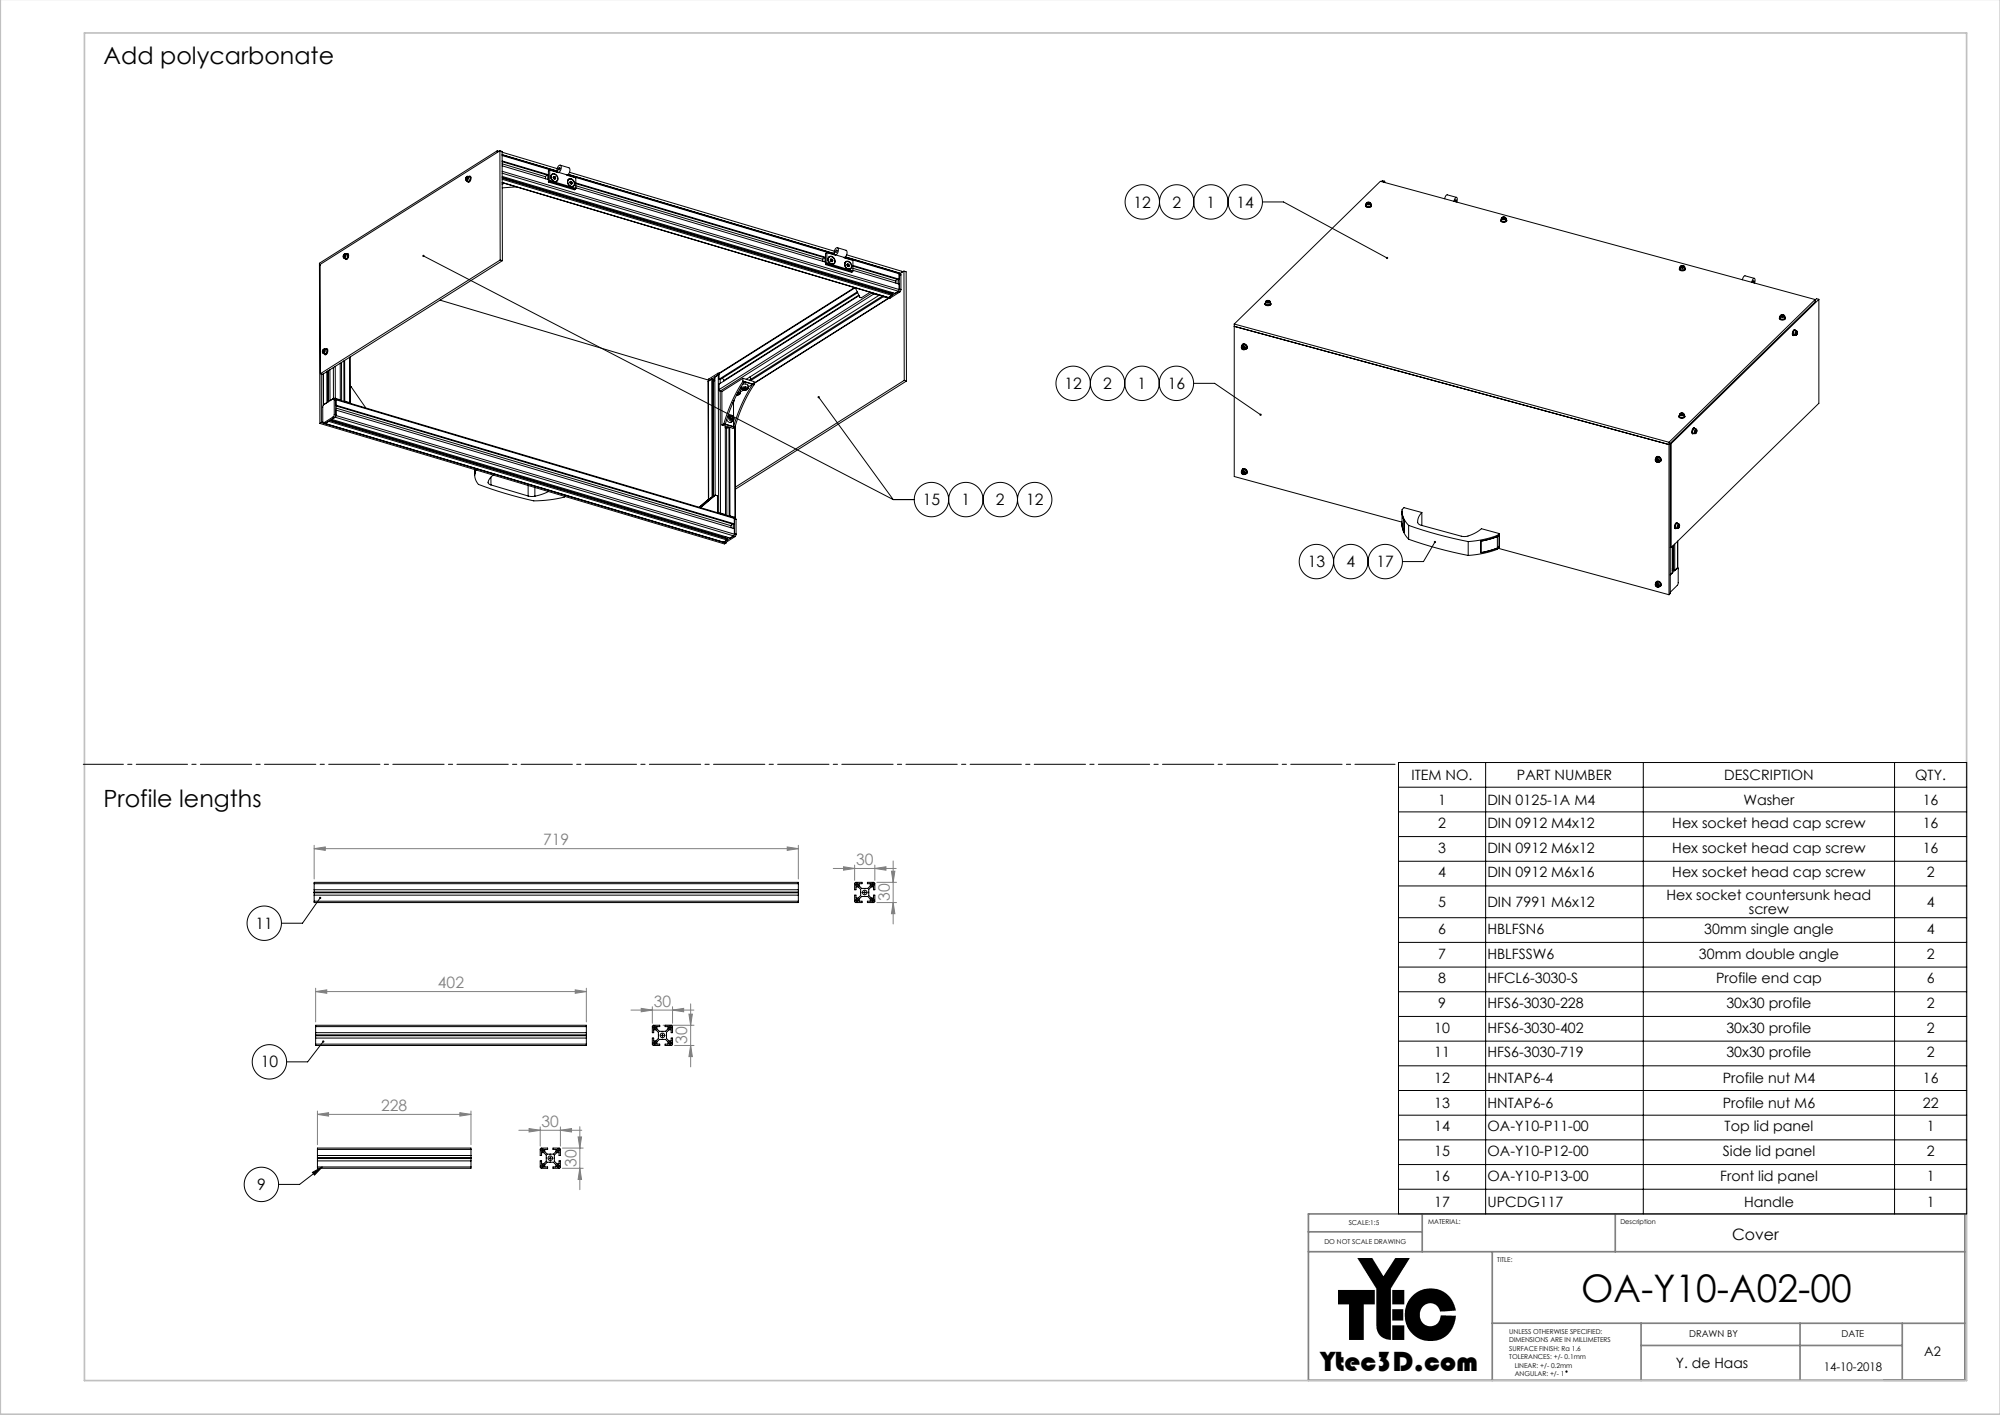
[picture p116: page 3]
Profile lengths; Add polycarbonate

719 | ITEM NO. | PART NUMBER | DESCRIPTION | QTY.

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

SCALE:1:5 | MATERIAL: | Description Cover

DO NOT SCALE DRAWING
