MSherbinii/Binder-Jet-3D-Printer/Oasis make package 20181230/Mechanical/OA-Y10 Baseframe/OA-Y10-A03-00.PDF

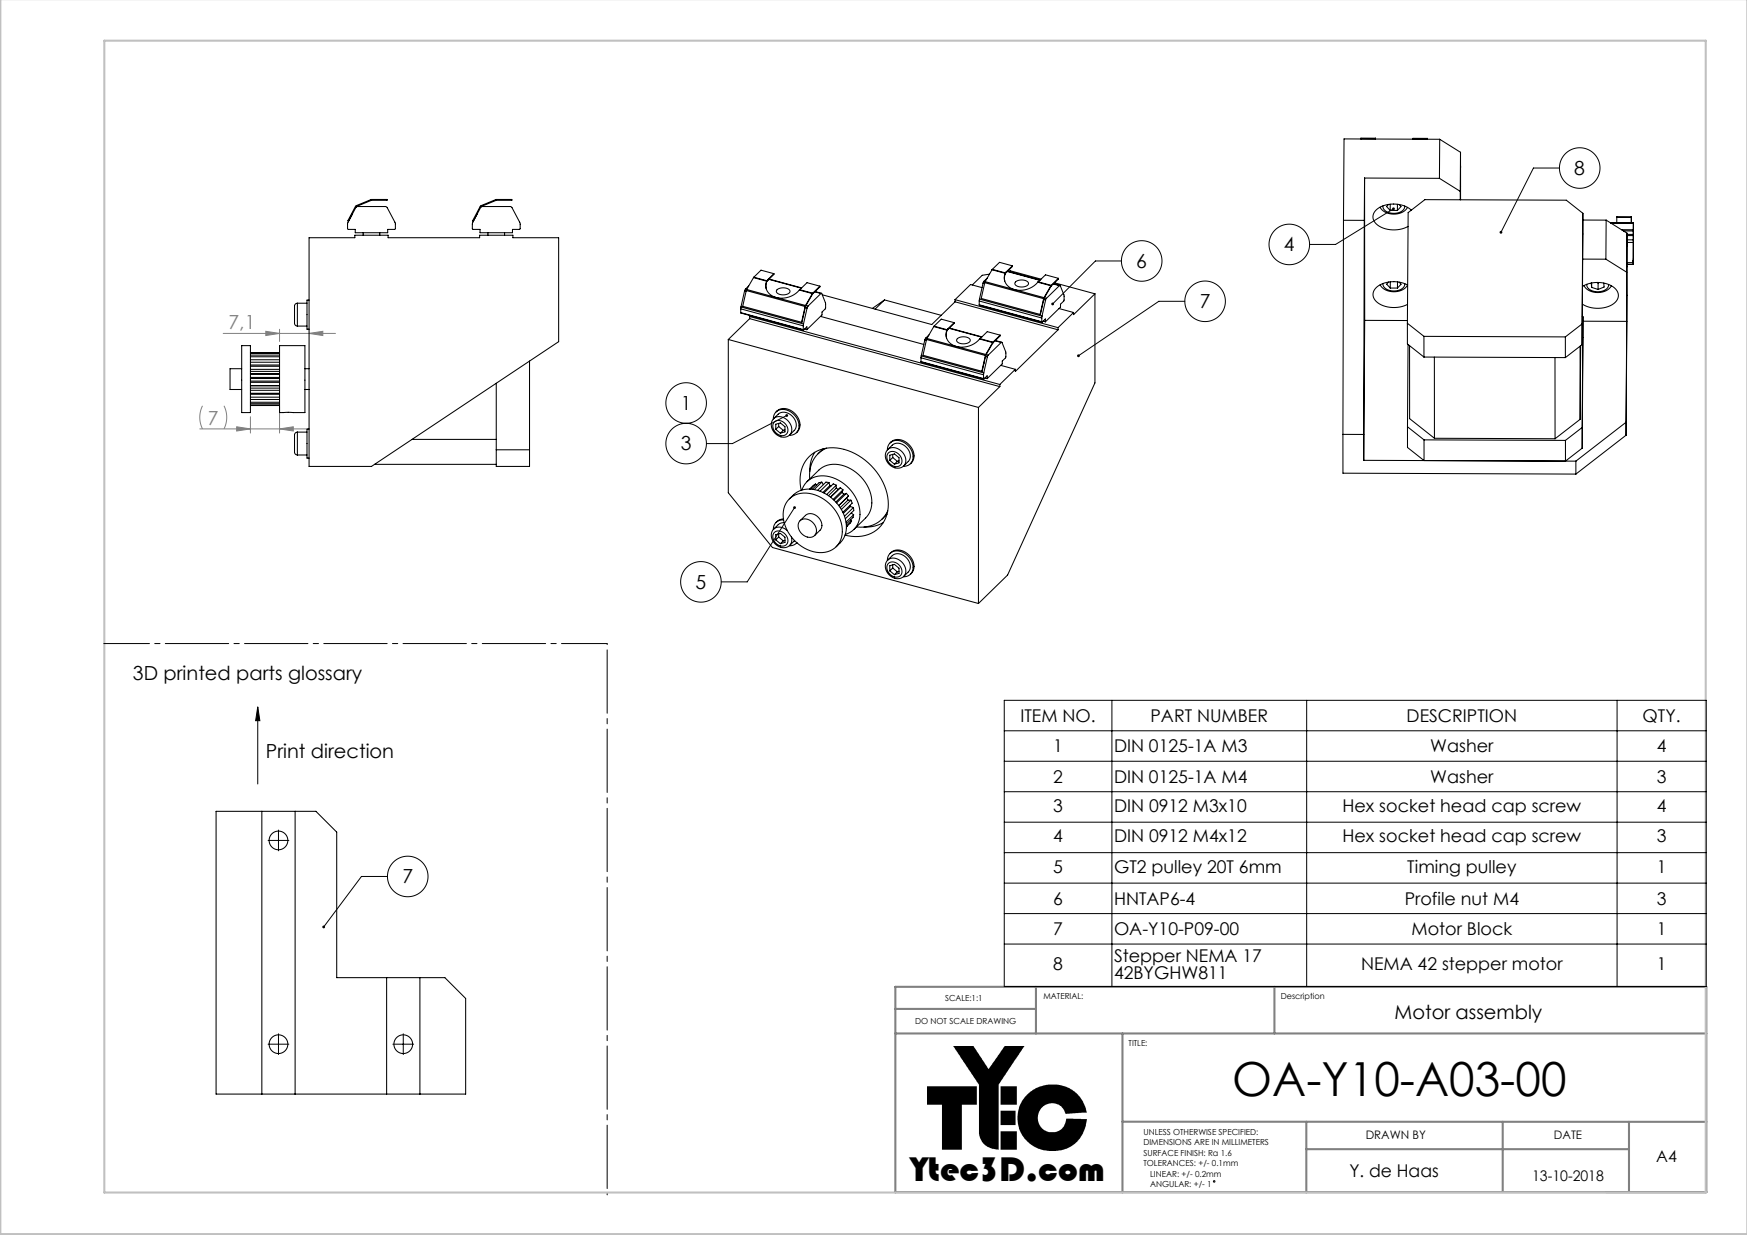
[picture p117: page 1]
Print direction

3D printed parts glossary

ITEM NO. | PART NUMBER | DESCRIPTION | QTY.
1 | DIN 0125-1A M3 | Washer | 4
2 | DIN 0125-1A M4 | Washer | 3
3 | DIN 0912 M3x10 | Hex socket head cap screw | 4
4 | DIN 0912 M4x12 | Hex socket head cap screw | 3
5 | GT2 pulley 20T 6mm | Timing pulley | 1
6 | HNTAP6-4 | Profile nut M4 | 3
7 | OA-Y10-P09-00 | Motor Block | 1
8 | Stepper NEMA 17 42BYGHW811 | NEMA 42 stepper motor | 1

SCALE:1:1 | MATERIAL: | Description Motor assembly
Ytec3D.com | TITLE: OA-Y10-A03-00

DO NOT SCALE DRAWING

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

Y. de Haas | 13-10-2018
