MSherbinii/Binder-Jet-3D-Printer/Oasis make package 20181230/Mechanical/OA-Y10 Baseframe/OA-Y10-A04-00.PDF

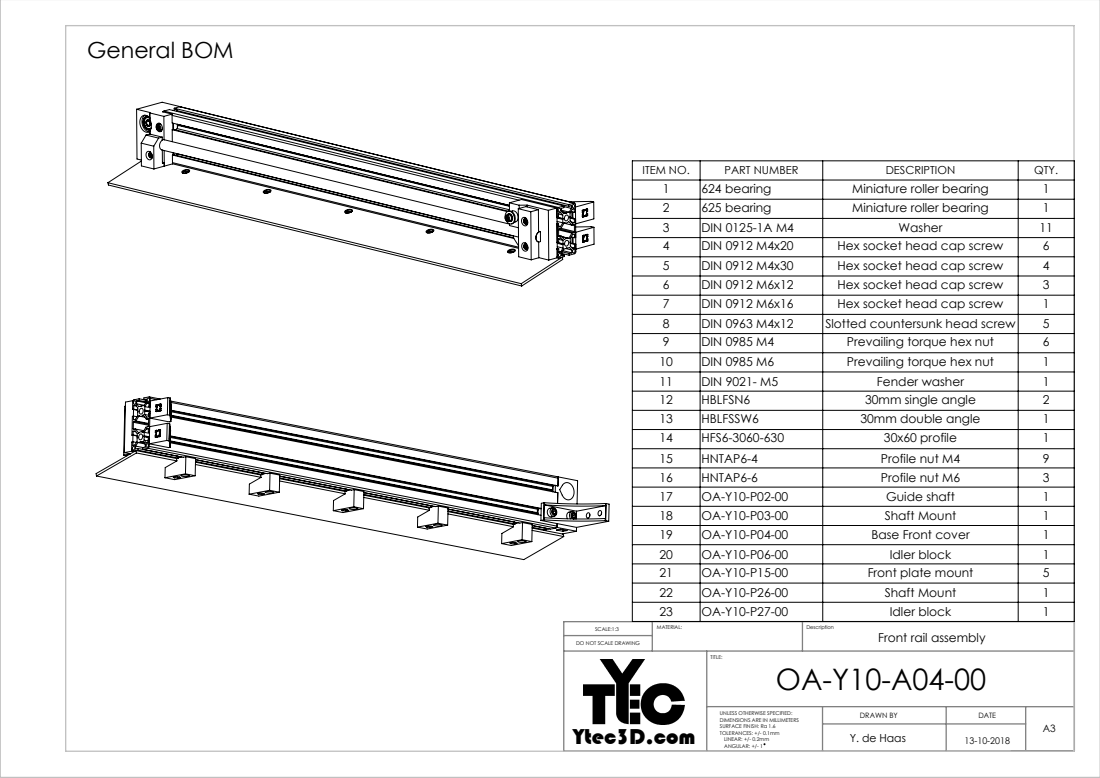
[picture p118: page 1]
General BOM

ITEM NO. | PART NUMBER | DESCRIPTION | QTY.
1 | 624 bearing | Miniature roller bearing | 1
2 | 625 bearing | Miniature roller bearing | 1
3 | DIN 0125-1A M4 | Washer | 11
4 | DIN 0912 M4x20 | Hex socket head cap screw | 6
5 | DIN 0912 M4x30 | Hex socket head cap screw | 4
6 | DIN 0912 M6x12 | Hex socket head cap screw | 3
7 | DIN 0912 M6x16 | Hex socket head cap screw | 1
8 | DIN 0963 M4x12 | Slotted countersunk head screw | 5
9 | DIN 0985 M4 | Prevailing torque hex nut | 6
10 | DIN 0985 M6 | Prevailing torque hex nut | 1
11 | DIN 9021- M5 | Fender washer | 1
12 | HBLFSN6 | 30mm single angle | 2
13 | HBLFSSW6 | 30mm double angle | 1
14 | HFS6-3060-630 | 30x60 profile | 1
15 | HNTAP6-4 | Profile nut M4 | 9
16 | HNTAP6-6 | Profile nut M6 | 3
17 | OA-Y10-P02-00 | Guide shaft | 1
18 | OA-Y10-P03-00 | Shaft Mount | 1
19 | OA-Y10-P04-00 | Base Front cover | 1
20 | OA-Y10-P06-00 | Idler block | 1
21 | OA-Y10-P15-00 | Front plate mount | 5
22 | OA-Y10-P26-00 | Shaft Mount | 1
23 | OA-Y10-P27-00 | Idler block | 1

SCALE:1:3 | MATERIAL: | Description Front rail assembly
Ytec3D.com | TITLE: OA-Y10-A04-00

DO NOT SCALE DRAWING

DIMENSIONS ARE IN MILLIMETERS SURFACE FINISH: Ra 1.6 TOLERANCES: +/- 0.1mm LINEAR: +/- 0.2mm ANGULAR: +/- 1 | DRAWN BY UNLESS OTHERWISE SPECIFIED: | DATE | A3

Y. de Haas | 13-10-2018

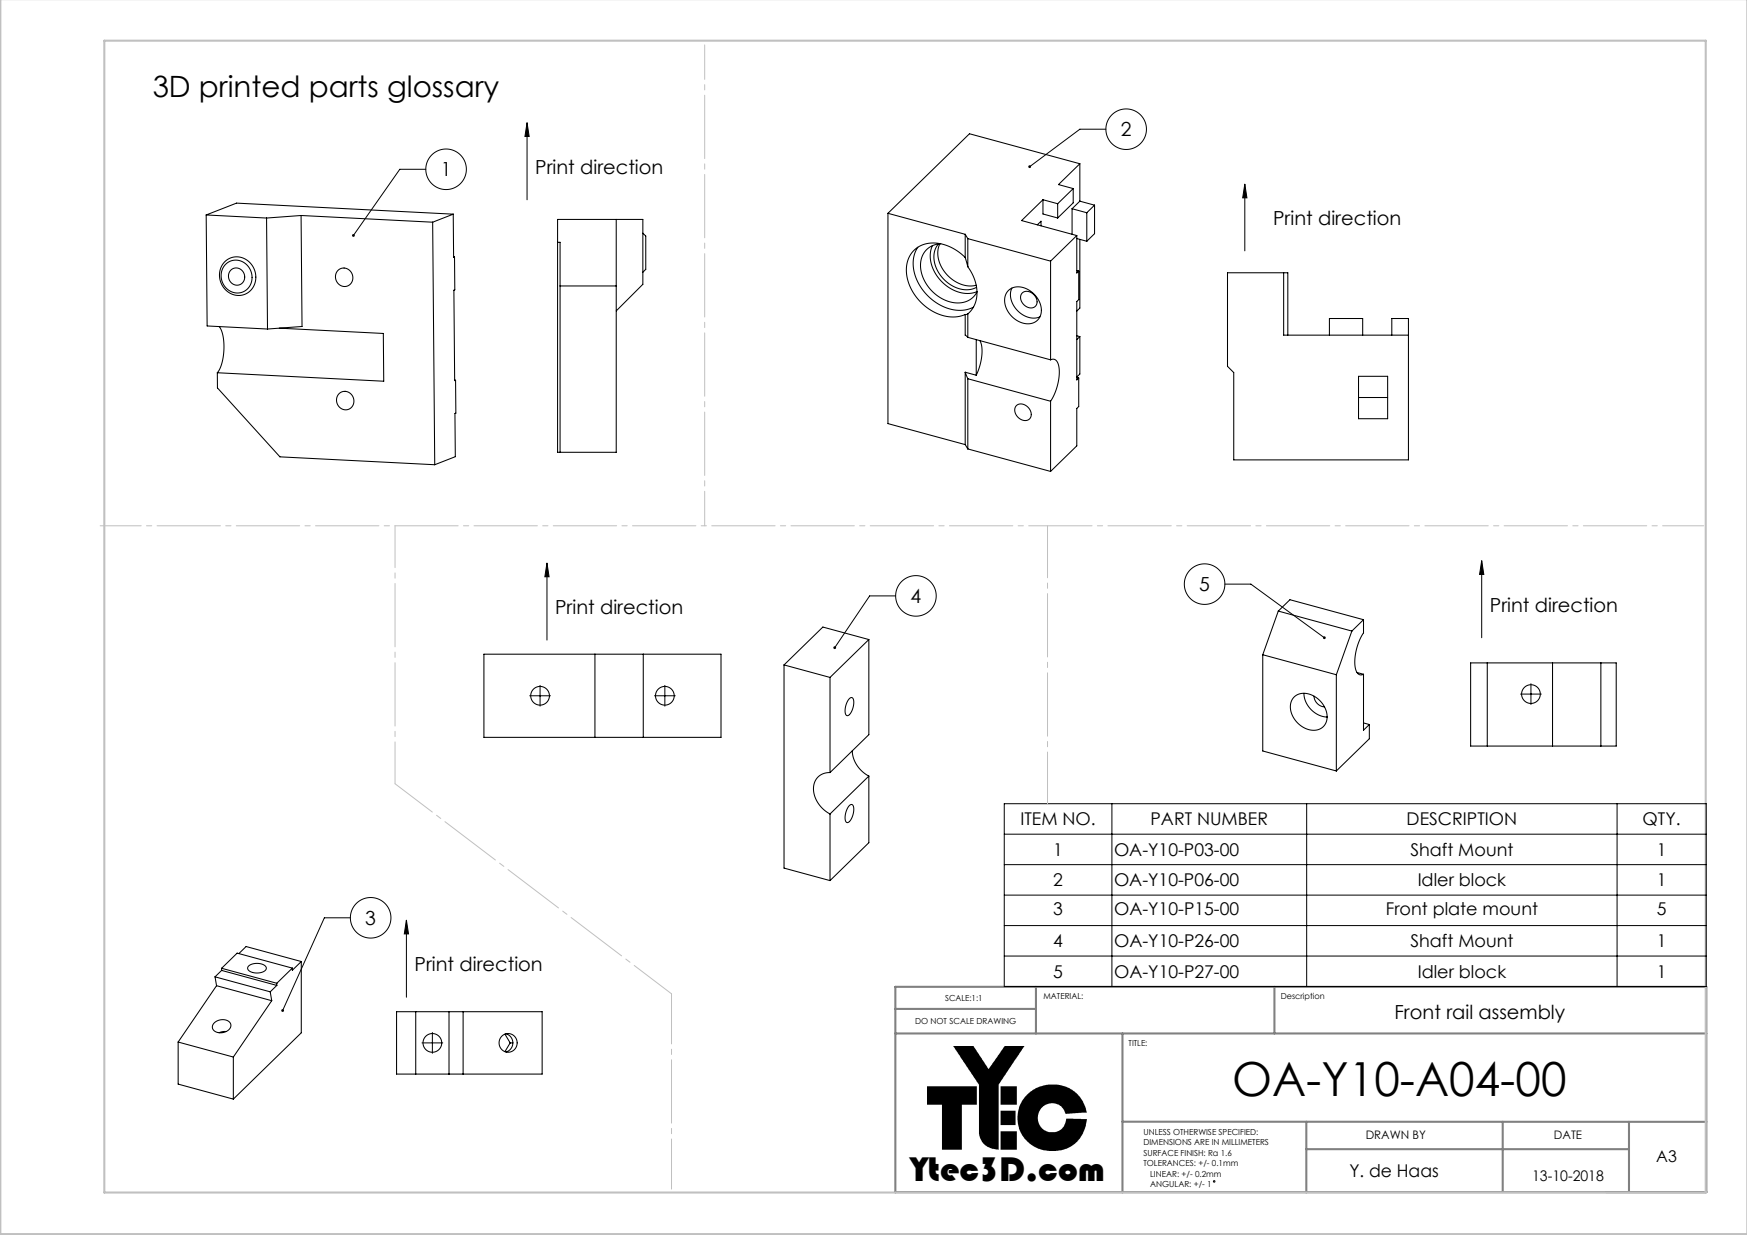
[picture p119: page 2]
Print direction; Print direction 4

3D printed parts glossary

ITEM NO. | PART NUMBER | DESCRIPTION | QTY.
1 | OA-Y10-P03-00 | Shaft Mount | 1
2 | OA-Y10-P06-00 | Idler block | 1
3 | OA-Y10-P15-00 | Front plate mount | 5
4 | OA-Y10-P26-00 | Shaft Mount | 1
5 | OA-Y10-P27-00 | Idler block | 1

SCALE:1:1 | MATERIAL: | Description Front rail assembly

DO NOT SCALE DRAWING

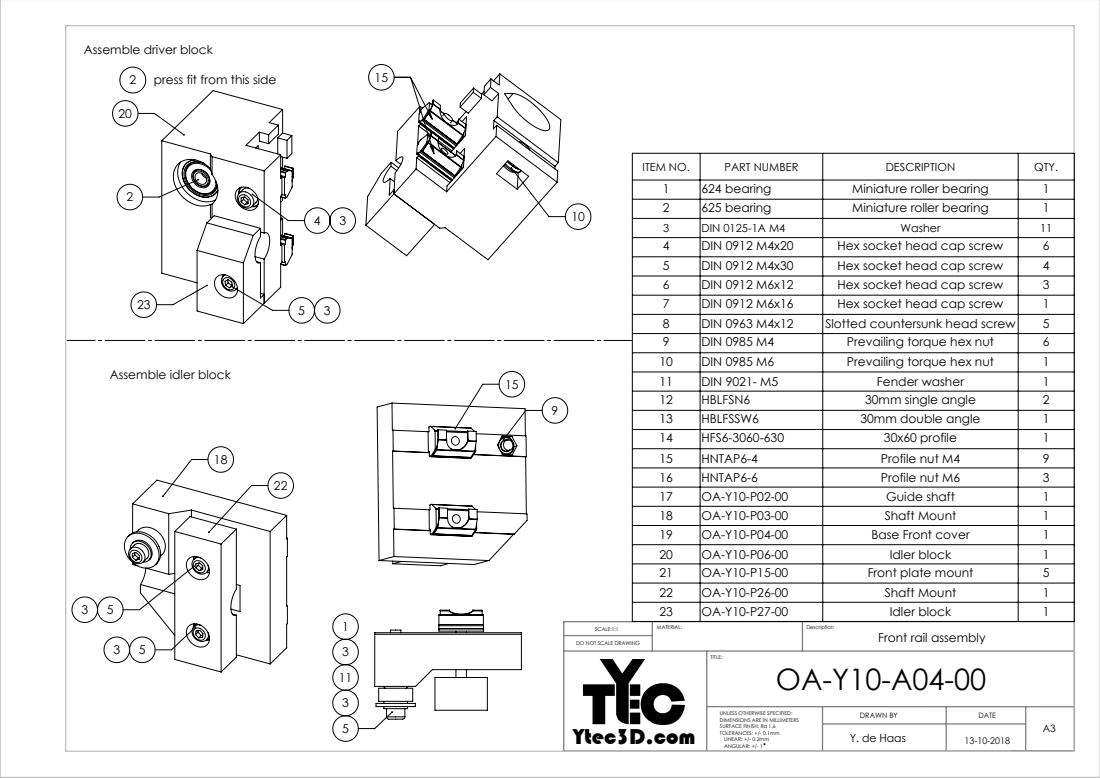
[picture p120: page 3]

Assemble driver block
2 press fit from this side

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

Assemble idler block

SCALE:1:1 | MATERIAL: | Description Front rail assembly

DO NOT SCALE DRAWING

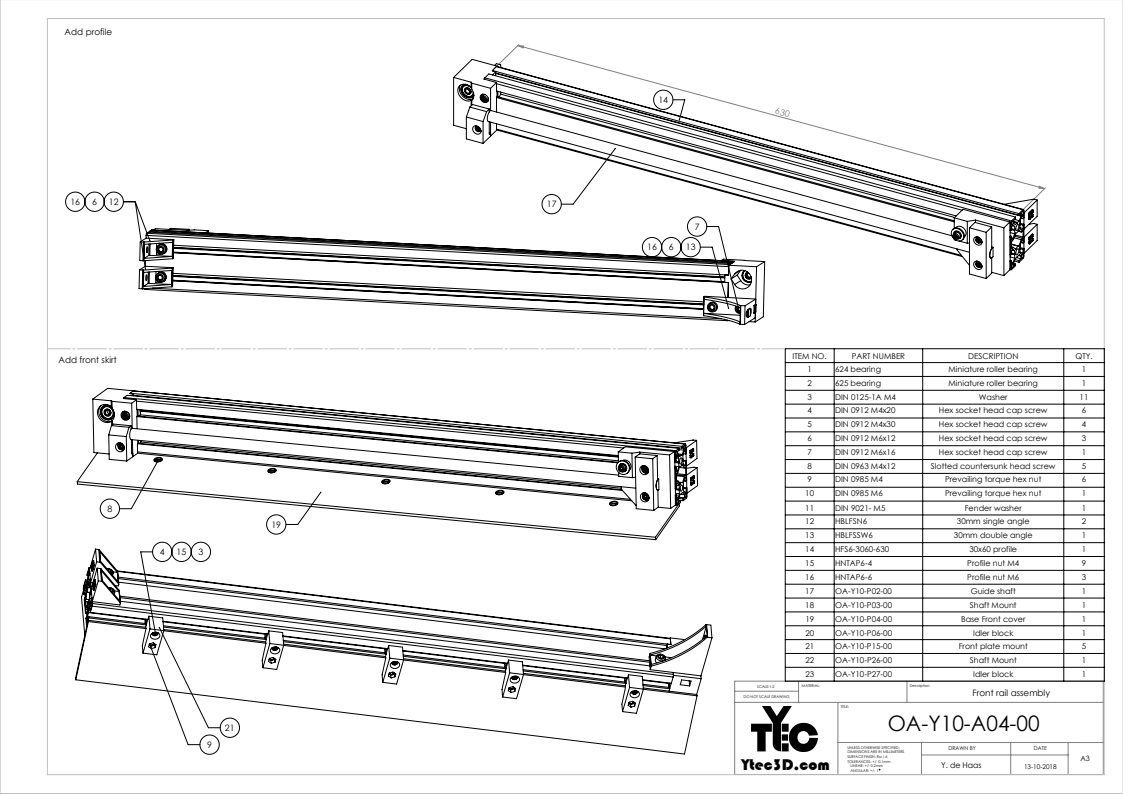
[picture p121: page 4]
Add profile

Add front skirt

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

SCALE:1:2 | MATERIAL: | Description Front rail assembly

DO NOT SCALE DRAWING
