MSherbinii/Binder-Jet-3D-Printer/Oasis make package 20181230/Mechanical/OA-Y10 Baseframe/OA-Y10-P01-00.PDF

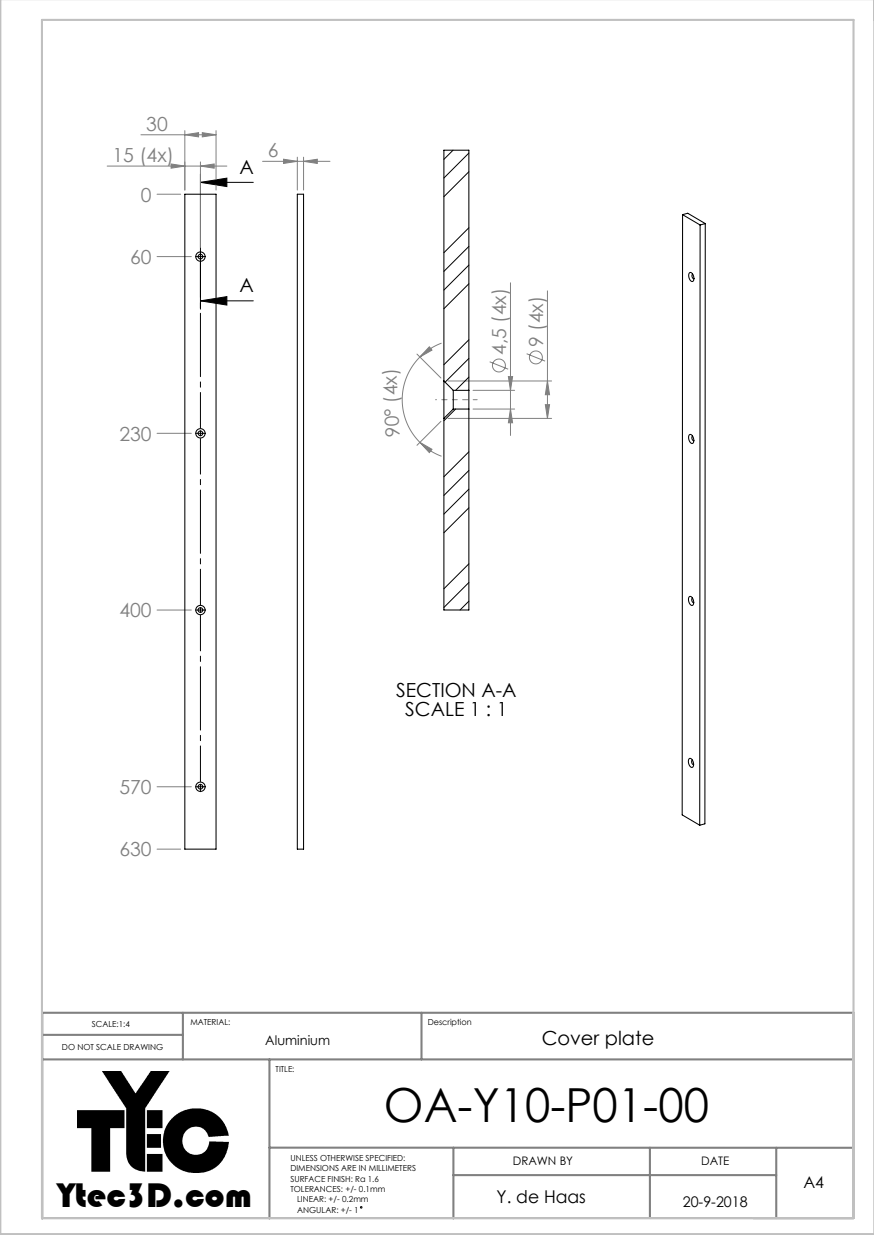
[picture p122: page 1]
Cover plate; SECTION A-A SCALE 1 : 1

DO NOT SCALE DRAWING

Ytec3D.com | TITLE: OA-Y10-P01-00

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

Y. de Haas | 20-9-2018
