MSherbinii/Binder-Jet-3D-Printer/Oasis make package 20181230/Mechanical/OA-Y10 Baseframe/OA-Y10-P10-00.PDF

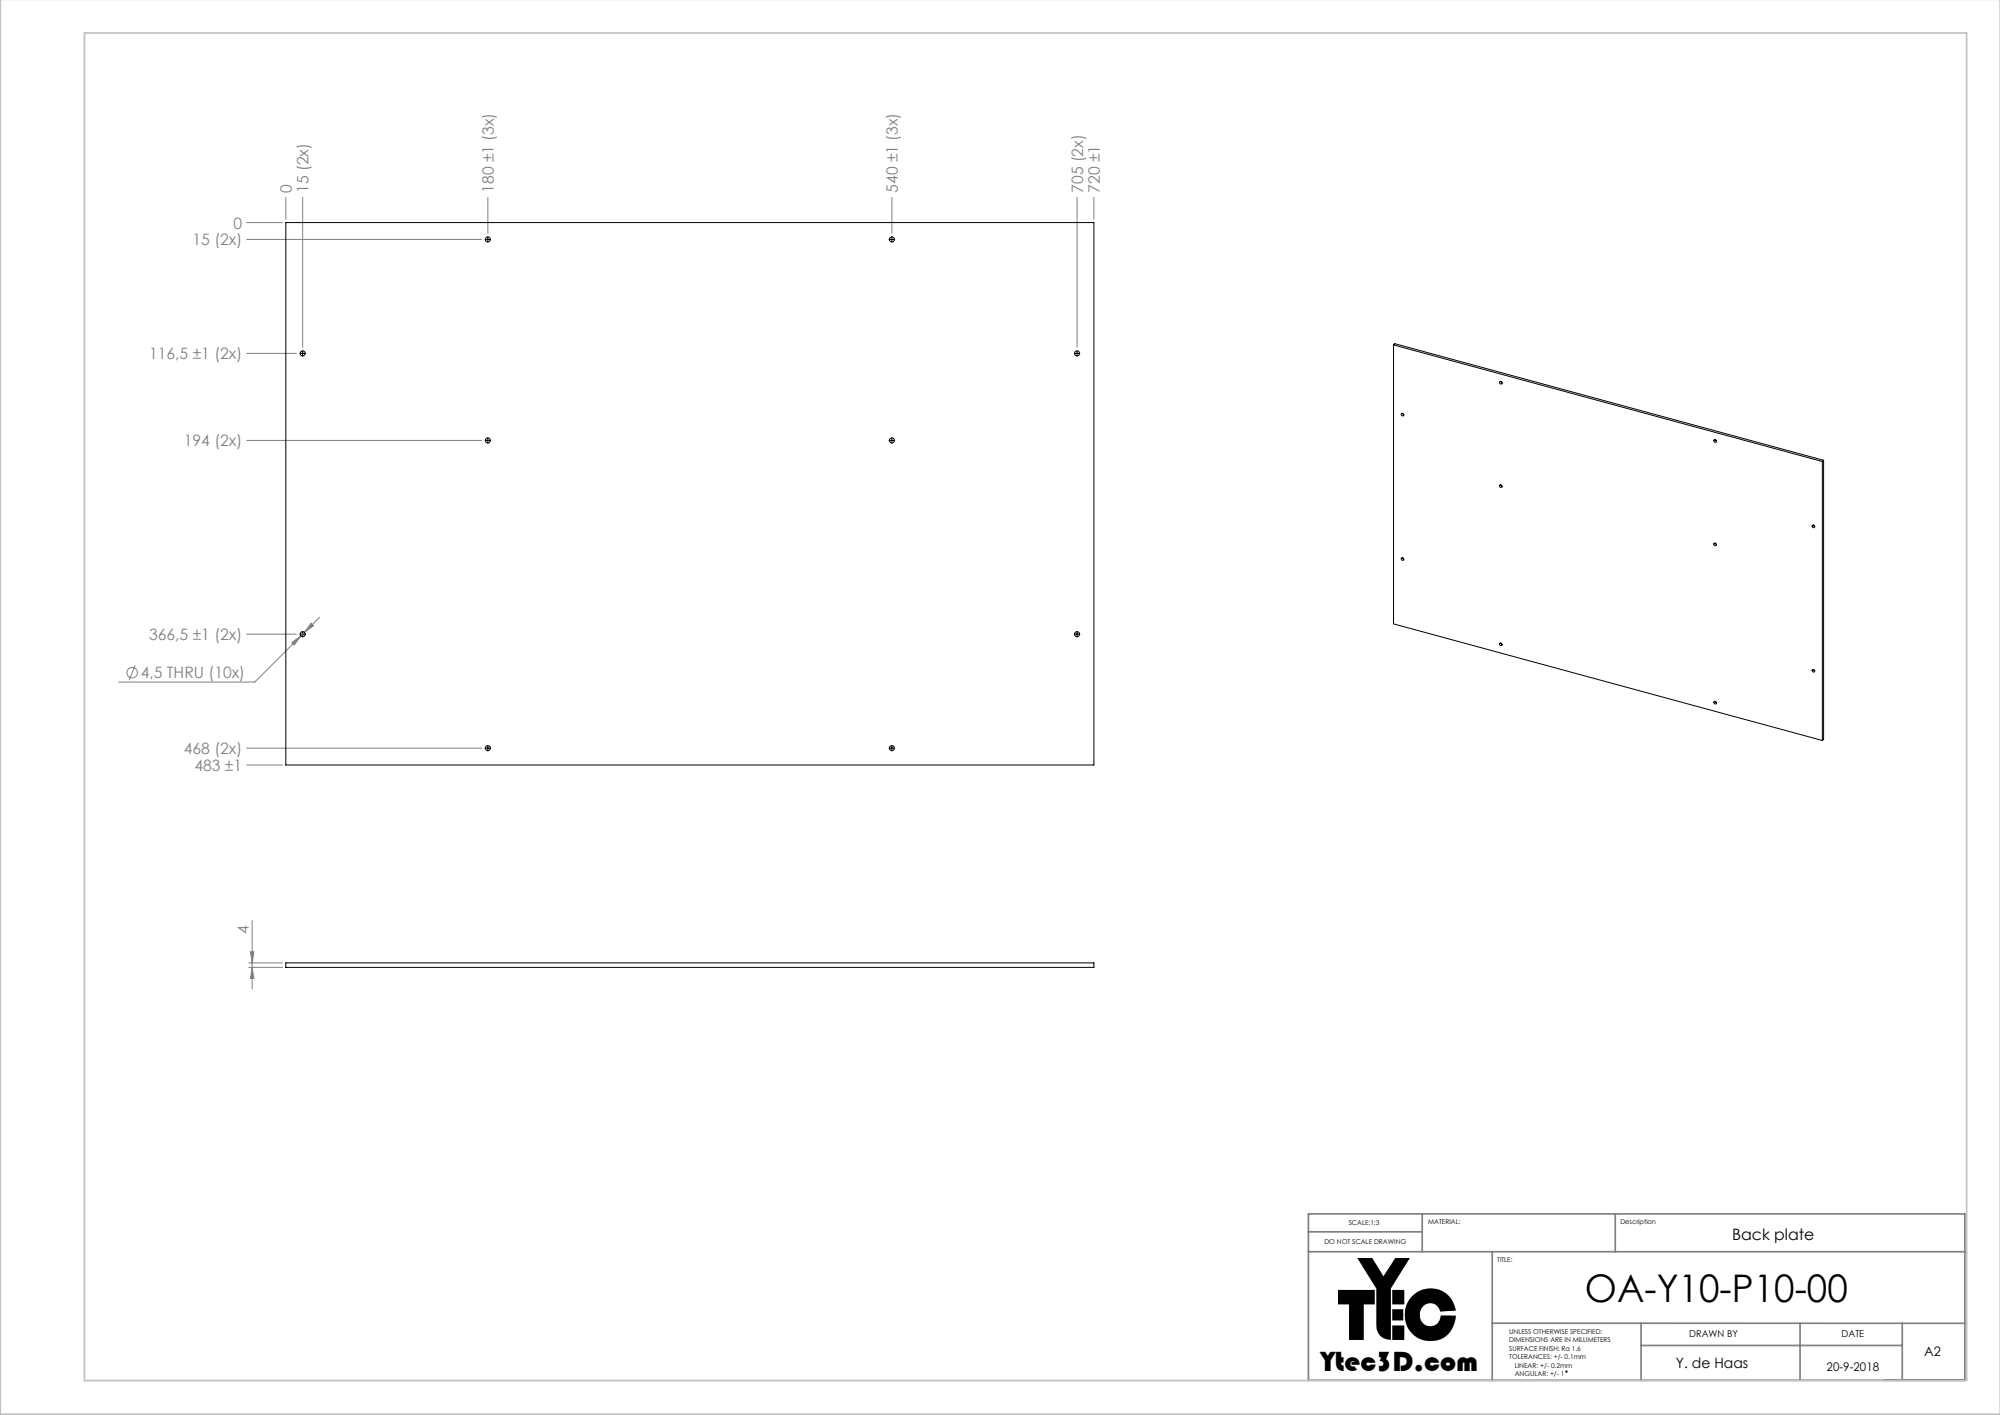
[picture p125: page 1]
Back plate; 4,5 THRU (10x)

DO NOT SCALE DRAWING

Ytec3D.com | TITLE: OA-Y10-P10-00

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

Y. de Haas | 20-9-2018
