MSherbinii/Binder-Jet-3D-Printer/Oasis make package 20181230/Mechanical/OA-Y10 Baseframe/OA-Y10-P13-00.PDF

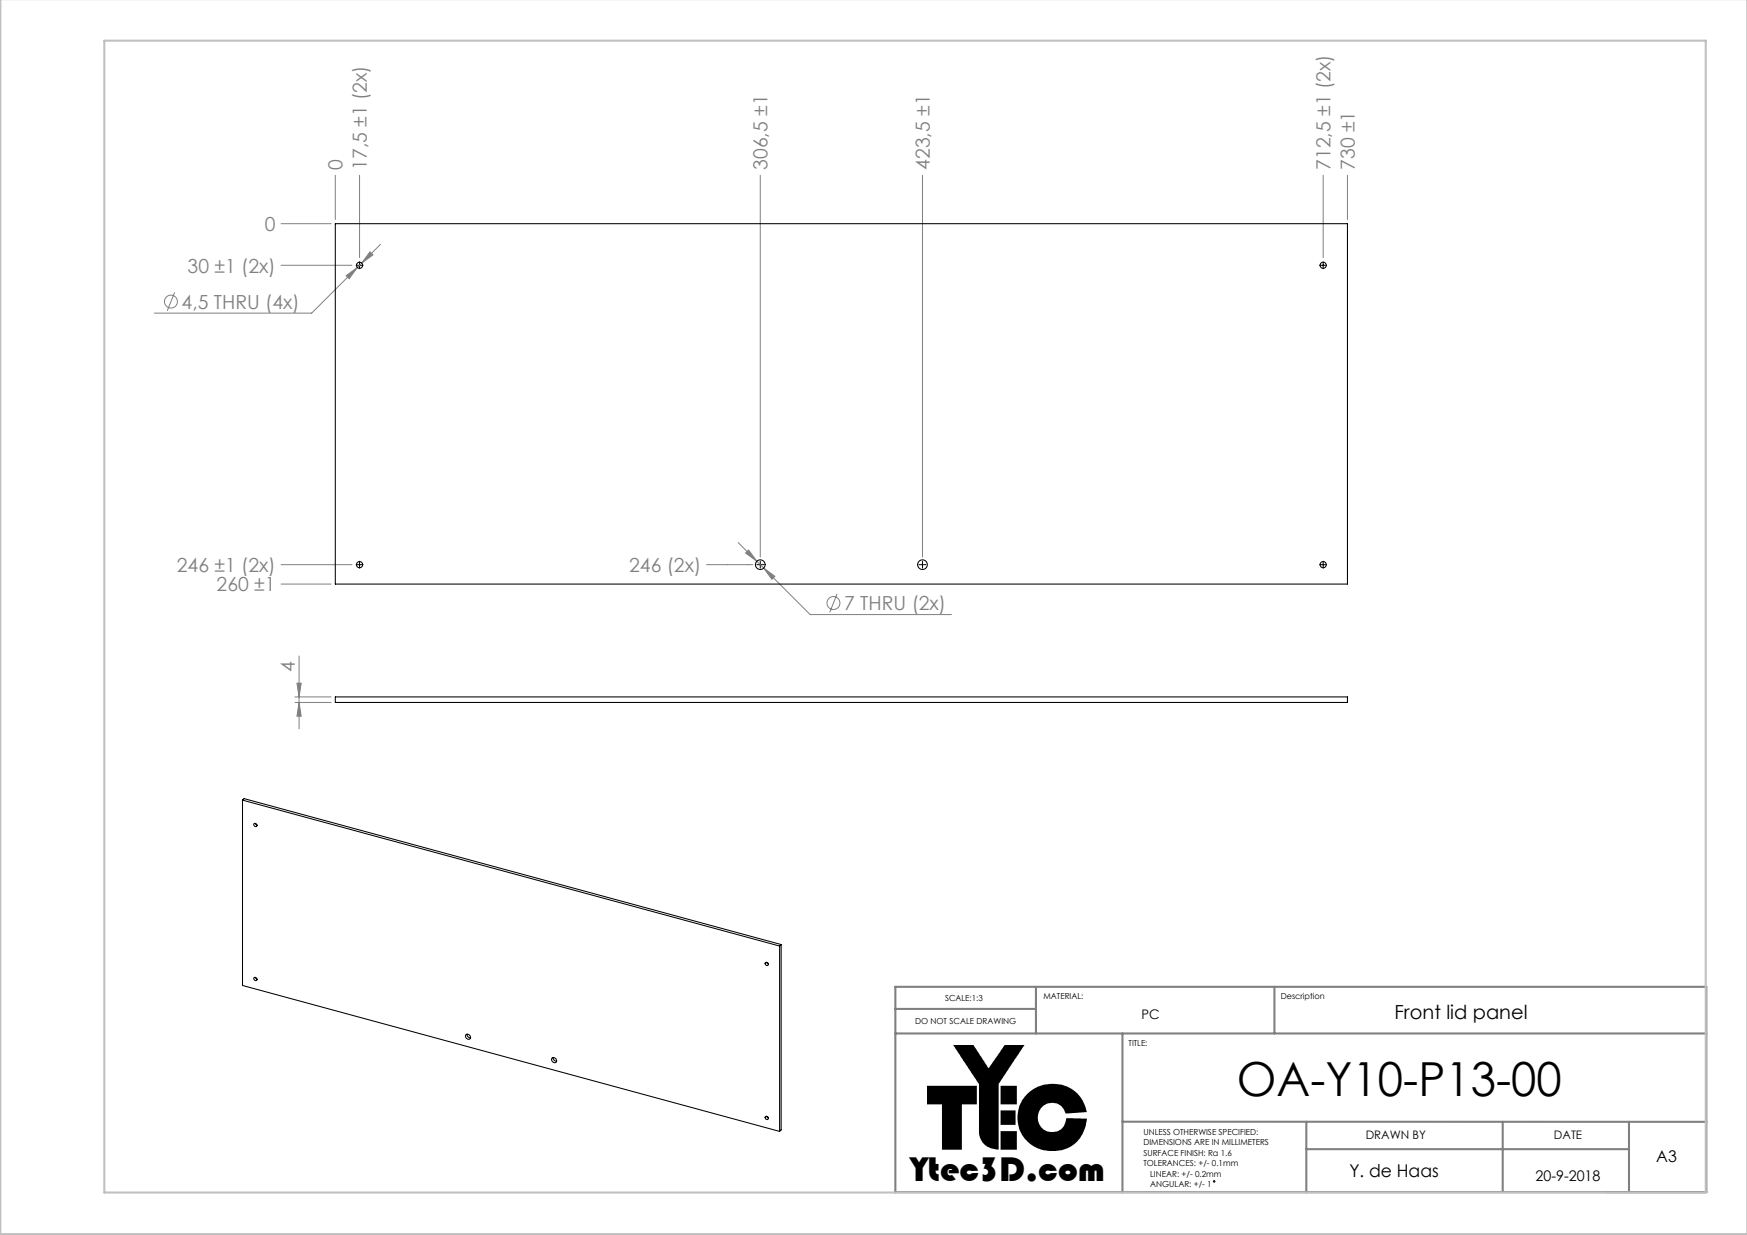
[picture p128: page 1]
4,5 THRU (4x); 7 THRU (2x)

Front lid panel

DO NOT SCALE DRAWING

Ytec3D.com | TITLE: OA-Y10-P13-00

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

Y. de Haas | 20-9-2018
