MSherbinii/Binder-Jet-3D-Printer/Oasis make package 20181230/Mechanical/OA-Y10 Baseframe/OA-Y10-P20-00.PDF

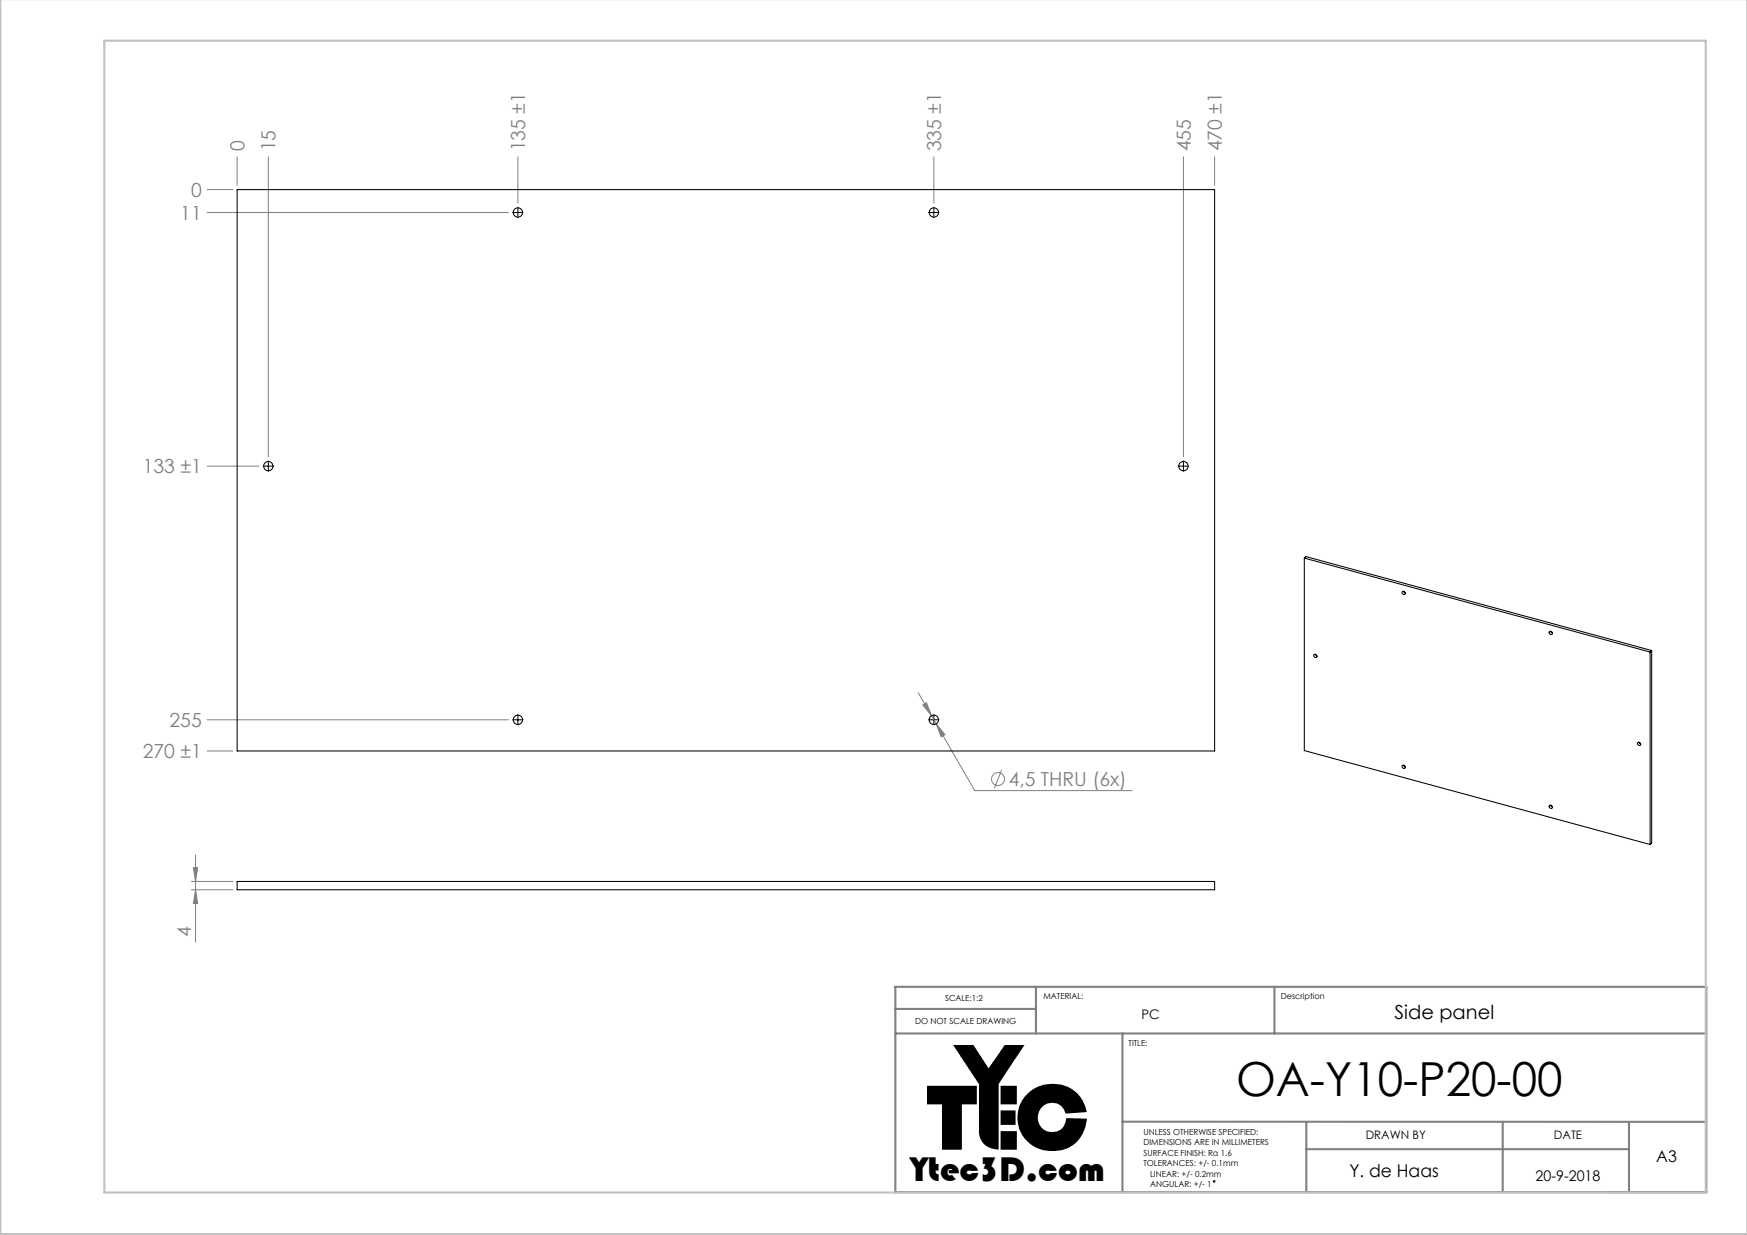
[picture p130: page 1]
Side panel; 4,5 THRU (6x)

DO NOT SCALE DRAWING

Ytec3D.com | TITLE: OA-Y10-P20-00

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

Y. de Haas | 20-9-2018
