MSherbinii/Binder-Jet-3D-Printer/Oasis make package 20181230/Mechanical/OA-Y15 Overshoot bin/OA-Y15-A01-00.PDF

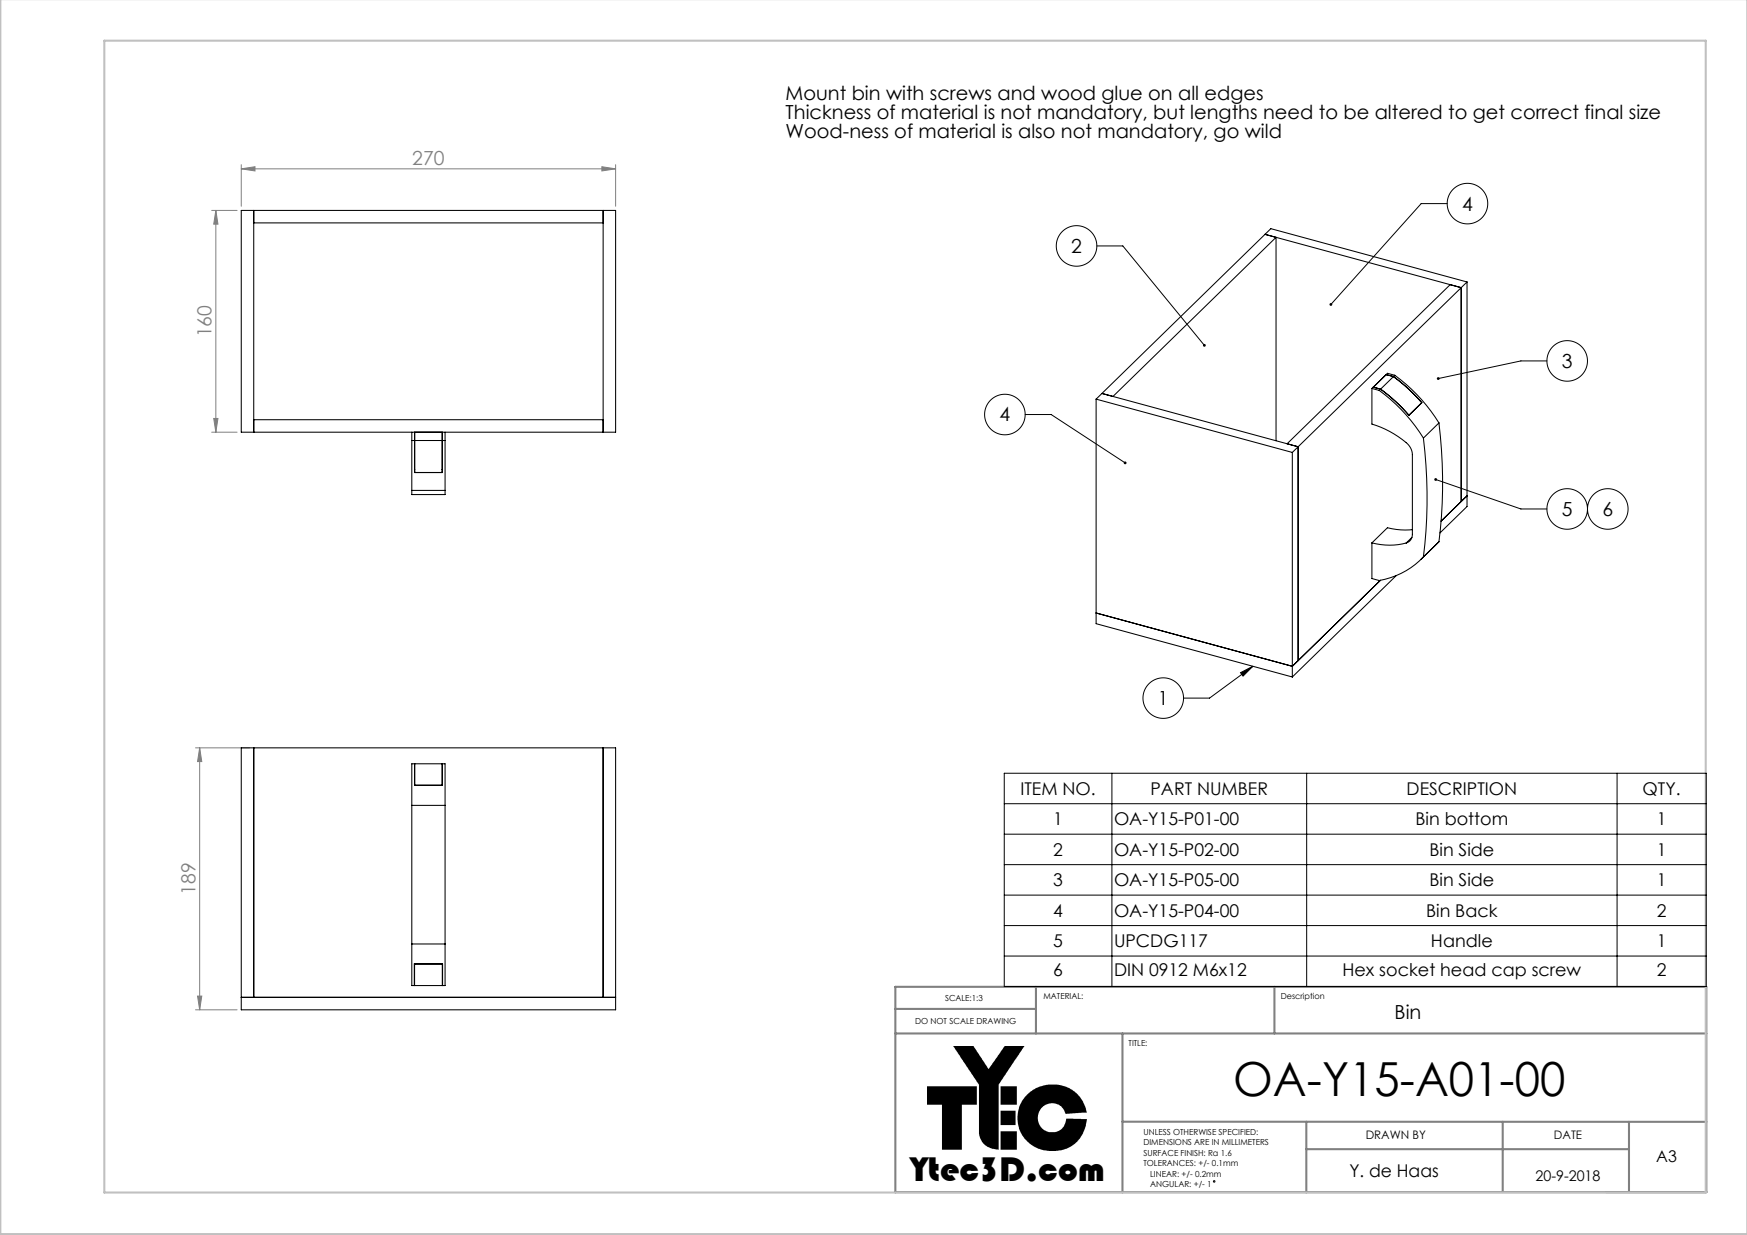
[picture p132: page 1]

Mount bin with screws and wood glue on all edges
Thickness of material is not mandatory, but lengths need to be altered to get correct final size
Wood-ness of material is also not mandatory, go wild

ITEM NO. | PART NUMBER | DESCRIPTION | QTY.
1 | OA-Y15-P01-00 | Bin bottom | 1
2 | OA-Y15-P02-00 | Bin Side | 1
3 | OA-Y15-P05-00 | Bin Side | 1
4 | OA-Y15-P04-00 | Bin Back | 2
5 | UPCDG117 | Handle | 1
6 | DIN 0912 M6x12 | Hex socket head cap screw | 2

SCALE:1:3 | MATERIAL: | Description Bin
Ytec3D.com | TITLE: OA-Y15-A01-00

DO NOT SCALE DRAWING

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

Y. de Haas | 20-9-2018
