MSherbinii/Binder-Jet-3D-Printer/Oasis make package 20181230/Mechanical/OA-Y15 Overshoot bin/OA-Y15-P05-00.PDF

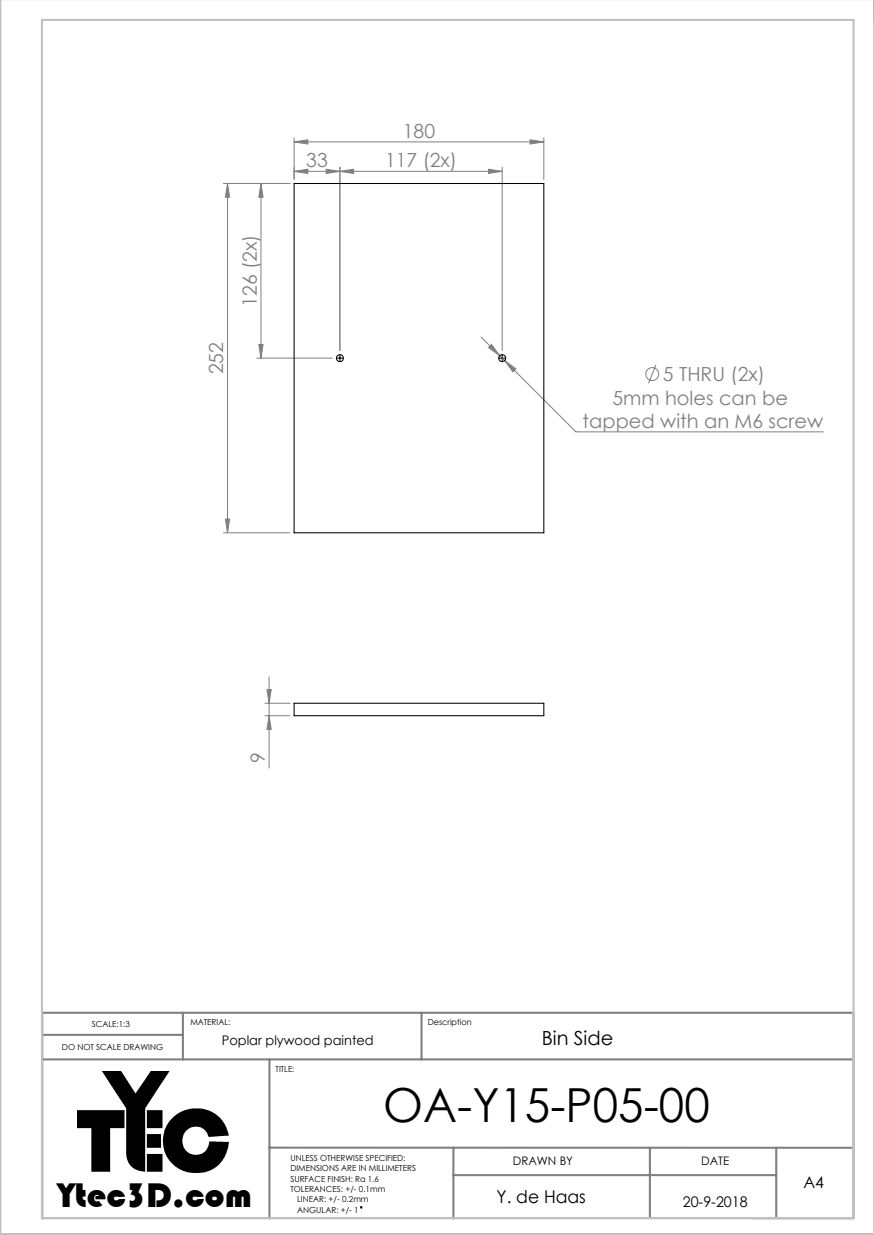
[picture p134: page 1]
Bin Side

5 THRU (2x)
5mm holes can be
tapped with an M6 screw

MATERIAL:
Poplar plywood painted

DO NOT SCALE DRAWING

Ytec3D.com | TITLE: OA-Y15-P05-00

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

Y. de Haas | 20-9-2018
