MSherbinii/Binder-Jet-3D-Printer/Oasis make package 20181230/Mechanical/OA-Y20 Gantry/OA-Y20-A01-02.PDF

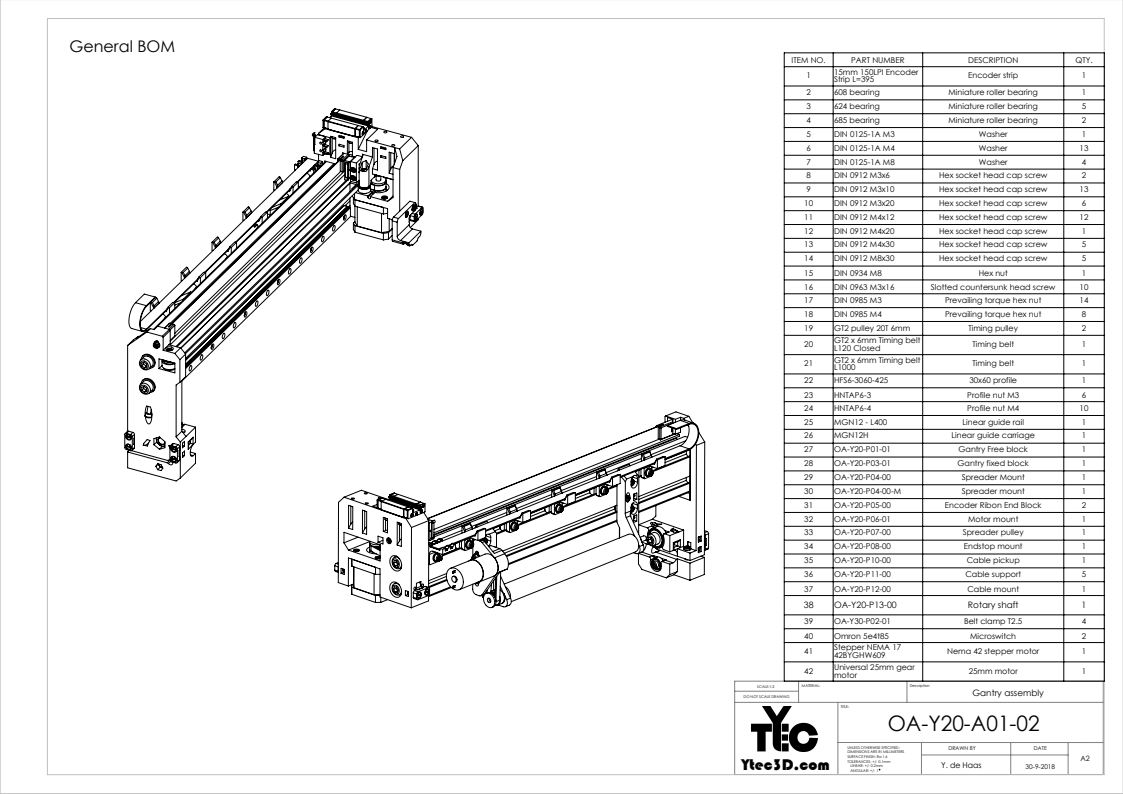
[picture p135: page 1]
General BOM; DIN 0125-1A M4; Washer; DIN 0125-1A M8; DIN 0912 M3x6; Hex socket head cap screw; DIN 0912 M3x10

ITEM NO. | 15mm 150LPI Encoder PART NUMBER | DESCRIPTION | QTY. 1

Strip L=395 | Encoder strip | 1
2 | 608 bearing | Miniature roller bearing | 1
3 | 624 bearing | Miniature roller bearing | 5
4 | 685 bearing | Miniature roller bearing | 2
5 | DIN 0125-1A M3 | Washer | 1

10 | DIN 0912 M3x20 | Hex socket head cap screw | 6
11 | DIN 0912 M4x12 | Hex socket head cap screw | 12
12 | DIN 0912 M4x20 | Hex socket head cap screw | 1
13 | DIN 0912 M4x30 | Hex socket head cap screw | 5
14 | DIN 0912 M8x30 | Hex socket head cap screw | 5
15 | DIN 0934 M8 | Hex nut | 1
16 | DIN 0963 M3x16 | Slotted countersunk head screw | 10
17 | DIN 0985 M3 | Prevailing torque hex nut | 14
18 | DIN 0985 M4 | Prevailing torque hex nut | 8
19 | GT2 pulley 20T 6mm | Timing pulley | 2
20 | GT2 x 6mm Timing belt L120 Closed | Timing belt | 1
21 | GT2 x 6mm Timing belt L1000 | Timing belt | 1
22 | HFS6-3060-425 | 30x60 profile | 1
23 | HNTAP6-3 | Profile nut M3 | 6
24 | HNTAP6-4 | Profile nut M4 | 10
25 | MGN12 - L400 | Linear guide rail | 1
26 | MGN12H | Linear guide carriage | 1
27 | OA-Y20-P01-01 | Gantry Free block | 1
28 | OA-Y20-P03-01 | Gantry fixed block | 1
29 | OA-Y20-P04-00 | Spreader Mount | 1
30 | OA-Y20-P04-00-M | Spreader mount | 1
31 | OA-Y20-P05-00 | Encoder Ribon End Block | 2
32 | OA-Y20-P06-01 | Motor mount | 1
33 | OA-Y20-P07-00 | Spreader pulley | 1
34 | OA-Y20-P08-00 | Endstop mount | 1
35 | OA-Y20-P10-00 | Cable pickup | 1
36 | OA-Y20-P11-00 | Cable support | 5
37 | OA-Y20-P12-00 | Cable mount | 1
38 | OA-Y20-P13-00 | Rotary shaft | 1
39 | OA-Y30-P02-01 | Belt clamp T2.5 | 4
40 | Omron 5e4t85 | Microswitch | 2
41 | Stepper NEMA 17 42BYGHW609 | Nema 42 stepper motor | 1
42 | Universal 25mm gear motor | 25mm motor | 1

SCALE:1:2 | MATERIAL: | Description Gantry assembly
Ytec3D.com | TITLE: OA-Y20-A01-02

DO NOT SCALE DRAWING

DIMENSIONS ARE IN MILLIMETERS SURFACE FINISH: Ra 1.6 TOLERANCES: +/- 0.1mm LINEAR: +/- 0.2mm ANGULAR: +/- 1 | DRAWN BY UNLESS OTHERWISE SPECIFIED: | DATE | A2

Y. de Haas | 30-9-2018

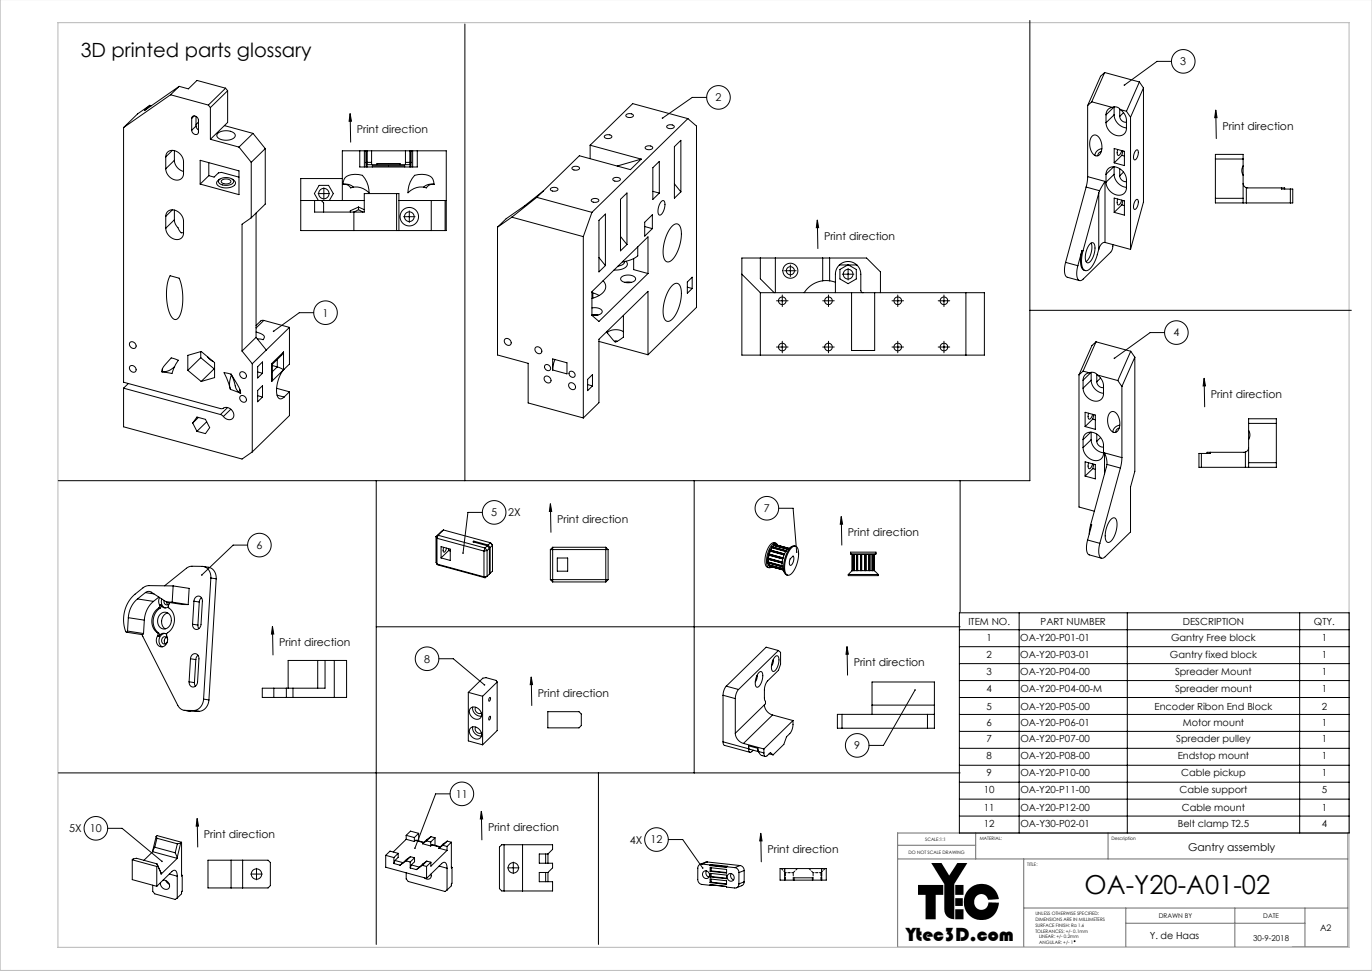
[picture p136: page 2]
Print direction

3D printed parts glossary

Print direction | 5 2X Print direction

ITEM NO. | PART NUMBER | DESCRIPTION | QTY.
1 | OA-Y20-P01-01 | Gantry Free block | 1
2 | OA-Y20-P03-01 | Gantry fixed block | 1
3 | OA-Y20-P04-00 | Spreader Mount | 1
4 | OA-Y20-P04-00-M | Spreader mount | 1
5 | OA-Y20-P05-00 | Encoder Ribon End Block | 2
6 | OA-Y20-P06-01 | Motor mount | 1
7 | OA-Y20-P07-00 | Spreader pulley | 1
8 | OA-Y20-P08-00 | Endstop mount | 1
9 | OA-Y20-P10-00 | Cable pickup | 1
10 | OA-Y20-P11-00 | Cable support | 5
11 | OA-Y20-P12-00 | Cable mount | 1
12 | OA-Y30-P02-01 | Belt clamp T2.5 | 4

8 Print direction | Print direction

SCALE:1:1 | MATERIAL: | Description Gantry assembly

DO NOT SCALE DRAWING

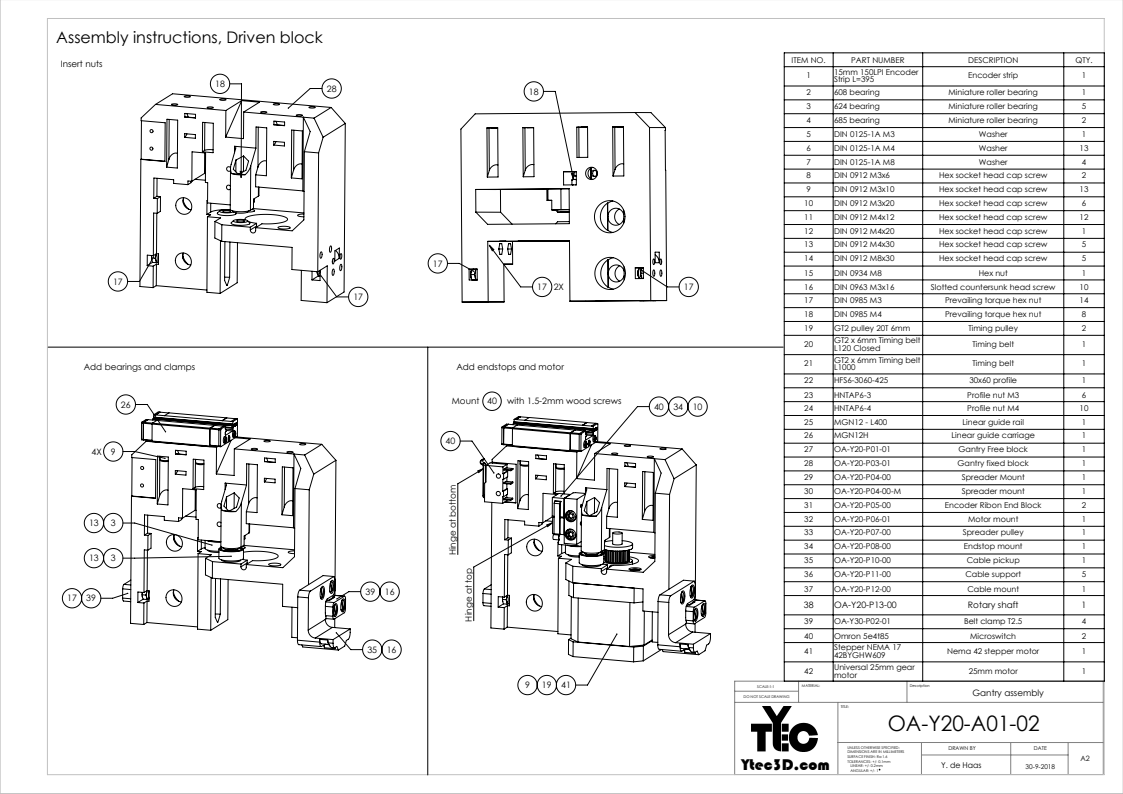
[picture p137: page 3]
Insert nuts; Add bearings and clamps; Add endstops and motor

Assembly instructions, Driven block

ITEM NO. | PART NUMBER | DESCRIPTION | QTY.
1 | 15mm 150LPI Encoder Strip L=395 | Encoder strip | 1
2 | 608 bearing | Miniature roller bearing | 1
3 | 624 bearing | Miniature roller bearing | 5
4 | 685 bearing | Miniature roller bearing | 2
5 | DIN 0125-1A M3 | Washer | 1
6 | DIN 0125-1A M4 | Washer | 13
7 | DIN 0125-1A M8 | Washer | 4
8 | DIN 0912 M3x6 | Hex socket head cap screw | 2
9 | DIN 0912 M3x10 | Hex socket head cap screw | 13
10 | DIN 0912 M3x20 | Hex socket head cap screw | 6
11 | DIN 0912 M4x12 | Hex socket head cap screw | 12
12 | DIN 0912 M4x20 | Hex socket head cap screw | 1
13 | DIN 0912 M4x30 | Hex socket head cap screw | 5
14 | DIN 0912 M8x30 | Hex socket head cap screw | 5
15 | DIN 0934 M8 | Hex nut | 1
16 | DIN 0963 M3x16 | Slotted countersunk head screw | 10
17 | DIN 0985 M3 | Prevailing torque hex nut | 14
18 | DIN 0985 M4 | Prevailing torque hex nut | 8
19 | GT2 pulley 20T 6mm | Timing pulley | 2
20 | GT2 x 6mm Timing belt L120 Closed | Timing belt | 1
21 | GT2 x 6mm Timing belt L1000 | Timing belt | 1
22 | HFS6-3060-425 | 30x60 profile | 1
23 | HNTAP6-3 | Profile nut M3 | 6
24 | HNTAP6-4 | Profile nut M4 | 10
25 | MGN12 - L400 | Linear guide rail | 1
26 | MGN12H | Linear guide carriage | 1
27 | OA-Y20-P01-01 | Gantry Free block | 1
28 | OA-Y20-P03-01 | Gantry fixed block | 1
29 | OA-Y20-P04-00 | Spreader Mount | 1
30 | OA-Y20-P04-00-M | Spreader mount | 1
31 | OA-Y20-P05-00 | Encoder Ribon End Block | 2
32 | OA-Y20-P06-01 | Motor mount | 1
33 | OA-Y20-P07-00 | Spreader pulley | 1
34 | OA-Y20-P08-00 | Endstop mount | 1
35 | OA-Y20-P10-00 | Cable pickup | 1
36 | OA-Y20-P11-00 | Cable support | 5
37 | OA-Y20-P12-00 | Cable mount | 1
38 | OA-Y20-P13-00 | Rotary shaft | 1
39 | OA-Y30-P02-01 | Belt clamp T2.5 | 4
40 | Omron 5e4t85 | Microswitch | 2
41 | Stepper NEMA 17 42BYGHW609 | Nema 42 stepper motor | 1
42 | Universal 25mm gear motor | 25mm motor | 1

Mount 40 with 1.5-2mm wood screws Hinge at bottom Hinge at top

SCALE:1:1 | | MATERIAL: | Description Gantry assembly

DO NOT SCALE DRAWING

TITLE: OA-Y20-A01-02

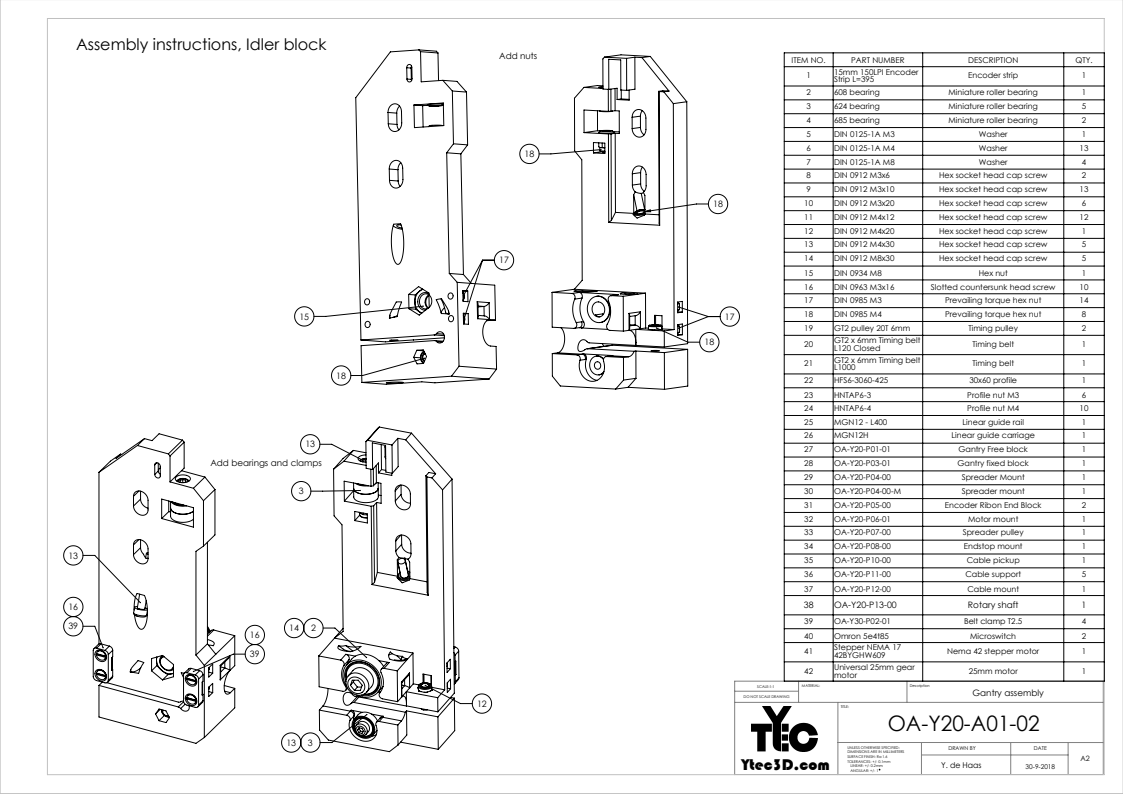
[picture p138: page 4]
Add nuts

Assembly instructions, Idler block

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

Add bearings and clamps

SCALE:1:1 | MATERIAL: | Description Gantry assembly

DO NOT SCALE DRAWING

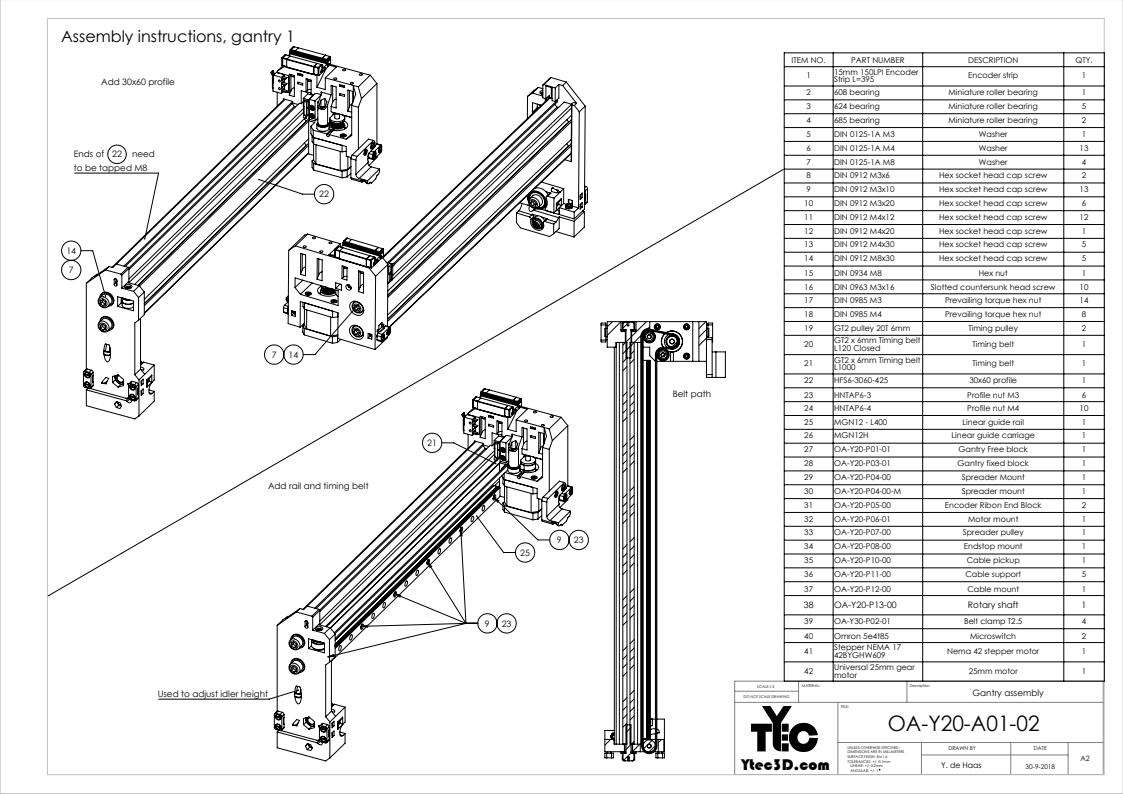
[picture p139: page 5]
Add 30x60 profile; Belt path

Assembly instructions, gantry 1

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

Ends of 22 need
to be tapped M8

Add rail and timing belt

SCALE:1:2 | MATERIAL: | Description Gantry assembly

Used to adjust idler height

DO NOT SCALE DRAWING

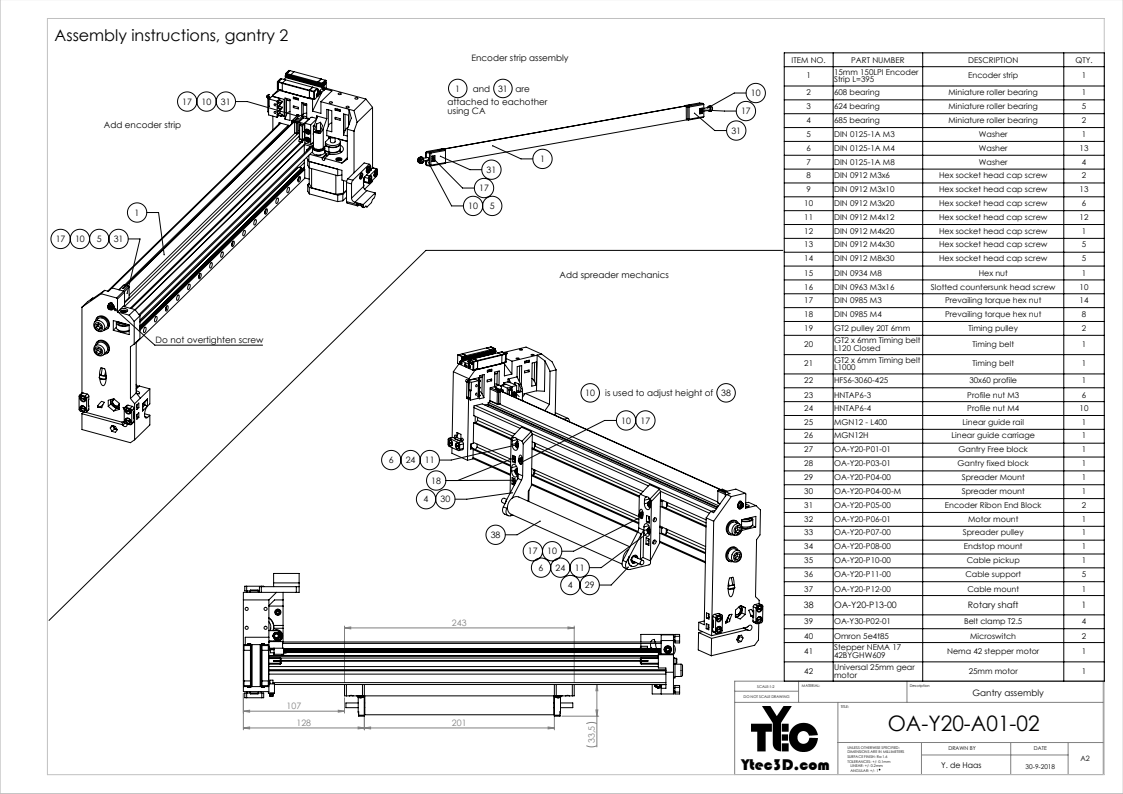
[picture p140: page 6]

Assembly instructions, gantry 2

Encoder strip assembly

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

1 and 31 are
attached to eachother
using CA

Add encoder strip

Add spreader mechanics

Do not overtighten screw

10 is used to adjust height of 38

SCALE:1:2 | MATERIAL: | Description Gantry assembly

DO NOT SCALE DRAWING

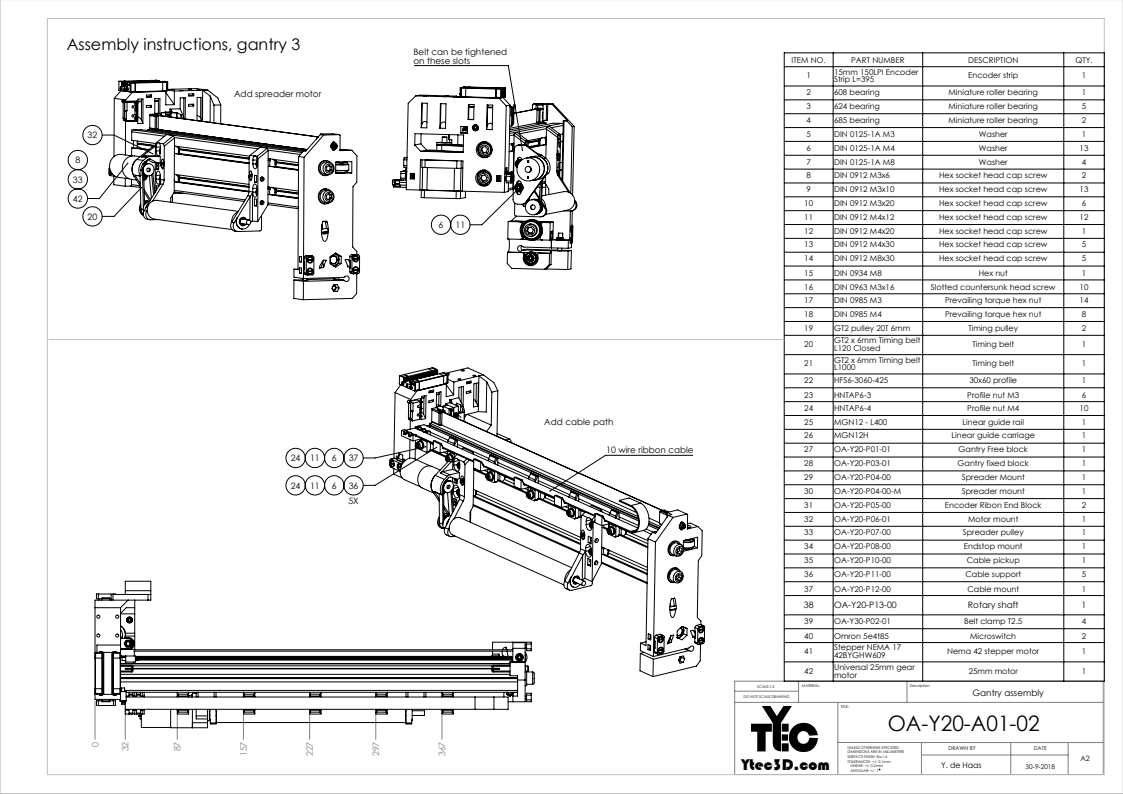
[picture p141: page 7]

Assembly instructions, gantry 3

Belt can be tightened
on these slots

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

Add spreader motor

Add cable path

10 wire ribbon cable

SCALE:1:2 | MATERIAL: | Description Gantry assembly

DO NOT SCALE DRAWING

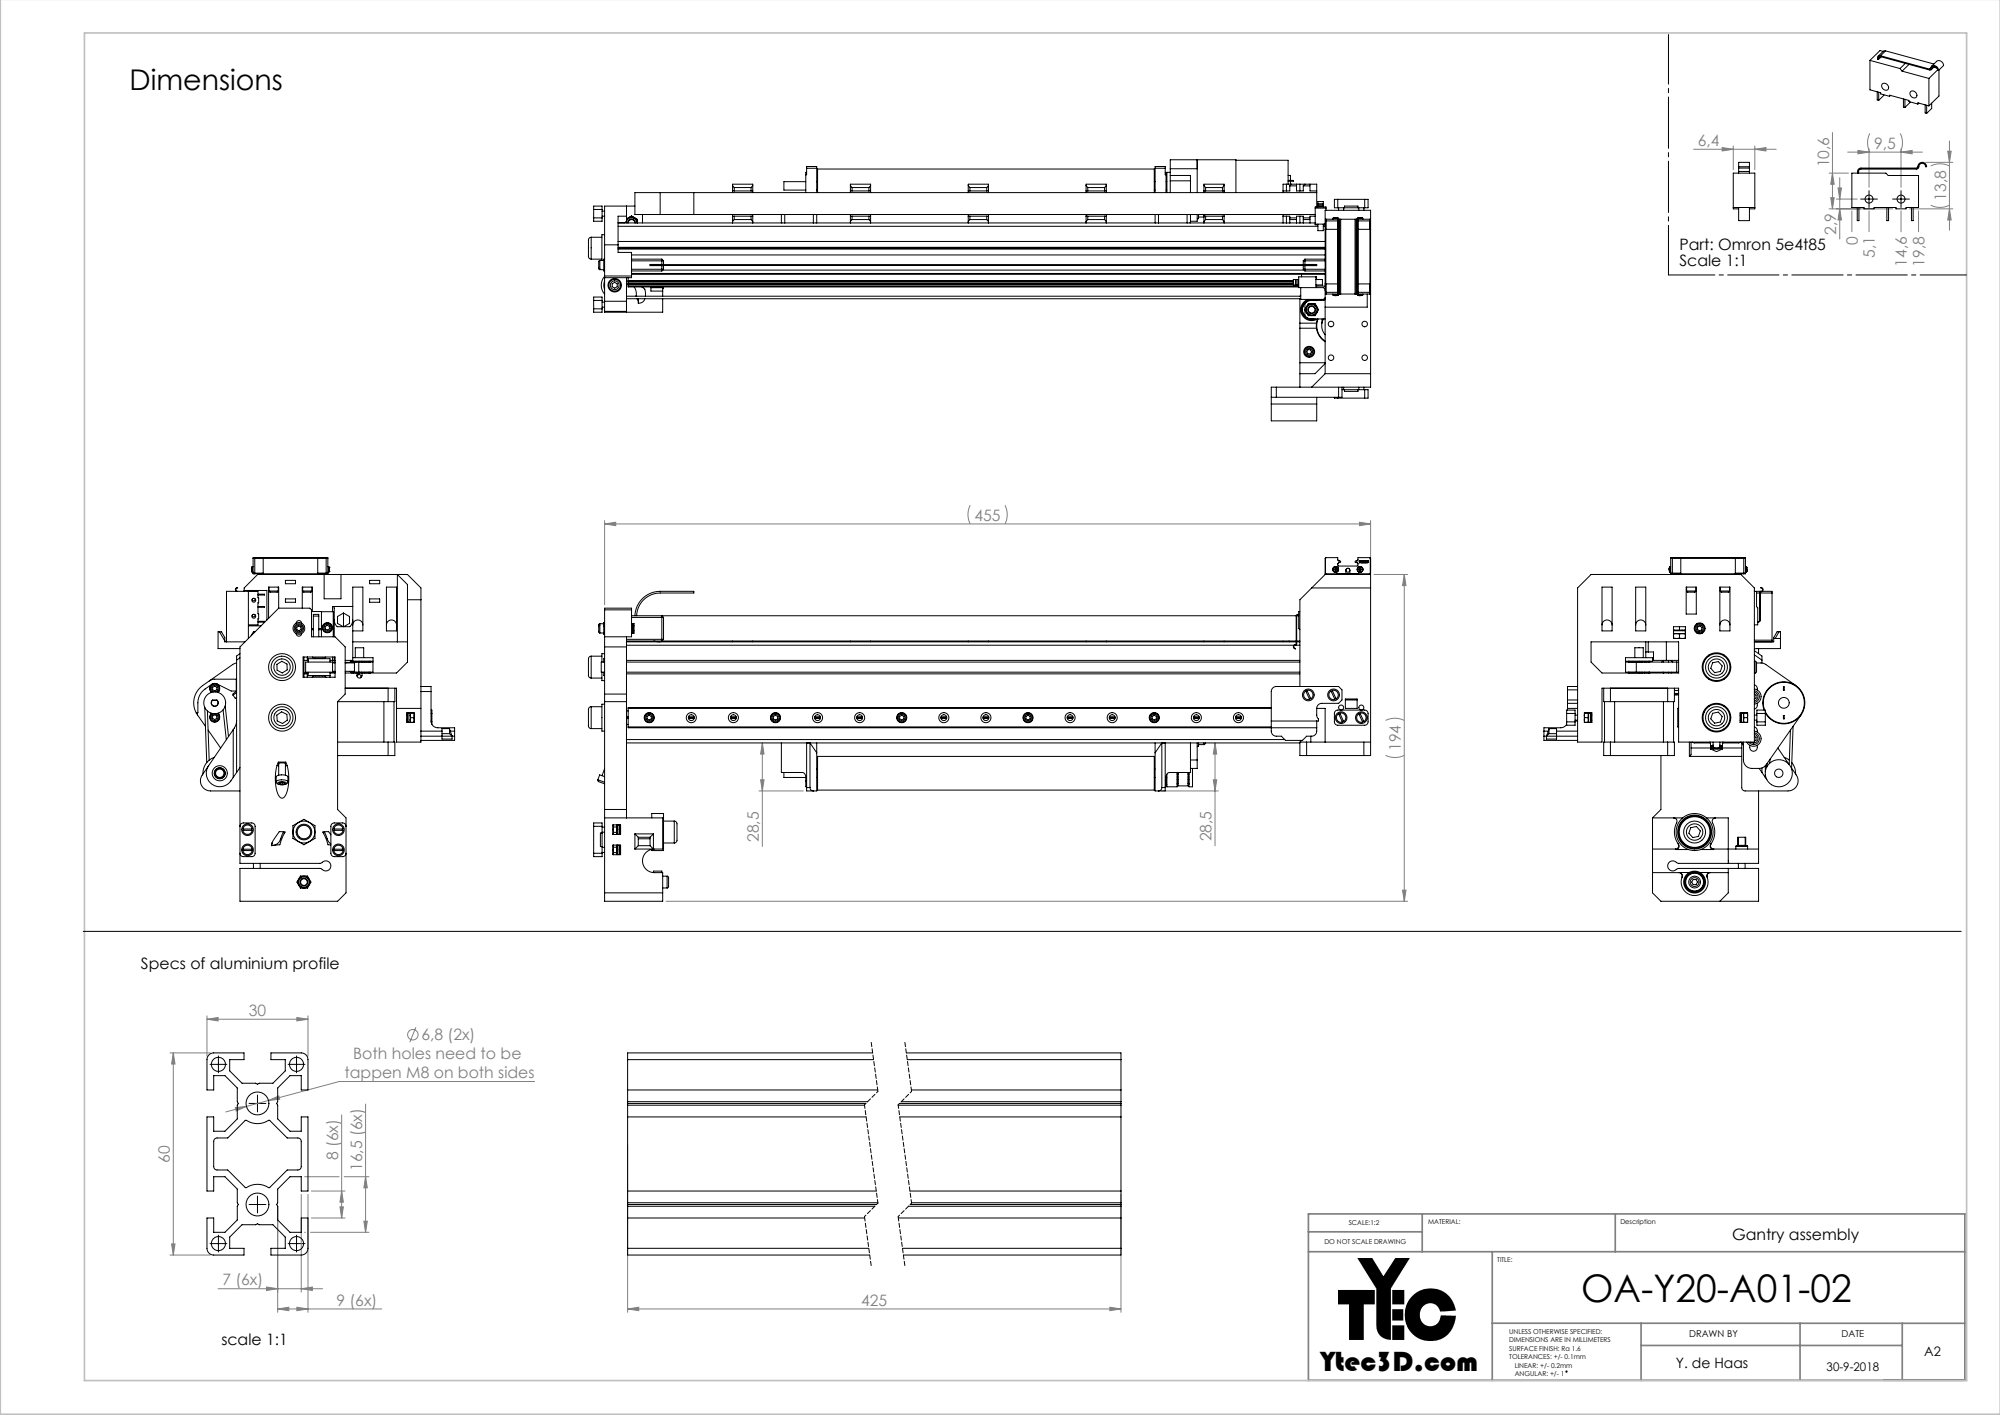
[picture p142: page 8]
Gantry assembly; scale 1:1; Part: Omron 5e4t85 Scale 1:1

Specs of aluminium profile

Both holes need to be
tappen M8 on both sides

DO NOT SCALE DRAWING
