MSherbinii/Binder-Jet-3D-Printer/Oasis make package 20181230/Mechanical/OA-Y20 Gantry/OA-Y20-P13-00.PDF

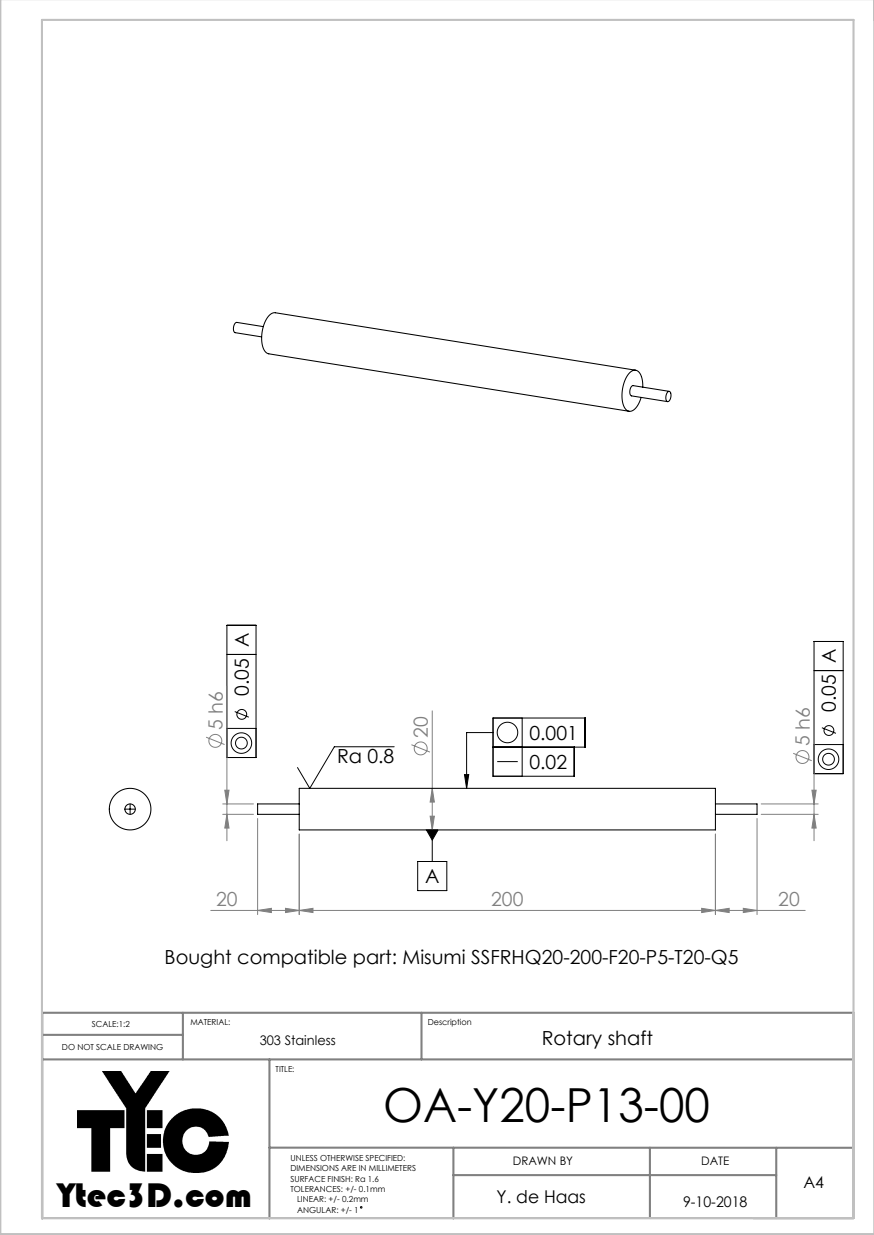
[picture p143: page 1]
303 Stainless; Rotary shaft

Bought compatible part: Misumi SSFRHQ20-200-F20-P5-T20-Q5

DO NOT SCALE DRAWING

Ytec3D.com | TITLE: OA-Y20-P13-00

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

Y. de Haas | 9-10-2018
