MSherbinii/Binder-Jet-3D-Printer/Oasis source files 20181014/Electrical/Oasis wiring diagram V1.00/Oasis wiring diagram 20181010.pdf

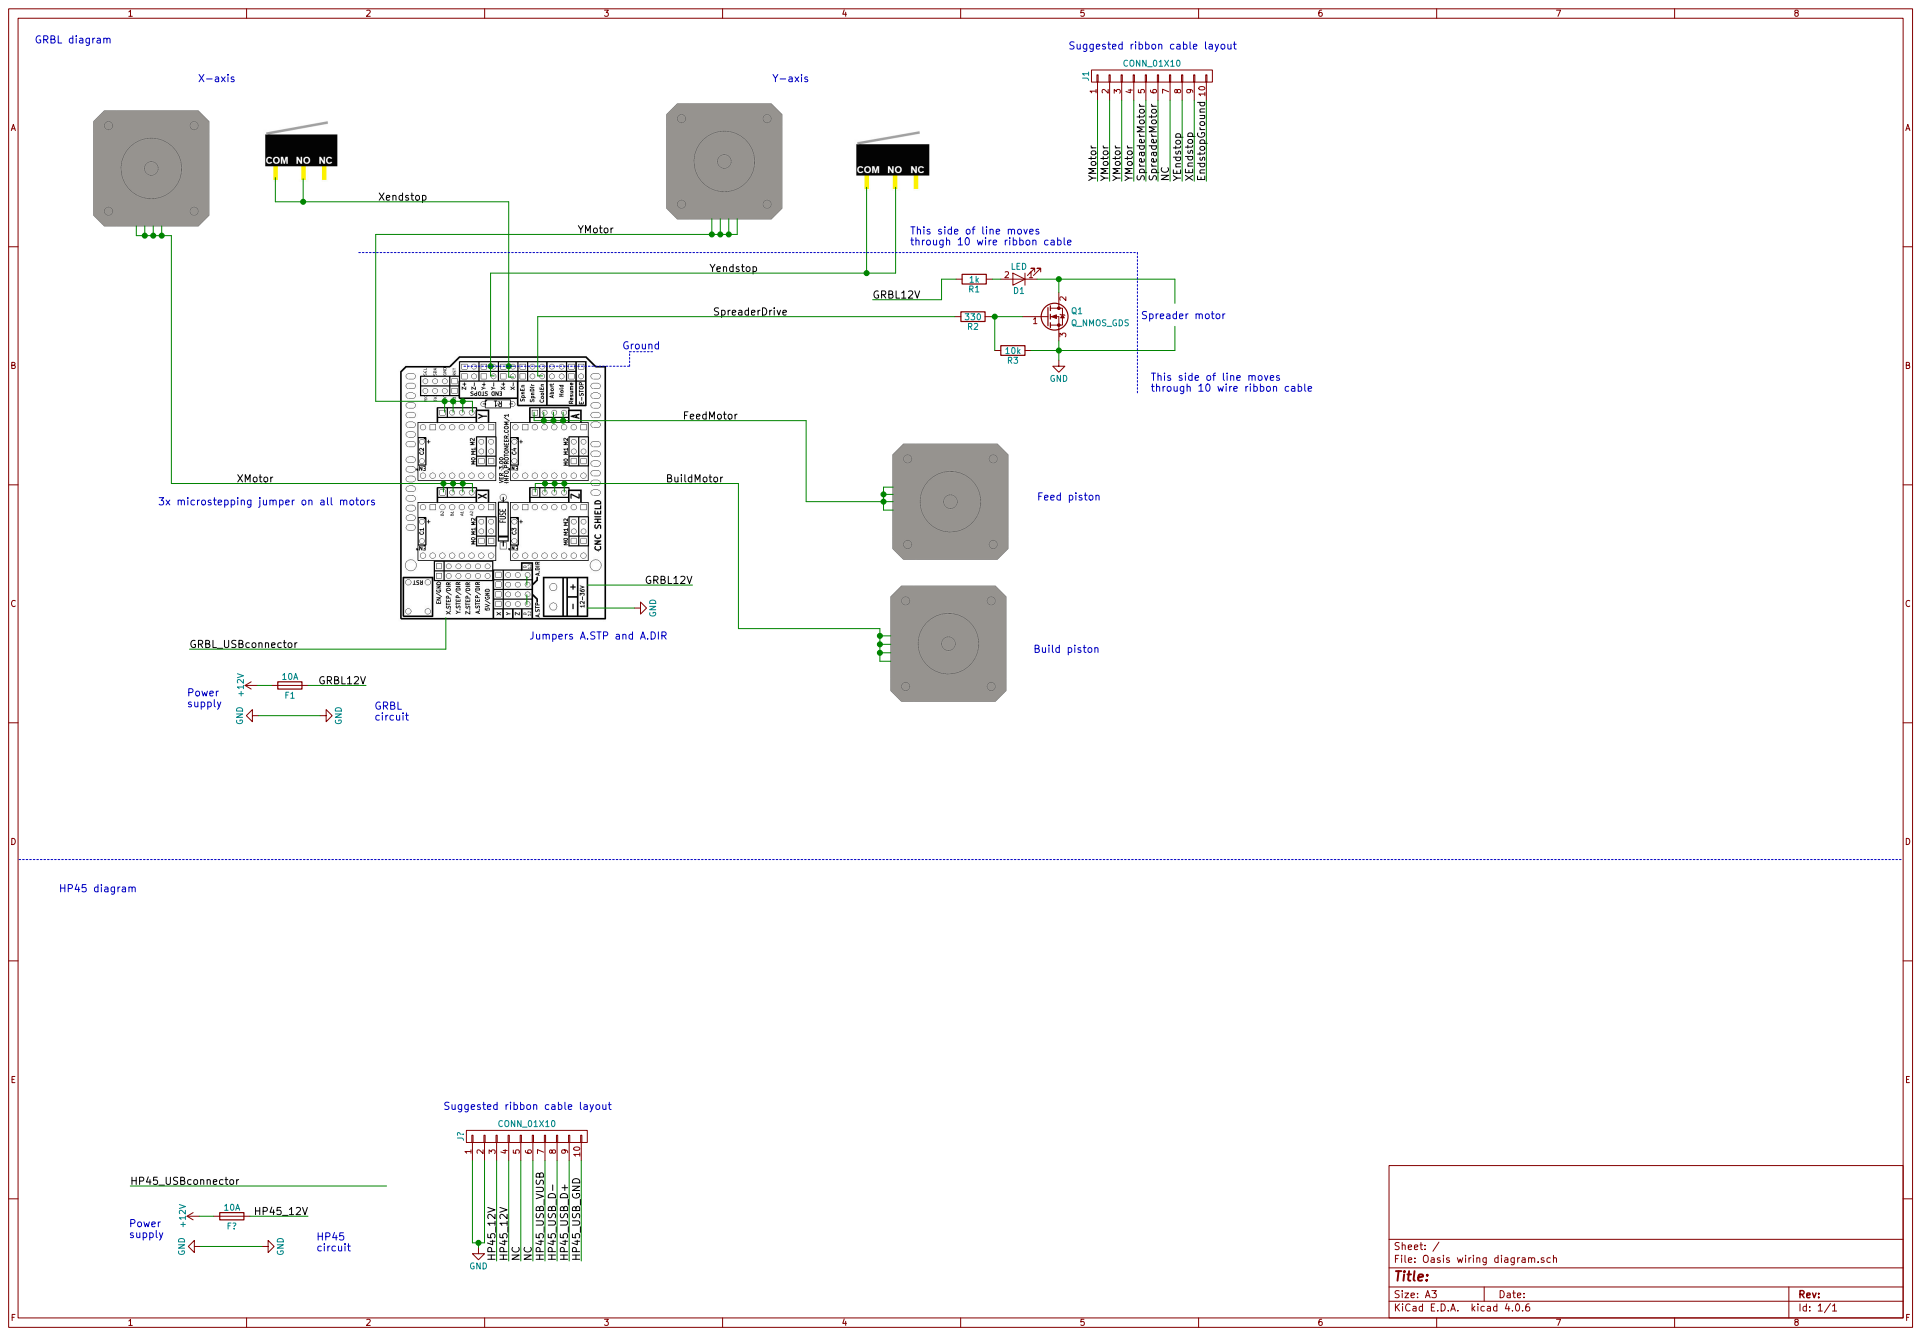
[picture p144: page 1]

Suggested ribbon cable layout

910 J1 CONN_01X10 YMotor YMotor YMotor YMotor SpreaderMotor SpreaderMotor NCYEndstop XEndstop EndstopGround

through 10 wire ribbon cable This side of line moves
through 10 wire ribbon cable

This side of line moves

Jumpers A.STP and A.DIR

Suggested ribbon cable layout HP45_12V

File: Oasis wiring diagram.sch Sheet: /
