MSherbinii/Binder-Jet-3D-Printer/Oasis make package 20181230/Electronics/HP45 standalone controller V3/Driver board V3.02/Schematics/HP45 Standalone V3.02 Driver.pdf

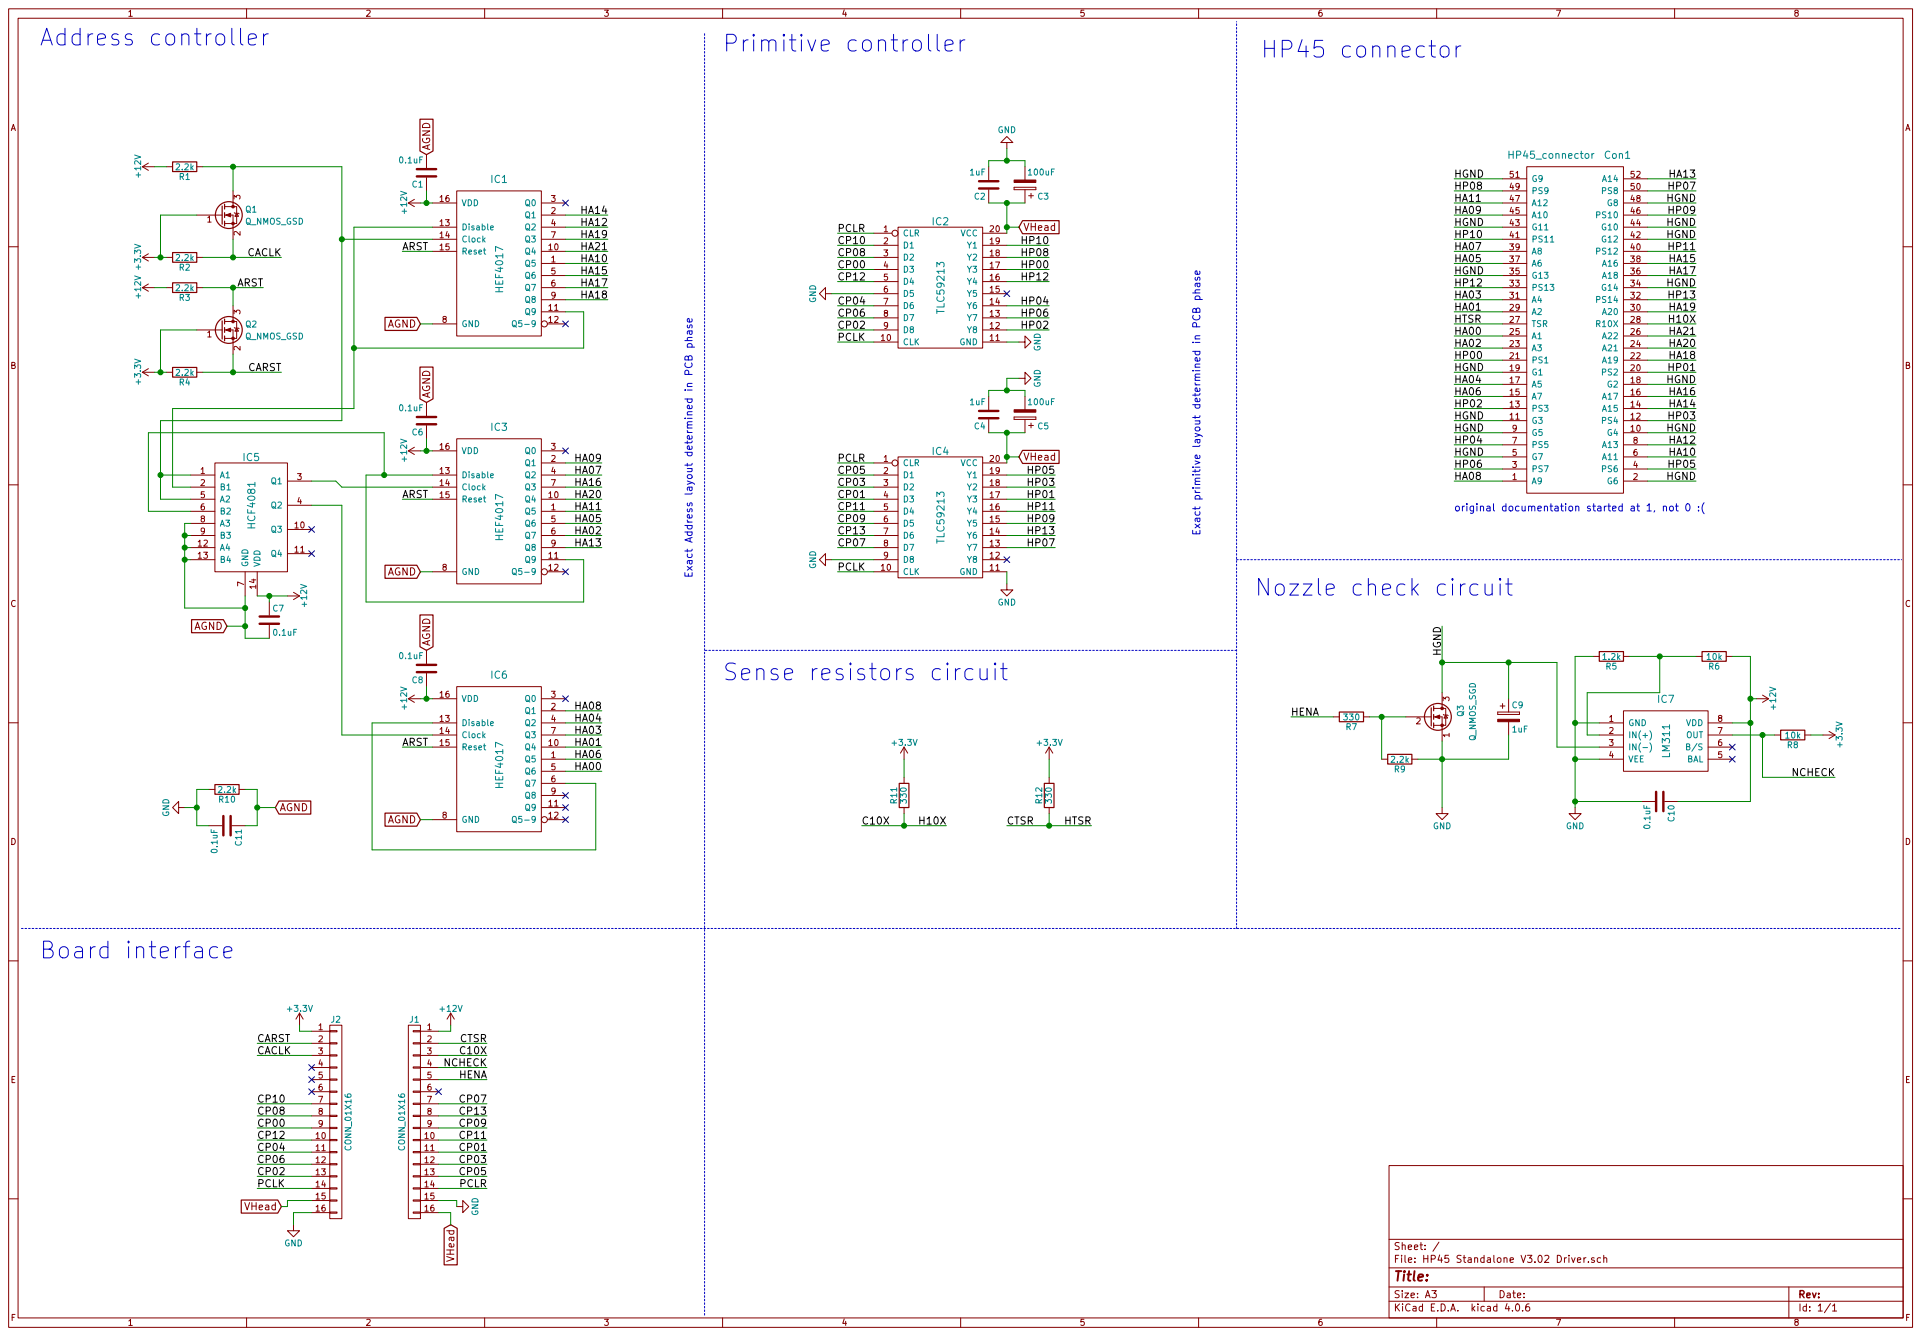
[picture p145: page 1]

Nozzle check circuit VHead VHead GND GND GND

ARST
original documentation started at 1, not 0 :( 123456789

Id: 1/1 Title: File: HP45 Standalone V3.02 Driver.sch Sheet: /
