MSherbinii/Binder-Jet-3D-Printer/Oasis source files 20181014/Electrical/HP45 Standalone V3.00/Controller board V3.01/HP45 Standalone V3.01 Controller.kicad_pcb

## KiCad design Oasis source files 20181014/Electrical/HP45 Standalone V3.00/Controller board V3.01/HP45 Standalone V3.01 Controller.kicad_pcb (2022-12-10)

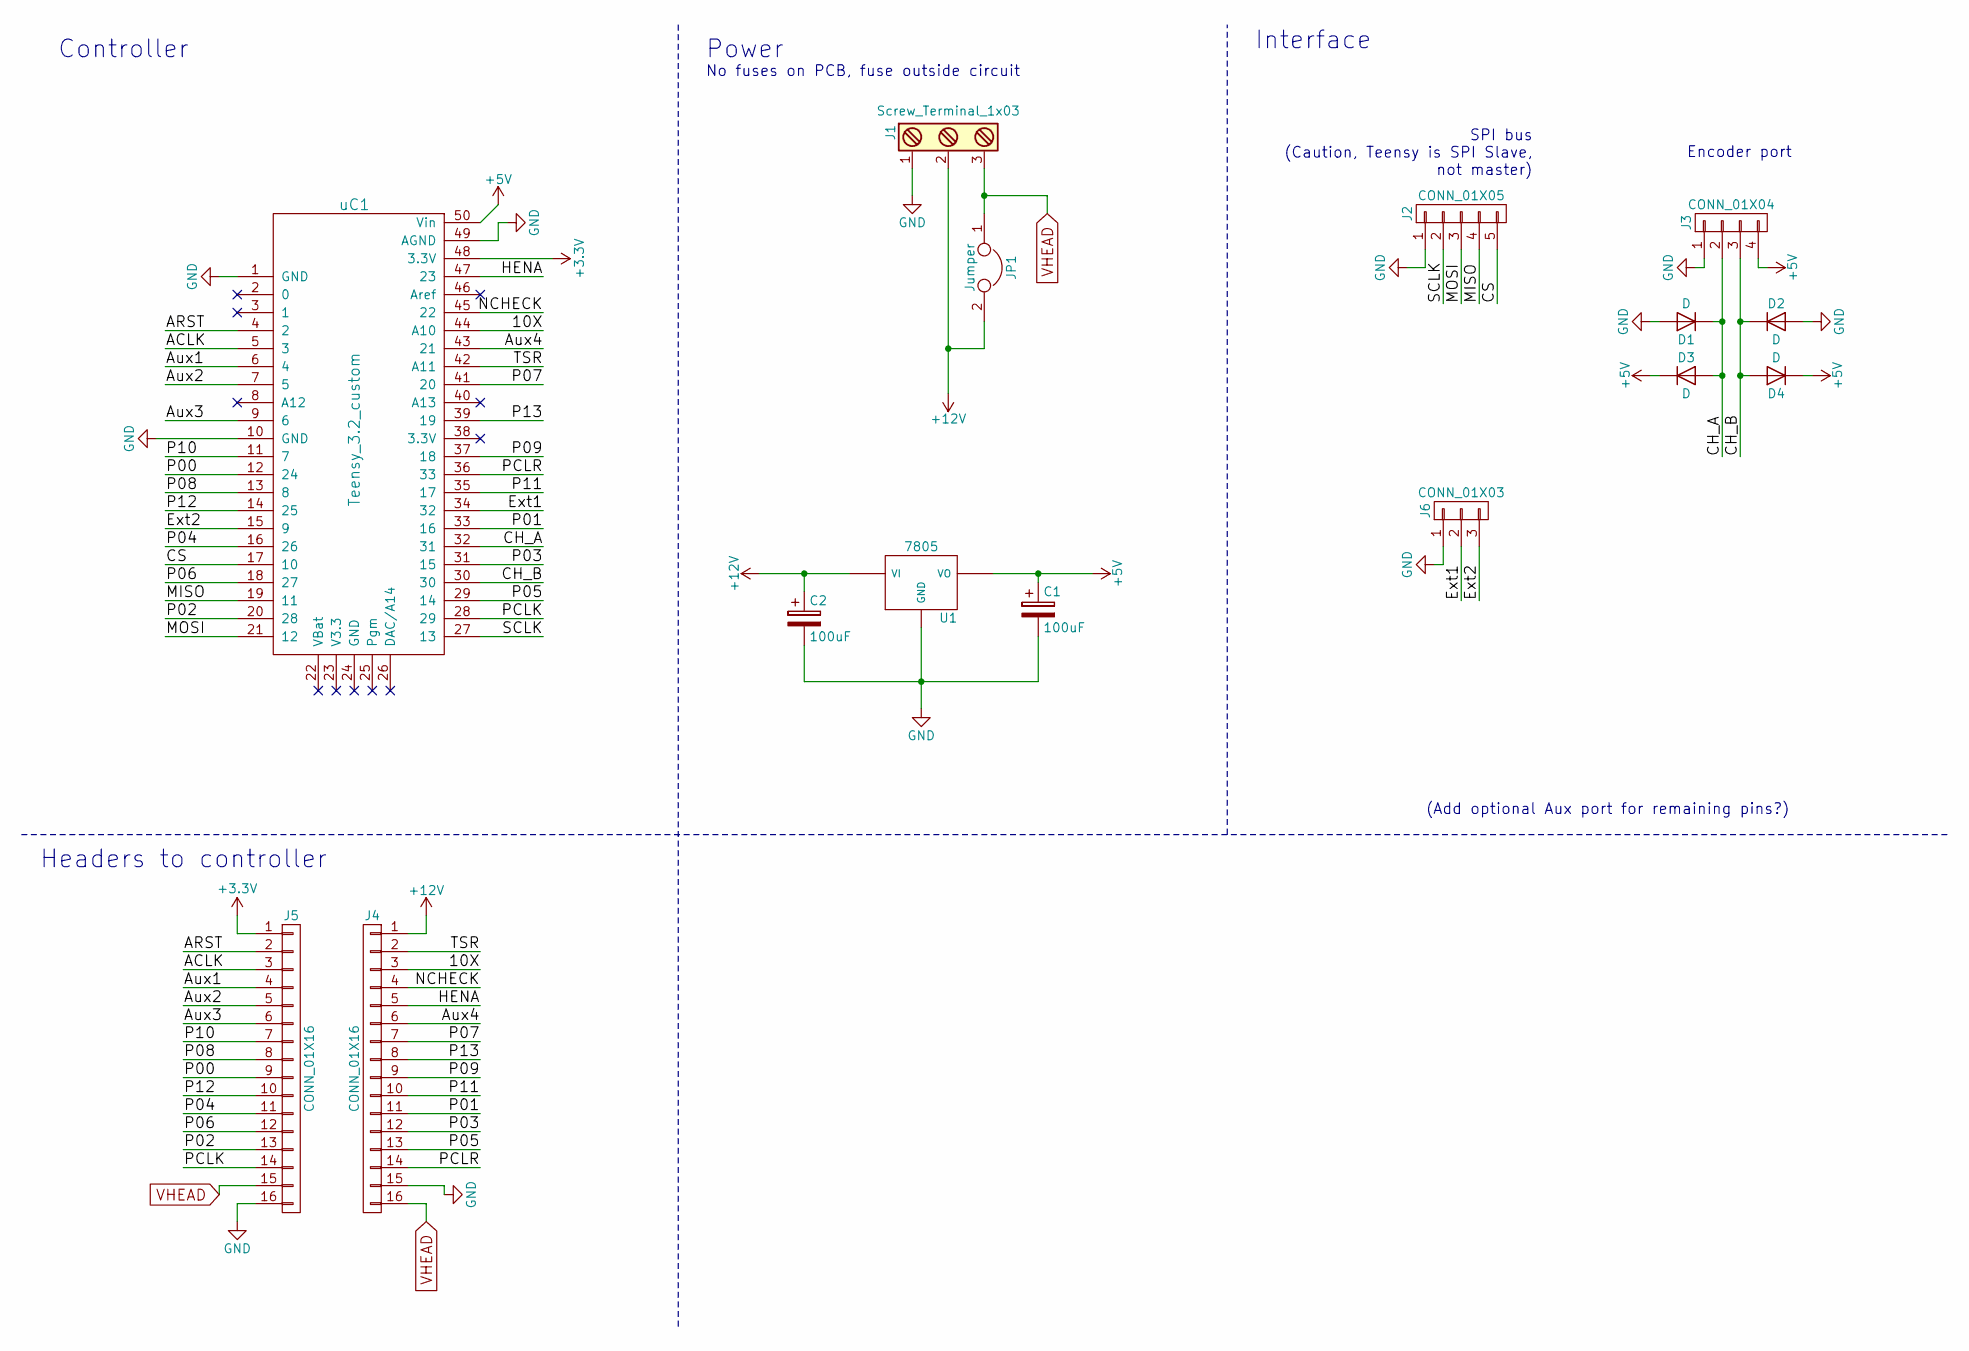
[picture p146: schematic HP45 Standalone V3.01 Controller.sch]

Parts:
C1, C2: 100uF; CP_Elec_8x10
D1, D2, D3, D4: D; D_0603
J1: Screw_Terminal_1x03; 3.5mm_screw_terminal
J2: CONN_01X05; Socket_Strip_Straight_1x05_Pitch2.54mm
J3: CONN_01X04; Socket_Strip_Straight_1x04_Pitch2.54mm
J4, J5: CONN_01X16; Socket_Strip_Straight_1x16_Pitch2.54mm
J6: CONN_01X03; Socket_Strip_Straight_1x03_Pitch2.54mm
JP1: Jumper; GS2
U1: 7805; TO-263-2
uC1: Teensy_3.2_custom

Connections:
+3V3: J5.1, uC1.48 (3.3V)
+5V: C1.1, D3.1 (K), D4.1 (K), J3.4, U1.3 (VO), uC1.50 (Vin)
+12V: C2.1, J1.2, J4.1, JP1.2, U1.1 (VI)
/10X: J4.3, uC1.44 (A10)
/ACLK: J5.3, uC1.5 (3)
/ARST: J5.2, uC1.4 (2)
/Aux1: J5.4, uC1.6 (4)
/Aux2: J5.5, uC1.7 (5)
/Aux3: J5.6, uC1.9 (6)
/Aux4: J4.6, uC1.43 (21)
/CH_A: D1.1 (K), D3.2 (A), J3.2, uC1.32 (31)
/CH_B: D2.1 (K), D4.2 (A), J3.3, uC1.30
/CS: J2.5, uC1.17 (10)
/Ext1: J6.2, uC1.34 (32)
/Ext2: J6.3, uC1.15 (9)
/HENA: J4.5, uC1.47 (23)
/MISO: J2.4, uC1.19 (11)
/MOSI: J2.3, uC1.21 (12)
/NCHECK: J4.4, uC1.45 (22)
/P00: J5.9, uC1.12 (24)
/P01: J4.11, uC1.33 (16)
/P02: J5.13, uC1.20 (28)
/P03: J4.12, uC1.31 (15)
/P04: J5.11, uC1.16 (26)
/P05: J4.13, uC1.29 (14)
/P06: J5.12, uC1.18 (27)
/P07: J4.7, uC1.41 (20)
/P08: J5.8, uC1.13 (8)
/P09: J4.9, uC1.37 (18)
/P10: J5.7, uC1.11 (7)
/P11: J4.10, uC1.35 (17)
/P12: J5.10, uC1.14 (25)
/P13: J4.8, uC1.39 (19)
/PCLK: J5.14, uC1.28 (29)
/PCLR: J4.14, uC1.36 (33)
/SCLK: J2.2, uC1.27 (13)
/TSR: J4.2, uC1.42 (A11)
GND: C1.2, C2.2, D1.2 (A), D2.2 (A), J1.1, J2.1, J3.1, J4.15, J5.16, J6.1, U1.2 (GND), uC1.1 (GND), uC1.10 (GND), uC1.49 (AGND)
VHEAD: J1.3, J4.16, J5.15, JP1.1

Notes on the sheet:
SPI bus (Caution, Teensy is SPI Slave, not master)
Encoder port
(Add optional Aux port for remaining pins?)
No fuses on PCB, fuse outside circuit
Controller
Power
Interface
Headers to controller

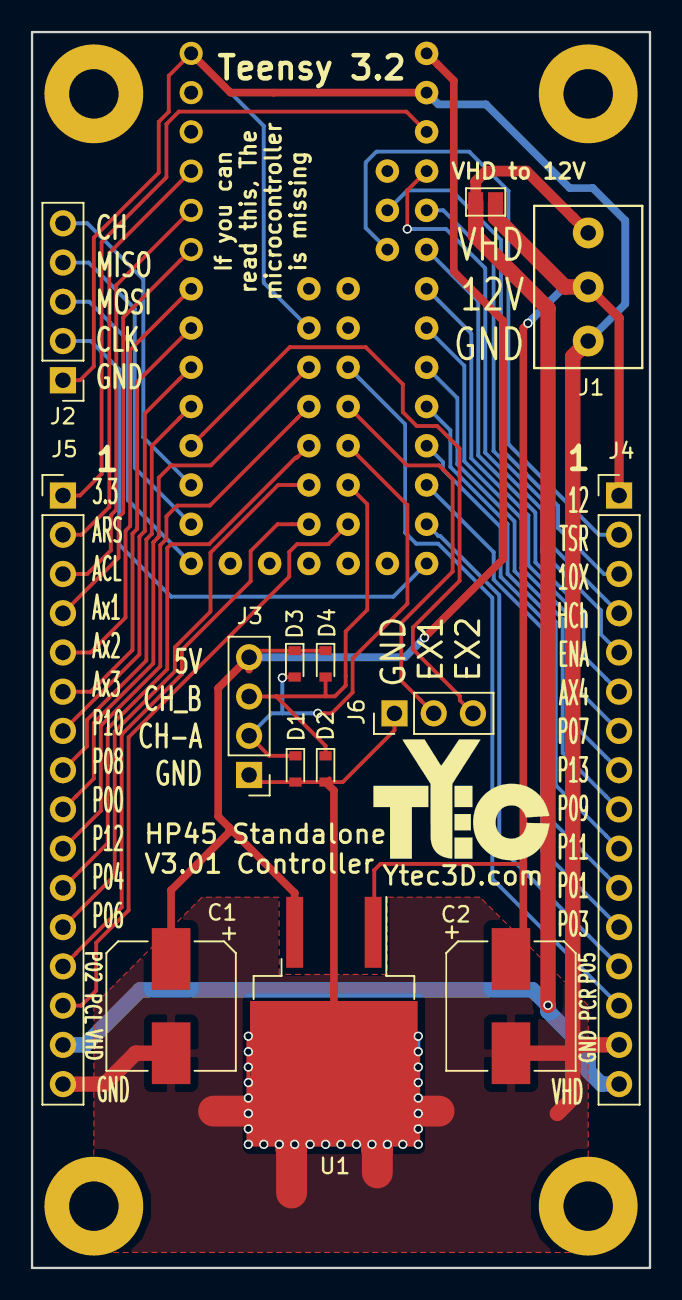
[picture p147: board HP45 Standalone V3.01 Controller.kicad_pcb from above]

Board: 2 copper layers, 40.0 x 80.0 mm, 15 parts (0 on the bottom side), 39 nets.
