MSherbinii/Binder-Jet-3D-Printer/Oasis source files 20181014/Electrical/HP45 Standalone V3.00/Breakout board/HP45 breakout board SA3.kicad_pcb

## KiCad design Oasis source files 20181014/Electrical/HP45 Standalone V3.00/Breakout board/HP45 breakout board SA3.kicad_pcb (2022-12-10)

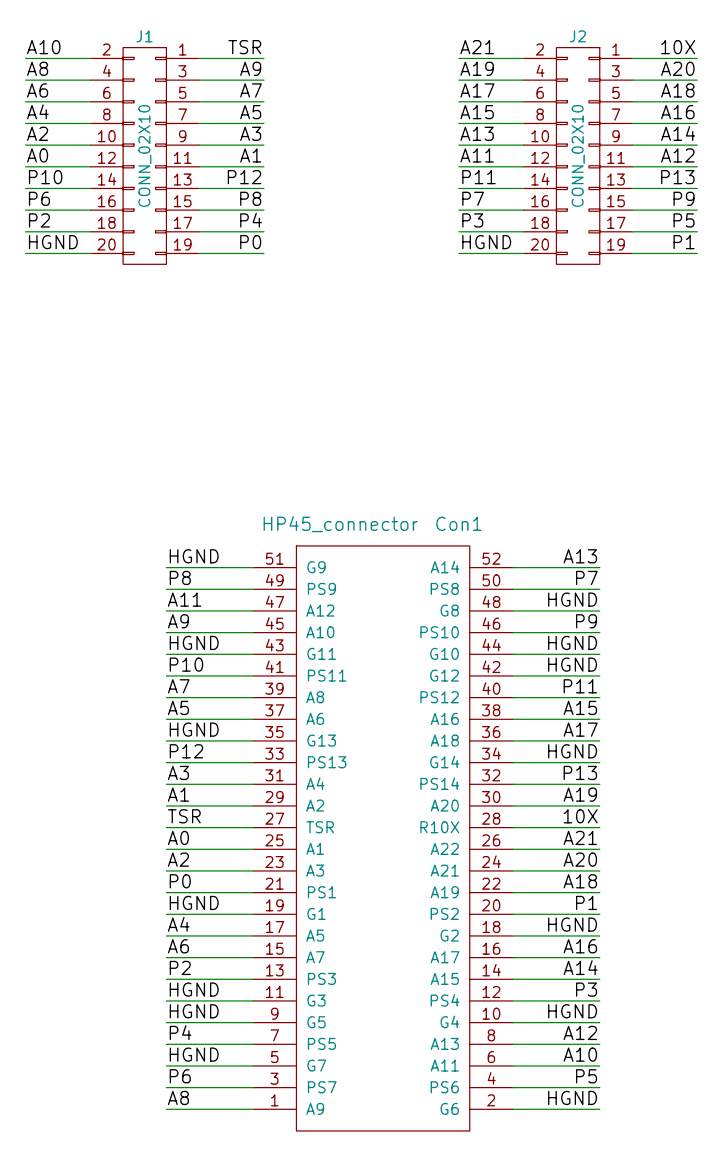
[picture p148: schematic HP45 breakout board SA3.sch]

Parts:
Con1: HP45_connector; HP45_SMD_connector
J1, J2: CONN_02X10; Socket_Strip_Straight_2x10_Pitch2.54mm

Connections:
/10X: Con1.28 (R10X), J2.1
/A0: Con1.25 (A1), J1.12
/A1: Con1.29 (A2), J1.11
/A2: Con1.23 (A3), J1.10
/A3: Con1.31 (A4), J1.9
/A4: Con1.17 (A5), J1.8
/A5: Con1.37 (A6), J1.7
/A6: Con1.15 (A7), J1.6
/A7: Con1.39 (A8), J1.5
/A8: Con1.1 (A9), J1.4
/A9: Con1.45 (A10), J1.3
/A10: Con1.6 (A11), J1.2
/A11: Con1.47 (A12), J2.12
/A12: Con1.8 (A13), J2.11
/A13: Con1.52 (A14), J2.10
/A14: Con1.14 (A15), J2.9
/A15: Con1.38 (A16), J2.8
/A16: Con1.16 (A17), J2.7
/A17: Con1.36 (A18), J2.6
/A18: Con1.22 (A19), J2.5
/A19: Con1.30 (A20), J2.4
/A20: Con1.24 (A21), J2.3
/A21: Con1.26 (A22), J2.2
/HGND: Con1.2 (G6), Con1.5 (G7), Con1.9 (G5), Con1.10 (G4), Con1.11 (G3), Con1.18 (G2), Con1.19 (G1), Con1.34 (G14), Con1.35 (G13), Con1.42 (G12), Con1.43 (G11), Con1.44 (G10), Con1.48 (G8), Con1.51 (G9), J1.20, J2.20
/P0: Con1.21 (PS1), J1.19
/P1: Con1.20 (PS2), J2.19
/P2: Con1.13 (PS3), J1.18
/P3: Con1.12 (PS4), J2.18
/P4: Con1.7 (PS5), J1.17
/P5: Con1.4 (PS6), J2.17
/P6: Con1.3 (PS7), J1.16
/P7: Con1.50 (PS8), J2.16
/P8: Con1.49 (PS9), J1.15
/P9: Con1.46 (PS10), J2.15
/P10: Con1.41 (PS11), J1.14
/P11: Con1.40 (PS12), J2.14
/P12: Con1.33 (PS13), J1.13
/P13: Con1.32 (PS14), J2.13
/TSR: Con1.27 (TSR), J1.1

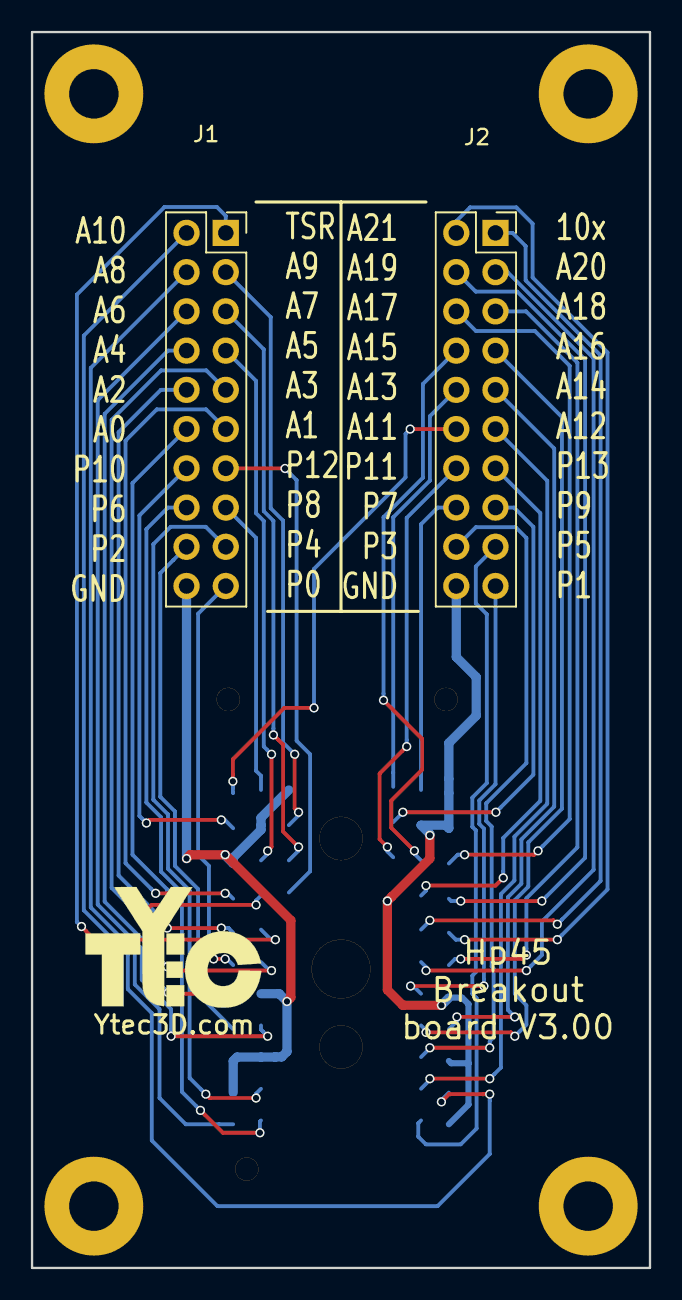
[picture p149: board HP45 breakout board SA3.kicad_pcb from above]

Board: 2 copper layers, 40.0 x 80.0 mm, 3 parts (1 on the bottom side), 39 nets.
