MSherbinii/Binder-Jet-3D-Printer/Oasis source files 20181014/Electrical/HP45 Standalone V3.00/Driver board V3.00/HP45 Standalone V3.00 Driver.kicad_pcb

## KiCad design Oasis source files 20181014/Electrical/HP45 Standalone V3.00/Driver board V3.00/HP45 Standalone V3.00 Driver.kicad_pcb (2022-12-10)

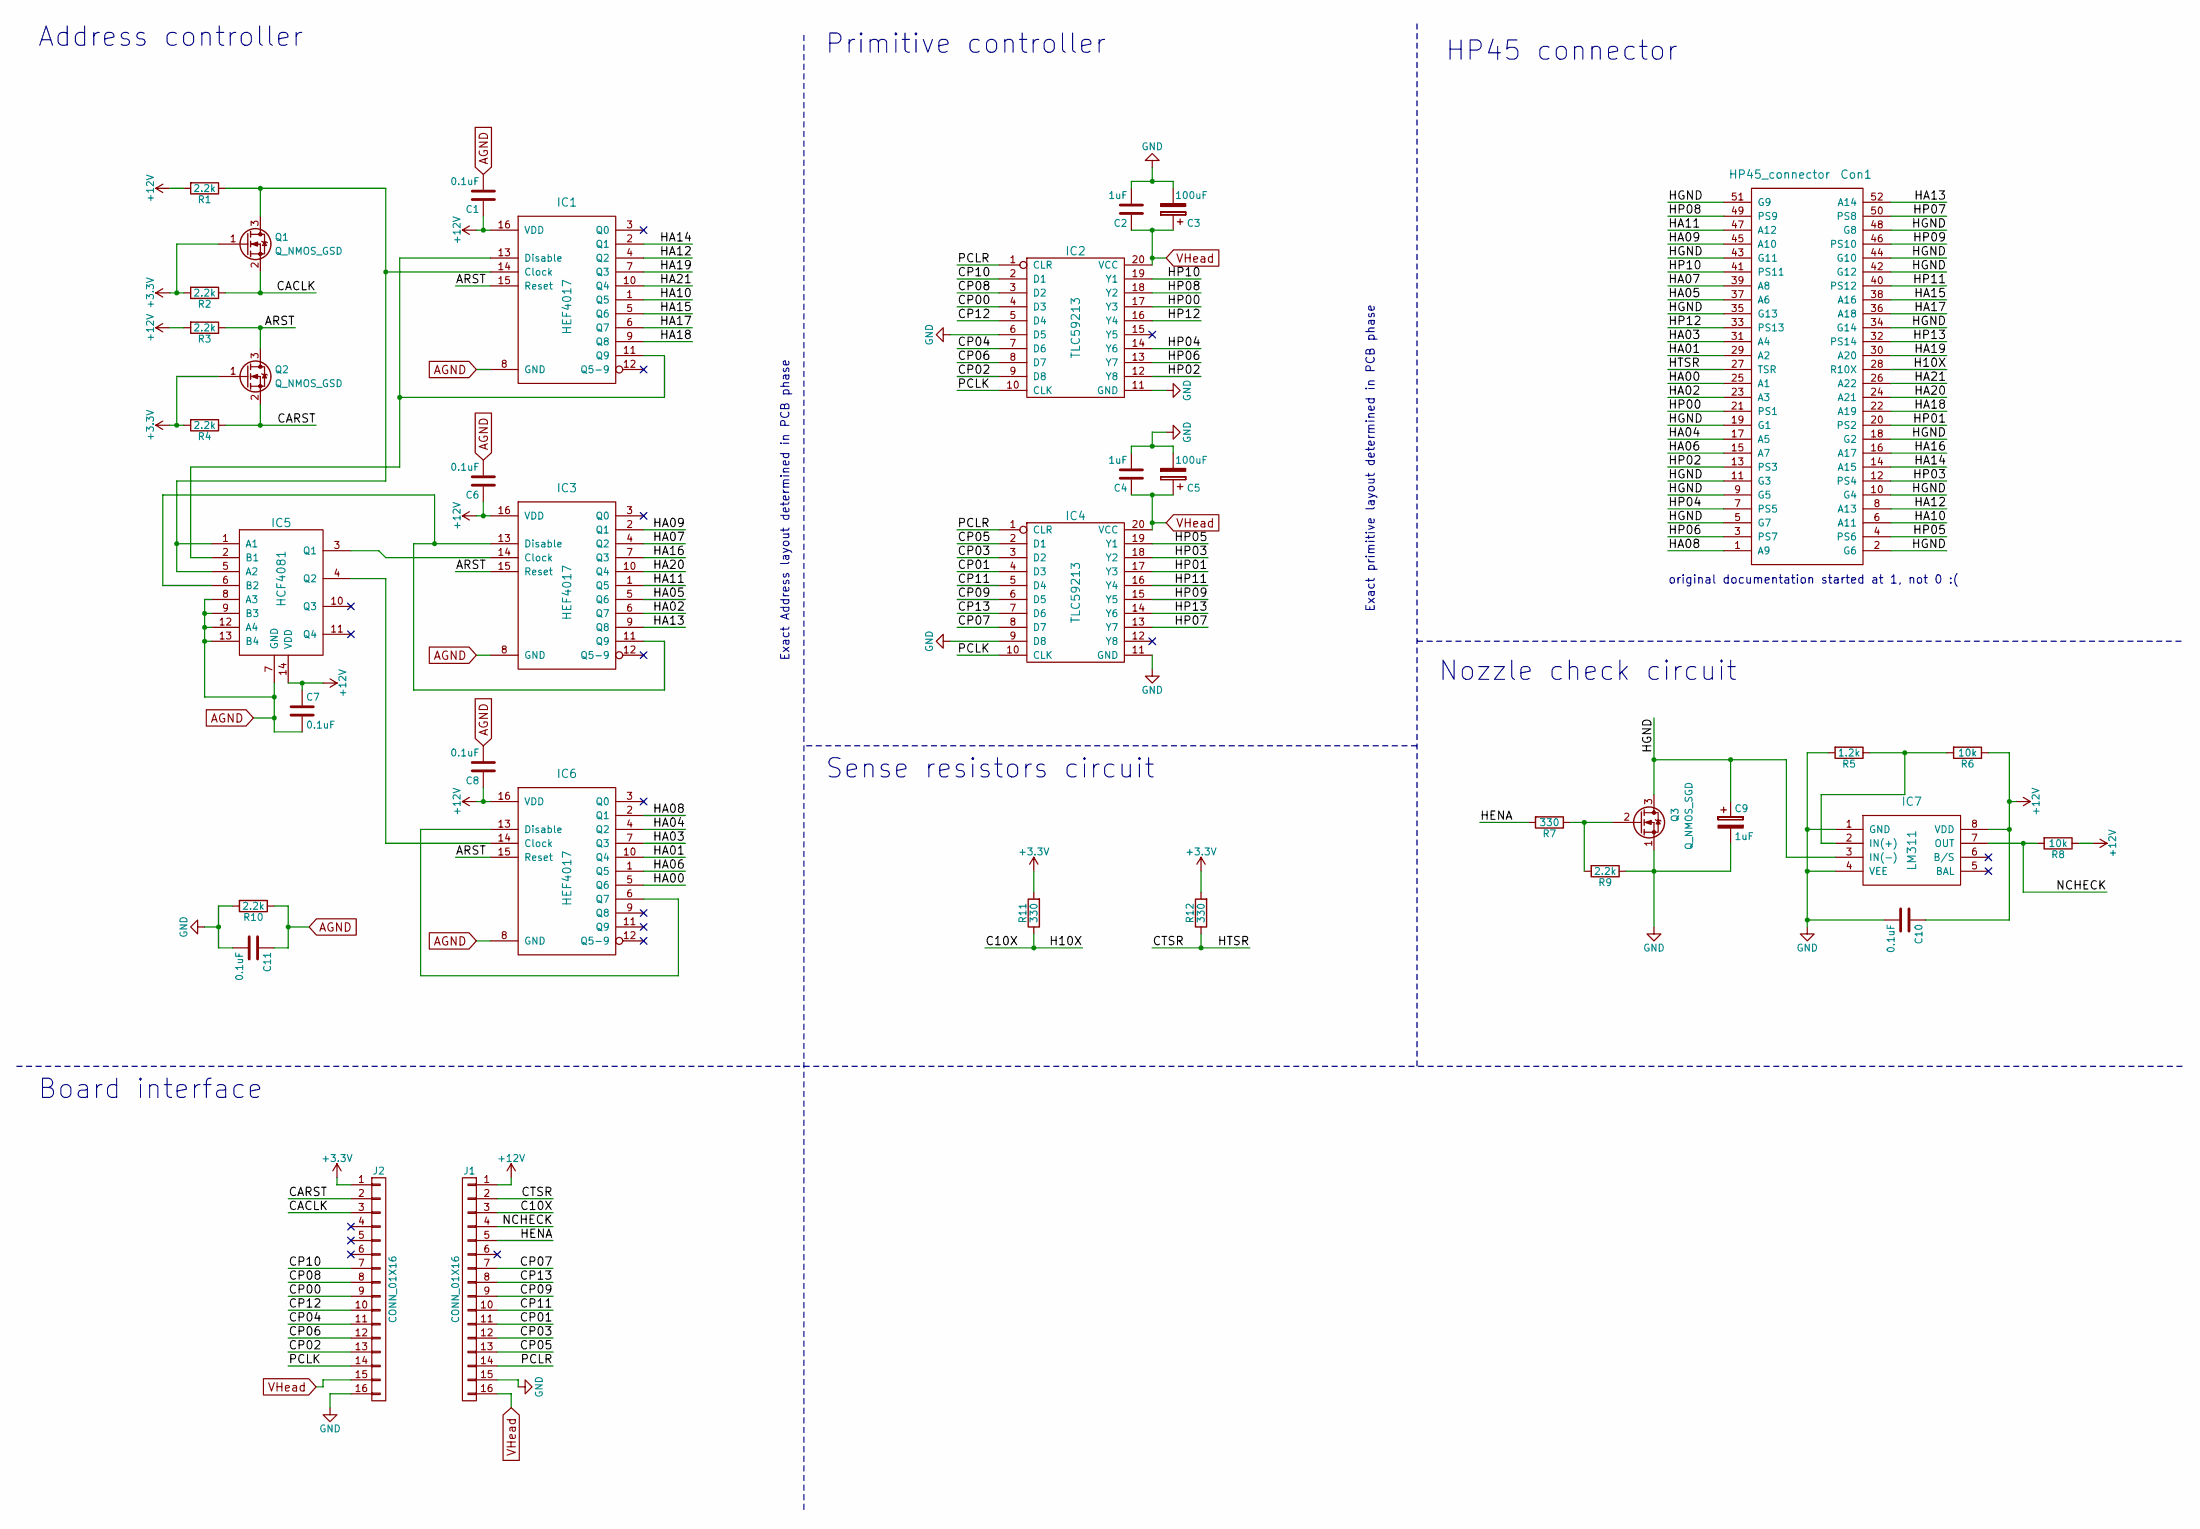
[picture p150: schematic HP45 Standalone V3.00 Driver.sch]

Parts:
C1, C6, C7, C8, C10, C11: 0.1uF; C_0603
C2, C4: 1uF; C_0603
C3, C5: 100uF; CP_Elec_8x10
C9: 1uF; CP_Elec_4x5.8
Con1: HP45_connector; HP45_SMD_connector
IC1, IC3, IC6: HEF4017; SOIC-16_3.9x9.9mm_Pitch1.27mm
IC2, IC4: TLC59213; TSSOP-20_4.4x6.5mm_Pitch0.65mm
IC5: HCF4081; SOIC-14_3.9x8.7mm_Pitch1.27mm
IC7: LM311; SOIC-8_3.9x4.9mm_Pitch1.27mm
J1, J2: CONN_01X16; Socket_Strip_Straight_1x16_Pitch2.54mm
Q1, Q2: Q_NMOS_GSD; SOT-23
Q3: Q_NMOS_SGD; SO-8_PowerPAK
R1, R2, R3, R4, R9, R10: 2.2k; R_0603
R5: 1.2k; R_0603
R6, R8: 10k; R_0603
R7, R11, R12: 330; R_0603

Connections:
+3V3: J2.1, Q1.1 (G), Q2.1 (G), R2.2, R4.2, R11.2, R12.2
+12V: C1.1, C6.1, C7.1, C8.1, C10.1, IC1.16 (VDD), IC3.16 (VDD), IC5.14 (VDD), IC6.16 (VDD), IC7.8 (VDD), J1.1, R1.2, R3.2, R6.1, R8.1
/ARST: IC1.15 (Reset), IC3.15 (Reset), IC6.15 (Reset), Q2.3 (D), R3.1
/C10X: Con1.28 (R10X), J1.3, R11.1
/CACLK: J2.3, Q1.2 (S), R2.1
/CARST: J2.2, Q2.2 (S), R4.1
/CP00: IC2.4 (D3), J2.9
/CP01: IC4.4 (D3), J1.11
/CP02: IC2.9 (D8), J2.13
/CP03: IC4.3 (D2), J1.12
/CP04: IC2.7 (D6), J2.11
/CP05: IC4.2 (D1), J1.13
/CP06: IC2.8 (D7), J2.12
/CP07: IC4.8 (D7), J1.7
/CP08: IC2.3 (D2), J2.8
/CP09: IC4.6 (D5), J1.9
/CP10: IC2.2 (D1), J2.7
/CP11: IC4.5 (D4), J1.10
/CP12: IC2.5 (D4), J2.10
/CP13: IC4.7 (D6), J1.8
/CTSR: Con1.27 (TSR), J1.2, R12.1
/HA00: Con1.25 (A1), IC6.5 (Q6)
/HA01: Con1.29 (A2), IC6.10 (Q4)
/HA02: Con1.23 (A3), IC3.6 (Q7)
/HA03: Con1.31 (A4), IC6.7 (Q3)
/HA04: Con1.17 (A5), IC6.4 (Q2)
/HA05: Con1.37 (A6), IC3.5 (Q6)
/HA06: Con1.15 (A7), IC6.1 (Q5)
/HA07: Con1.39 (A8), IC3.4 (Q2)
/HA08: Con1.1 (A9), IC6.2 (Q1)
/HA09: Con1.45 (A10), IC3.2 (Q1)
/HA10: Con1.6 (A11), IC1.1 (Q5)
/HA11: Con1.47 (A12), IC3.1 (Q5)
/HA12: Con1.8 (A13), IC1.4 (Q2)
/HA13: Con1.52 (A14), IC3.9 (Q8)
/HA14: Con1.14 (A15), IC1.2 (Q1)
/HA15: Con1.38 (A16), IC1.5 (Q6)
/HA16: Con1.16 (A17), IC3.7 (Q3)
/HA17: Con1.36 (A18), IC1.6 (Q7)
/HA18: Con1.22 (A19), IC1.9 (Q8)
/HA19: Con1.30 (A20), IC1.7 (Q3)
/HA20: Con1.24 (A21), IC3.10 (Q4)
/HA21: Con1.26 (A22), IC1.10 (Q4)
/HENA: J1.5, R7.2
/HGND: C9.1, Con1.2 (G6), Con1.5 (G7), Con1.9 (G5), Con1.10 (G4), Con1.11 (G3), Con1.18 (G2), Con1.19 (G1), Con1.34 (G14), Con1.35 (G13), Con1.42 (G12), Con1.43 (G11), Con1.44 (G10), Con1.48 (G8), Con1.51 (G9), IC7.3 (IN(-)), Q3.3 (D)
/HP00: Con1.21 (PS1), IC2.17 (Y3)
/HP01: Con1.20 (PS2), IC4.17 (Y3)
/HP02: Con1.13 (PS3), IC2.12 (Y8)
/HP03: Con1.12 (PS4), IC4.18 (Y2)
/HP04: Con1.7 (PS5), IC2.14 (Y6)
/HP05: Con1.4 (PS6), IC4.19 (Y1)
/HP06: Con1.3 (PS7), IC2.13 (Y7)
/HP07: Con1.50 (PS8), IC4.13 (Y7)
/HP08: Con1.49 (PS9), IC2.18 (Y2)
/HP09: Con1.46 (PS10), IC4.15 (Y5)
/HP10: Con1.41 (PS11), IC2.19 (Y1)
/HP11: Con1.40 (PS12), IC4.16 (Y4)
/HP12: Con1.33 (PS13), IC2.16 (Y4)
/HP13: Con1.32 (PS14), IC4.14 (Y6)
/NCHECK: IC7.7 (OUT), J1.4, R8.2
/PCLK: IC2.10 (CLK), IC4.10 (CLK), J2.14
/PCLR: IC2.1 (CLR), IC4.1 (CLR), J1.14
AGND: C1.2, C6.2, C7.2, C8.2, C11.1, IC1.8 (GND), IC3.8 (GND), IC5.7 (GND), IC5.8 (A3), IC5.9 (B3), IC5.12 (A4), IC5.13 (B4), IC6.8 (GND), R10.1
GND: C2.2, C3.2, C4.2, C5.2, C9.2, C10.2, C11.2, IC2.6 (D5), IC2.11 (GND), IC4.9 (D8), IC4.11 (GND), IC7.1 (GND), IC7.4 (VEE), J1.15, J2.16, Q3.1 (S), R5.2, R9.1, R10.2
unnamed: IC1.11 (Q9), IC1.13 (Disable), IC5.2 (B1)
unnamed: IC1.14 (Clock), IC5.1 (A1), IC5.5 (A2), Q1.3 (D), R1.1
unnamed: IC3.11 (Q9), IC3.13 (Disable), IC5.6 (B2)
unnamed: IC3.14 (Clock), IC5.3 (Q1)
unnamed: IC5.4 (Q2), IC6.14 (Clock)
unnamed: IC6.6 (Q7), IC6.13 (Disable)
unnamed: IC7.2 (IN(+)), R5.1, R6.2
unnamed: Q3.2 (G), R7.1, R9.2
VHead: C2.1, C3.1, C4.1, C5.1, IC2.20 (VCC), IC4.20 (VCC), J1.16, J2.15

Notes on the sheet:
Board interface
Address controller
Primitive controller
HP45 connector
Nozzle check circuit
Exact primitive layout determined in PCB phase
Exact Address layout determined in PCB phase
Sense resistors circuit
original documentation started at 1, not 0 :(

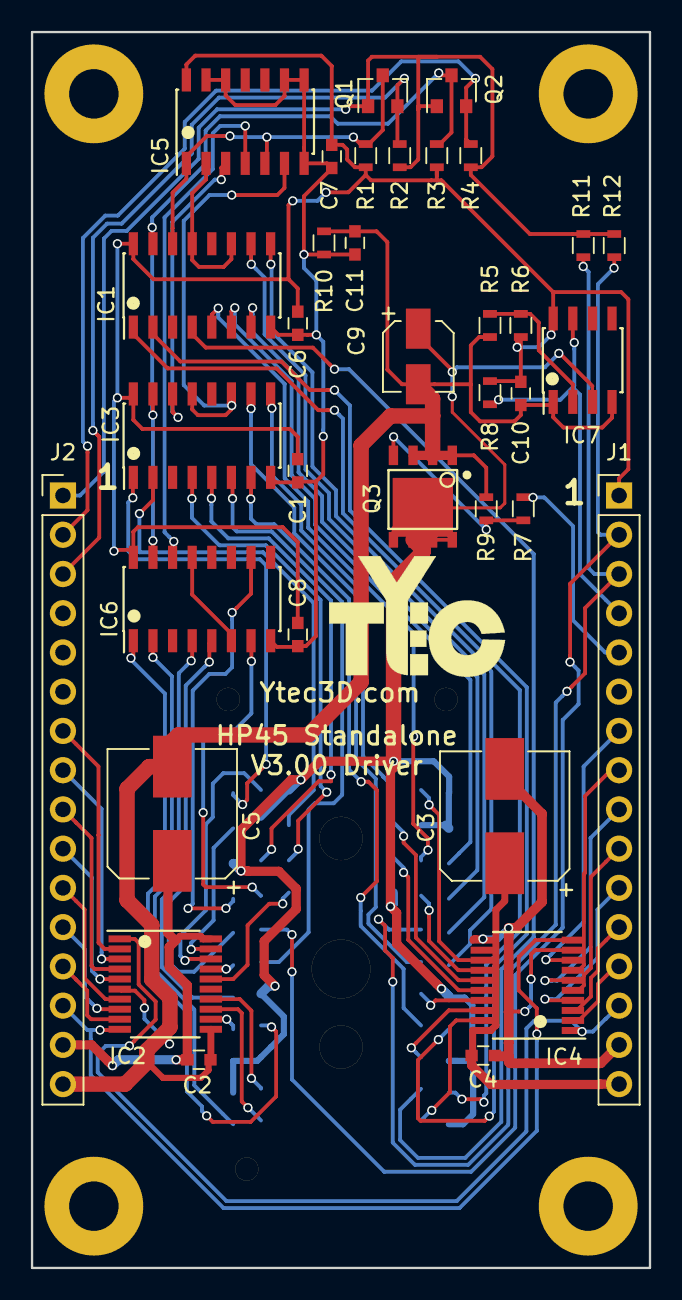
[picture p151: board HP45 Standalone V3.00 Driver.kicad_pcb from above]

Board: 2 copper layers, 40.0 x 80.0 mm, 36 parts (1 on the bottom side), 73 nets.
