MSherbinii/Binder-Jet-3D-Printer/(notices)

Notices in the files:
Oasis source files 20181014/Firmware/HP45_Standalone_V3.00.00/HP45_Standalone_V3.00.00.ino:
HP45 standalone is free software: you can redistribute it and/or modify
it under the terms of the GNU General Public License as published by
the Free Software Foundation, either version 3 of the License, or
(at your option) any later version.
